vophucthinh2006/VEDC2026-Edge-AI-Autonomous-Rescue-Buoy-System/STM32F4/README.md

# RedgeSCUE — Firmware STM32F407

STM32 là lớp điều khiển thời gian thực của phao cứu hộ. Firmware nhận mục tiêu `NAV`
từ Raspberry Pi, đọc BNO055 / GPS / RC receiver, áp dụng watchdog an toàn, và chỉ sau
đó mới phát PWM tới ESC và servo.

- **MCU:** STM32F407VGTx, LQFP100 — board STM32F407G-Discovery
- **Toolchain:** CMake + Ninja + arm-none-eabi-gcc
- **Cấu hình:** STM32CubeMX 6.16.1, STM32Cube FW_F4 V1.28.3

---

## 1. Cấu trúc thư mục

```
STM32F4/
├── STM32F4.ioc            cấu hình CubeMX — NGUỒN SỰ THẬT cho pinout và clock
├── STM32F4.pdf            báo cáo cấu hình do CubeMX sinh (sơ đồ + clock tree)
├── STM32F4.txt            bảng chân dạng văn bản, cùng báo cáo
├── Core/                  code CubeMX sinh ra (main.c, gpio.c, i2c.c, spi.c, tim.c, usart.c, dma.c)
├── Drivers/               CMSIS + STM32F4xx HAL
├── Modules/               mỗi thư mục con là MỘT ngoại vi / thiết bị
│   ├── Actuators/         ESC (PWM trên TIM2) + servo bánh lái, ramp và đảo chiều
│   ├── BNO055/            driver IMU (I2C) + calibration profile
│   ├── GPS/               bộ phân tích NMEA
│   ├── INA226/            cảm biến áp / dòng pin (I2C, chung bus với BNO055)
│   ├── LoRa/              SX1278 (RA-02) qua SPI2
│   ├── Buzzer/            còi PWM
│   └── PiLink/            mã hoá / giải mã khung với Raspberry Pi
├── App/                   tầng ứng dụng
│   ├── control.c/.h       vòng điều khiển + watchdog an toàn, arm khi an toàn, chỉ có AUTO
│   ├── hw_test.c/.h       test bàn servo / ESC / còi qua debugger
│   ├── camera_pan.c/.h    servo camera trượt mượt tới góc CAM (bộ P giới hạn tốc độ, như khớp Gazebo)
│   ├── confirm_button.c/.h đếm số lần nhấn nút xác nhận PE4 (chống dội) để báo lên Pi
│   ├── imu.c/.h           lớp đệm trên driver BNO055
│   ├── lora_beacon.c/.h   beacon, khung sự kiện, cửa sổ nhận sau mỗi khung (mục 14)
│   ├── route_link.c/.h    ráp lộ trình từ dashboard, chuyển cho Pi (`$RTE`)
│   ├── shore_link.c/.h    ACK của trạm: còn liên lạc không, điểm về, lệnh đèn, người tàu khác đã nhận ($SKP, C thuần)
│   ├── event_queue.c/.h   sự kiện người / lật / nút xác nhận, gửi lại tới khi có ACK (C thuần)
│   ├── battery.c/.h       % pin từ INA226
│   ├── lights.c/.h        hai đèn trên relay PC3 / PC2, chỉ theo lệnh dashboard
│   └── app_config.h       ngưỡng, timeout, hằng số PWM
├── Tools/                 dump calibration, dashboard STM32CubeMonitor
├── docs/                  ảnh pinout trích từ STM32F4.pdf
├── build.bat              cmake + ninja → build/Debug/STM32F4.elf
└── flash.bat              nạp qua ST-LINK
```

### Quy tắc phân tầng

```
main.c  →  App/  →  Modules/  →  HAL
```

- `main.c` **chỉ** gọi API của `App/`, không gọi thẳng vào `Modules/`.
- `App/` chứa logic và chính sách: khi nào arm, khi nào dừng, ngưỡng lật, điều khiển heading.
- `Modules/` chứa code nói chuyện với phần cứng. **Một module không được biết gì về tầng
  ứng dụng** — bê sang dự án khác phải chạy được ngay.

> **Ngoại lệ đang tồn tại:** `Modules/Actuators` và `Modules/PiLink` đang include
> `App/app_config.h` để lấy `ESC_*`, `SERVO_*`, `RUDDER_*`, `NAV_TIMEOUT_MS`. Đây là một mũi tên
> ngược chiều, chấp nhận được ở quy mô hiện tại. Muốn dọn sạch thì đưa hằng số phần cứng
> của từng module về chính thư mục module đó, chỉ giữ ngưỡng điều khiển ở `App/`.

`App/imu.c` là lớp đệm giữa driver BNO055 và vòng điều khiển: giữ struct `bno055_euler_t`
phẳng mà `control.c` mong đợi, và map `yaw` của cảm biến thành `heading_deg` của bộ điều
khiển. Hướng dùng trong điều khiển là
`wrap(yaw_bno + IMU_MOUNTING_OFFSET_DEG + MAGNETIC_DECLINATION_DEG)`; góc và offset
dương theo chiều kim đồng hồ. Nhờ vậy `Modules/BNO055/` vẫn là driver thuần.

---

## 2. Pinout

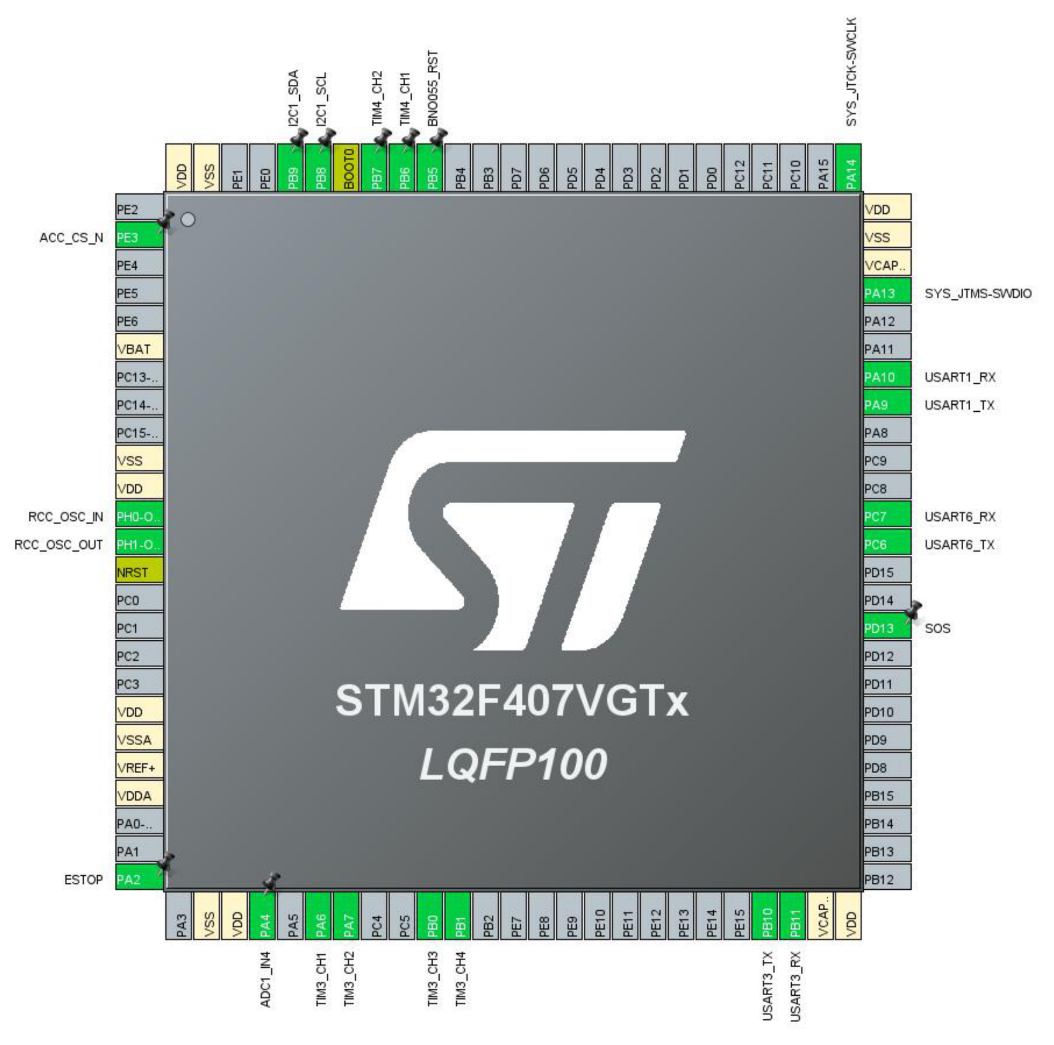
[picture p1: STM32F4/docs/pinout.png]
Pinout STM32F407VGTx


Ảnh trích từ báo cáo CubeMX nên chữ sắc nét. Nguồn sự thật vẫn là `STM32F4.ioc`;
`STM32F4.txt` là bảng chân dạng văn bản do CubeMX sinh, tiện để đối chiếu nhanh.

### Xuất lại ảnh khi đổi pinout

CubeMX **không có lệnh xuất sơ đồ chip ra file ảnh**. Menu `Pinout → Export pinout with /
without Alt. Functions` (`Ctrl+U`) chỉ ra CSV danh sách chân, không phải ảnh.

Đường đi cho ảnh nét là qua báo cáo PDF, vì sơ đồ trong đó là vector:

1. Trong CubeMX: **Project → Generate Reports** → ghi đè `STM32F4.pdf` và `STM32F4.txt`
2. Sơ đồ nằm ở **trang 3** của PDF. Trích ra PNG 300 DPI:

```
pdftoppm -png -r 300 -f 3 -l 3 STM32F4.pdf docs/raw
```

3. Cắt bỏ tiêu đề trang và lề trắng, rồi lưu thành `docs/pinout.png`
4. Xoá file `docs/raw-03.png`
5. Cập nhật bảng dưới đây cho khớp

Chụp màn hình cũng ra ảnh nhưng chữ sẽ mờ tới mức đọc nhầm `TIM4_CH1` thành `TIM1_CH1` —
mà PB6 không hề có TIM1. Đừng dùng cách đó cho tài liệu.

`STM32F4.pdf` và `STM32F4.txt` được commit cùng repo để người chưa cài CubeMX vẫn tra được
cấu hình đầy đủ: pinout, clock tree, tham số từng ngoại vi, và bảng tiêu thụ điện.

| Chức năng | Peripheral | Chân | Tham số | Nối tới |
|---|---|---|---|---|
| UART Raspberry Pi | UART4 | PC10 TX, PC11 RX | 115200 8N1, RX interrupt | Pi GPIO15/RXD0 ← PC10; Pi GPIO14/TXD0 → PC11 |
| GPS Holybro M10 V2 | USART3 | PB10 TX, PB11 RX | 9600 8N1, RX interrupt | GPS TX → PB11; GPS RX ← PB10 |
| (không dùng) USART2 | USART2 | PA2 (single-wire half-duplex) | 115200 8N1 | từng là iBUS của receiver FS-iA6B; đã bỏ tay cầm, firmware không đọc nữa (CubeMX vẫn khởi tạo) |
| IMU BNO055 | I2C3 | PA8 SCL, PC9 SDA | Fast Mode 400 kHz | địa chỉ 0x28 (ADD = GND) |
| Pin INA226 | I2C1 | PB8 SCL, PB9 SDA | 0x40 (A0 = A1 = GND) | IN+ / IN− nối tiếp đường pin; đo shunt của module rồi đặt `INA226_SHUNT_OHM` |
| Reset BNO055 | GPIO_Output | PB5 | mức cao khi chạy | chân nRESET của module |
| ESC sau trái | TIM2_CH1 | PA5 | PWM 50 Hz, một chiều, **dừng và kích hoạt = 1500 µs**, **ga 1550–2000 µs** | chỉ dây signal + GND |
| ESC sau phải | TIM2_CH4 | PA3 | PWM 50 Hz, một chiều, **dừng và kích hoạt = 1500 µs**, **ga 1550–2000 µs** | chỉ dây signal + GND |
| ESC trước | TIM2_CH2 | PA1 | PWM 50 Hz, **hai chiều**, dừng = 1500 µs, **tiến < 1500 µs** (`ESC_FRONT_DIR -1`), kích hoạt chậm hơn hai ESC sau 2–3 s | chỉ dây signal + GND |

**Ngưỡng ESC đã chốt trên giá (2026-10-20), không đổi khi chưa thử lại trên giá:**
- ESC sau: dừng và kích hoạt **1500 µs** (`ESC_REAR_STOP_US`), ga **1550–2000 µs** (`ESC_REAR_START_US`,
  `ESC_REAR_MAX_US`). **Không bao giờ kích hoạt ESC sau bằng 1000 µs**: kích hoạt từ 1000 µs thì ESC sau
  phải không nhận lệnh, nên chỉ motor sau trái quay.
- `ESC_REAR_STOP_US` chỉ là mức dừng của ESC sau. Giới hạn dưới chung của cả ba ESC là `ESC_MIN_US` (1000 µs),
  vì ESC trước đẩy tới bằng xung dưới 1500 µs: đừng dùng mức dừng của ESC sau để kẹp xung ESC trước.
- ESC trước (ZTW Shark) cần đứng ở trung tính lâu hơn mới kích hoạt: tới 2–3 s sau hai ESC sau. Sau khi bật nguồn
  hay nạp lại F407, đợi khoảng 6 s rồi mới cho chạy (`test_motor.bat` tự đợi).
| Servo camera | TIM3_CH1 | PA6 | PWM 50 Hz, 1500 µs ± 11 µs/độ, 600–2400 µs (±80°) | cấp nguồn servo độc lập |
| Bánh lái trước | TIM3_CH2 | PA7 | PWM 50 Hz, tâm `SERVO_CENTER_FRONT_US` | cấp nguồn servo độc lập |
| Bánh lái trái | TIM3_CH3 | PB0 | PWM 50 Hz, tâm `SERVO_CENTER_LEFT_US` | cấp nguồn servo độc lập |
| Bánh lái phải | TIM3_CH4 | PB1 | PWM 50 Hz, tâm `SERVO_CENTER_RIGHT_US` | cấp nguồn servo độc lập |
| Còi | TIM8_CH3 | PC8 | PWM 4 kHz | qua transistor |
| Nút xác nhận "đã lấy đồ" | GPIO_EXTI (nhãn CubeMX `ESTOP`) | PE4 | **pull-up**, nhấn = mức thấp | nút thường mở → GND |
| Đèn 1 (RELAY1) | GPIO_Output | PC3 | khởi tạo mức thấp | module relay; **chỉ bật theo lệnh admin trên dashboard** (mục 14) |
| Đèn 2 (RELAY2) | GPIO_Output | PC2 | khởi tạo mức thấp | như trên; relay đóng ở mức thấp thì đặt `RELAY_ON_LEVEL 0` |
| Chip select accelerometer | GPIO_Output | PE3 | **giữ mức cao** | không nối gì — xem mục 3 |
| Battery sense | ADC1_IN4 | PA4 | rank 1, 3 cycles — **chưa dùng trong code** | qua cầu chia áp |
| LoRa RA-02 (SX1278) | SPI2 | PB13 SCK, PB14 MISO, PB15 MOSI | mode 0, ~2.6 Mbit/s | NSS → PB12, RST → PC4, DIO0/1/2 → PE11/PE12/PE13 (DIO chưa dùng), 3.3 V, GND, **anten 433 MHz** |
| Debug | SWD | PA13 SWDIO, PA14 SWCLK | — | ST-LINK trên board (CN1) |
| Thạch anh | RCC | PH0, PH1 | khai báo sẵn, **chưa dùng** | xem mục 5 |

### Vì sao TIM2/TIM3 dùng prescaler 83 và period 19999

APB1 chạy 42 MHz, hệ số chia khác 1 nên **timer clock của APB1 là 84 MHz**:

```
84 MHz / (83 + 1)  = 1 MHz   →  1 tick = 1 µs
(19999 + 1) tick   = 20 ms   →  50 Hz
```

Giá trị compare vì vậy viết thẳng bằng micro-giây:
`__HAL_TIM_SET_COMPARE(&htim3, TIM_CHANNEL_1, 1500)` cho ra xung 1500 µs. Các hằng số
`ESC_REAR_STOP_US`, `SERVO_CENTER_US` trong `App/app_config.h` dùng trực tiếp, không phải quy đổi.

---

## 3. Ba ràng buộc của board Discovery

Board Discovery có sẵn cảm biến, codec âm thanh và cổng USB nối cứng vào một số chân.
Ba điều dưới đây là bắt buộc, không phải khuyến nghị.

**PE3 phải luôn ở mức cao.** Cảm biến gia tốc LIS3DSH trên board dùng chung SPI1 với
PA6/PA7, mà **PA6 là MISO — chân xuất của cảm biến**. Nếu PE3 (chip select) không được giữ
cao, cảm biến được chọn và sẽ đẩy tín hiệu chống lại PWM của TIM3_CH1, làm xung ESC trái
méo hoặc mất hẳn. `MX_GPIO_Init()` đặt PE3 lên cao trước khi timer chạy.
**Không bật SPI1 trong CubeMX.**

**Không cắm gì vào cổng USB OTG (CN5).** PA9/PA10 là VBUS và ID của cổng đó. Cắm thiết bị
vào là 5 V trên VBUS chống lại chân USART1_TX. Chỉ dùng CN1 (ST-LINK) để nạp và cấp nguồn.

**BNO055 dùng I2C3: PA8 là SCL, PC9 là SDA.** Hai chân này thay thế hoàn toàn PB8/PB9
cho IMU. Đường I2C phải có pull-up lên 3.3 V (nhiều GY-BNO055 đã có sẵn); nếu `BNO055_Init()`
trả `ERR_I2C`, kiểm tra dây, nguồn 3.3 V/GND và pull-up 4.7 kΩ. PB8/PB9 vẫn là I2C1 riêng
cho INA226. **Không bật I2S2/I2S3** vì PC7 và PB10 dính vào codec và micro MEMS.

---

## 4. PE4: nút xác nhận, không phải E-stop

PE4 (nhãn CubeMX vẫn là `ESTOP`) là nút người được cứu nhấn khi **đã lấy đồ tiếp tế**. Pull-up
nội, nút thường mở nối xuống GND: nhấn là mức thấp. `App/confirm_button.c` chống dội
(`CONFIRM_DEBOUNCE_MS`) và đếm số lần nhấn; số đếm đi lên Pi ở trường thứ 8 của `$SYS`, Pi
phát loa "Đã xác nhận lấy đồ" mỗi khi số đếm tăng. Nút **không dừng gì cả**.

Mỗi lần nhấn, F407 còn gửi sự kiện `C` qua LoRa (mục 14): dashboard báo "đã lấy đồ" kèm vị trí phao.

Xuồng không có đầu vào E-stop riêng và không còn tay cầm. Motor dừng khi: admin gửi **lộ trình rỗng** từ
dashboard (tới phao sau khoảng 5–10 s qua LoRa), thuyền đi hết lộ trình, Pi im hoặc gửi STOP, xuồng lật,
IMU lỗi, hoặc tắt nguồn (mục 13).

---

## 5. Clock

Hiện chạy **HSI 16 MHz** → PLL (M=8, N=168, P=2) → **168 MHz**. APB1 42 MHz, APB2 84 MHz.

HSI được trim ±1% ở 25 °C và trôi thêm theo nhiệt độ. UART bất đồng bộ có tổng ngân sách
sai lệch khoảng 3% chia cho cả hai đầu, nên ở 115200 (với Pi) biên
còn lại khá mỏng — mà phao phơi nắng rồi xuống nước là môi trường trôi nhiệt độ mạnh.

**Việc cần làm trước khi thử ngoài nước:** chuyển sang HSE 8 MHz trong CubeMX
(PLLM=8, PLLN=336, PLLP=2, PLLQ=7). Nếu nạp xong thấy treo trong `SystemClock_Config()`
thì HSE không phải thạch anh mà lấy từ MCO của ST-LINK — đổi RCC sang
`BYPASS Clock Source`, vẫn 8 MHz.

PH0/PH1 đã khai báo sẵn là HSE oscillator, để dành cho lần chuyển đó.

---

## 6. Quy trình làm việc

### Nguyên tắc vàng

> **`STM32F4.ioc` là nguồn sự thật cho pinout, clock và cấu hình ngoại vi.
> Không bao giờ sửa tay file trong `Core/`.**

CubeMX ghi đè `Core/` mỗi lần Generate. Code viết tay đặt sai chỗ sẽ biến mất không báo
trước. Chỉ có hai nơi an toàn: thư mục `Modules/` và `App/`, hoặc bên trong các block
`/* USER CODE BEGIN x */ ... /* USER CODE END x */` của file CubeMX sinh ra.

### A. Khi cần thêm hoặc đổi một ngoại vi

Đổi chân, đổi baud, thêm UART, thêm timer, đổi clock, bật interrupt, bật DMA — tất cả đều
làm trong CubeMX, **không sửa tay**.

1. Mở `STM32F4.ioc` bằng STM32CubeMX
2. Sửa trong tab **Pinout & Configuration** hoặc **Clock Configuration**
3. Nếu chân đang bị ngoại vi khác chiếm: click vào chân đó chọn `Reset_State` để giải
   phóng trước, nếu không CubeMX báo conflict
4. Bật interrupt ở tab **NVIC Settings** của chính ngoại vi đó nếu cần
5. Kiểm tra tab **Project Manager**: Toolchain/IDE phải là **CMake**, và
   **Keep User Code when re-generating** phải được tick
6. **GENERATE CODE** (`Alt + K`)
7. Xuất lại ảnh pinout vào `docs/pinout.png` và cập nhật bảng ở mục 2
8. Build lại

Sau khi Generate, `Core/Src/main.c` sẽ có thêm lời gọi `MX_<PERIPH>_Init()` và một file
`Core/Src/<periph>.c` mới. Đừng hoảng khi thấy `main.c` thay đổi — phần code trong các
block `USER CODE` được giữ nguyên.

### B. Khi viết code ứng dụng

Câu hỏi đầu tiên: **code này nói chuyện với phần cứng, hay quyết định chính sách?**

| Loại code | Đặt ở | Ví dụ |
|---|---|---|
| Driver một thiết bị, giải mã một giao thức | `Modules/<Tên>/` | đọc cảm biến mới, parse khung LoRa |
| Logic điều khiển, ngưỡng, chính sách an toàn | `App/` | thêm chế độ chạy, đổi luật arm |
| Hằng số chỉnh định | `App/app_config.h` | ngưỡng lật, timeout |
| Khởi tạo lúc boot, vòng lặp chính | block `USER CODE` trong `Core/Src/main.c` | gọi `Xxx_Init()` |

**Thêm một module mới — checklist:**

1. Tạo `Modules/<Tên>/<ten>.c` và `<ten>.h`
2. Thêm vào `CMakeLists.txt` ở **hai** chỗ:
   - `target_sources(...)` → `Modules/<Tên>/<ten>.c`
   - `target_include_directories(...)` → `Modules/<Tên>`
3. Gọi `<Ten>_Init()` trong block `USER CODE BEGIN 2` của `main.c`
4. Nếu module cần chạy định kỳ, gọi trong block `USER CODE BEGIN 3` theo nhịp
   `CONTROL_PERIOD_MS`
5. Nếu module nhận dữ liệu qua UART interrupt, thêm nhánh vào `HAL_UART_RxCpltCallback()`
   trong block `USER CODE BEGIN 4`

**Các block USER CODE trong `main.c` và vai trò:**

| Block | Dùng cho |
|---|---|
| `Includes` | `#include` của `Modules/` và `App/` |
| `PV` | biến toàn cục của ứng dụng |
| `0` | hàm static dùng nội bộ trong `main.c` |
| `2` | khởi tạo, chạy sau khi các `MX_*_Init()` đã xong |
| `3` | thân vòng lặp chính — **dấu `}` đóng `while(1)` nằm bên trong block này** |
| `4` | callback của HAL, ví dụ `HAL_UART_RxCpltCallback` |

Cái bẫy ở block `3` đáng nhớ: CubeMX đặt dấu ngoặc đóng của `while(1)` *bên trong* vùng
USER CODE. Thay toàn bộ nội dung block mà quên chép lại dấu `}` sẽ ra lỗi
`expected declaration or statement at end of input` ở tận cuối file.

### C. Build

```
build.bat            # Debug, mặc định
build.bat Release
```

Kết quả: `build/Debug/STM32F4.elf`. Script tự chạy `cmake` rồi `ninja`.

Build phải sạch, không có warning.

### D. Nạp

```
flash.bat
```

Cần ST-LINK cắm vào CN1. **Đóng STM32CubeMonitor trước khi nạp** — nó giữ probe.

---

## 7. STM32CubeMonitor

`Tools/CubeMonitor/BNO055_Flow.json` vẽ trực tiếp các biến toàn cục của firmware qua SWD,
không cần dừng chương trình.

1. Mở STM32CubeMonitor → menu ☰ → **Import** → chọn `Tools/CubeMonitor/BNO055_Flow.json`
2. Double-click node **myProbe_Out**, bấm refresh ở ô Probe, chọn ST-LINK đang cắm.
   Làm y hệt với **myProbe_In** — hai node phải cùng một probe
3. Bấm **Deploy**
4. Mở Dashboard (biểu tượng ở panel phải, hoặc `http://localhost:1880/ui`)
5. Bấm **START Acquisition**

### ⚠ Địa chỉ sẽ lệch sau khi sửa firmware

CubeMonitor đọc biến bằng **địa chỉ RAM thô**, không phải bằng tên symbol. Bất kỳ thay đổi
nào thêm hoặc bớt biến toàn cục đều làm layout RAM dịch, và flow sẽ lặng lẽ vẽ nội dung
nằm ở địa chỉ cũ — dashboard trông vẫn chạy nhưng số liệu sai. Kiểu hỏng này khó phát hiện
hơn lỗi báo thẳng.

Đọc lại địa chỉ sau khi sửa:

```
arm-none-eabi-gdb --batch -ex "print/x (int)&bno055_euler.roll" build/Debug/STM32F4.elf
```

Hoặc trỏ node `variables` vào file ELF và bấm Import để CubeMonitor tự phân giải tên.

### Các biến được xuất có chủ đích

`App/imu.c` cố ý để những biến sau là **toàn cục, không `static`**, đúng tên:

| Biến | Dùng bởi |
|---|---|
| `hbno055` | dashboard — `ext_crystal_active`, `sys_err` |
| `bno055_euler` | dashboard — Roll / Pitch / Yaw |
| `bno055_calib` | dashboard — trạng thái hiệu chuẩn |
| `bno055_init_status`, `bno055_read_status` | dashboard |
| `bno055_calib_captured`, `bno055_calib_captured_valid` | `Tools/bno055_dump_calib.ps1` đọc từ ELF |

**Đừng gói chúng vào struct hay thêm `static`** — sẽ làm hỏng cả dashboard lẫn script dump
calibration mà không có lỗi biên dịch nào cảnh báo.

---

## 8. Hiệu chuẩn BNO055

Calibration profile được chia sẻ qua git ở `Modules/BNO055/bno055_calib_profile.h`, nên mọi
bộ kit nạp cùng một profile và có heading dùng được ngay khi khởi động, không phải vẫy hình
số 8 trước mỗi lần chạy.

Profile thuộc về **module BNO055 và cách gá lắp của nó**, không thuộc về board STM32. Sinh
lại khi đổi module hoặc đổi vị trí gá:

1. Nạp firmware, để chạy
2. Hiệu chuẩn tới khi `bno055_calib` báo `3/3/3/3` (xem trên dashboard)
3. Đóng CubeMonitor
4. Chạy `Tools\bno055_dump_calib.bat` — target vẫn đang chạy, không cần dừng
5. Commit `Modules/BNO055/bno055_calib_profile.h` mới

---

## 9. Bảng tra lỗi

`bno055_init_status` là enum `BNO055_Status_t`:

| Giá trị | Tên | Nguyên nhân thực tế |
|---|---|---|
| 0 | `BNO055_OK` | chạy tốt |
| 1 | `ERR_PARAM` | lỗi code, không xảy ra khi dùng bình thường |
| 2 | `ERR_I2C` | NACK hoặc lỗi bus — sai dây SCL/SDA tại PA8/PC9, thiếu pull-up lên 3.3 V, hoặc còn cắm ở PB8/PB9 cũ |
| 3 | `ERR_TIMEOUT` | cảm biến không sẵn sàng kịp — nguồn yếu, hoặc chân reset kẹt mức thấp |
| 4 | `ERR_CHIP_ID` | bus thông nhưng CHIP_ID ≠ 0xA0 — nhiều khả năng sai địa chỉ, thử 0x28 |
| 5 | `ERR_MODE` | ghi OPR_MODE nhưng đọc lại không khớp |
| 6 | `ERR_SYS` | cảm biến báo lỗi hệ thống — đọc thêm `hbno055.sys_err` |
| 7 | `ERR_PROFILE` | calibration profile nằm ngoài dải hợp lệ của data sheet |

Triệu chứng khác:

| Hiện tượng | Nguyên nhân thường gặp |
|---|---|
| Xuồng không bao giờ arm được | BNO055 không đọc được (`heading_debug.arm_block` = 1, IMU stale) hoặc xuồng nghiêng quá `MAX_PITCH_DEG` / `MAX_ROLL_DEG` (= 2) — xem mục 8 và 13 |
| Đã arm mà motor không chạy | Pi không lái: chưa có lộ trình từ dashboard, Pi gửi STOP (`gps_stale_or_no_fix`, `no_goal`...) hoặc Pi im (`heading_debug.block` = 2) |
| GPS không có fix, `gps.fix` = 0 | baud USART3. Holybro M10 nhiều khả năng mặc định **38400** chứ không phải 9600 — xác minh bằng u-center |
| PWM ESC trái méo hoặc mất | PE3 không ở mức cao → LIS3DSH đang đẩy tín hiệu vào PA6 |
| `bno055_read_status` thỉnh thoảng nhảy 2 | nhiễu I2C — dây dài, thiếu pull-up tại PA8/PC9 |
| Dashboard vẽ số vô lý | địa chỉ trong flow đã lệch sau khi sửa firmware — xem mục 7 |
| Treo trong `SystemClock_Config()` | chỉ xảy ra sau khi chuyển sang HSE — đổi sang `BYPASS Clock Source` |

---

## 10. Nguồn và an toàn phần cứng

- GY-BNO055 nhận 3–5 V nhưng bus I2C của STM32 là 3.3 V: **cấp module ở 3.3 V**. Không để
  pull-up SDA/SCL lên 5 V.
- **Không cấp DS51150 12 V hoặc ESC từ chân của board Discovery.** UBEC hoặc power board
  phải cấp đúng áp và đủ dòng. Tất cả thiết bị tín hiệu cần chung GND.
- **Pixhawk 4 không được nối PWM điều khiển song song với STM32.** Firmware này giả định
  STM32 là **nguồn phát PWM duy nhất**. Giữ Pixhawk tách khỏi đường signal, hoặc chuyển
  toàn bộ quyền điều khiển sang Pixhawk. Không chạy hai autopilot song song.
- **`ACTUATORS_ENABLED` đang là 1** (đã thử chiều motor trên gá). Đặt về 0 thì ESC luôn nhận tín hiệu dừng,
  còn bánh lái vẫn chạy theo lệnh; giá trị ESC lẽ ra được phát nằm trong `actuator_debug`
  để kiểm tra bằng debugger. Chỉ đổi sang 1 sau khi đã xác nhận chiều quay motor và chiều servo
  trên giá đỡ, và **không tháo chân vịt khi kiểm thử bàn**.
- Khi test IMU hoặc UART, **đừng cắm ESC**. PWM vẫn phát thật trên
  PA1/PA3/PA5 (ESC) và PA6/PA7/PB0/PB1 (servo).

---

## 11. Giao thức với Raspberry Pi

Raspberry Pi → STM32:

```
$NAV,seq,AUTO|STOP|MANUAL|BACK,speed_mps,heading_deg,ttl_ms*CS\n
$HBT,seq,reason[,route_rev[,mission,wp/total[,fps_x10]]]*CS\n
$SOS,seq,0|1*CS\n
$TXD,seq,event,lat,lon,confidence[,risk]*CS\n
$CAM,seq,pan_deg*CS\n
```

`BACK`: lùi ra khỏi vật cản đang chắn mũi. Hai motor sau tắt (ESC một chiều), bánh lái về giữa, motor
trước quay ngược với ga bằng `speed_mps` (tối đa `FRONT_BACK_MAX` 0.40, `App/app_config.h`). Phải qua
cùng các điều kiện như `AUTO`: đã arm, IMU còn mới, NAV trong TTL, HBT còn mới, không bị DỪNG từ dashboard.
Pi chỉ gửi khi thuyền đứng yên, không còn hướng thoát phía trước và phía sau trống (`navigation.py`,
lý do `backing_off`), mỗi lần tối đa 3 s. F407 cũ không biết `BACK` thì coi là `STOP`.

STM32 → Raspberry Pi:

```
$IMU,seq,pitch,roll,yaw,imu_ok,overturned*CS\n
$GPS,seq,lat,lon,fix,hdop,speed,course*CS\n
$SYS,seq,battery_v,motor_fault,estop,link_ok,armed,auto,confirm_presses,battery_pct*CS\n
$LNK,seq,shore_ok,heard_ago_s,home_valid,home_lat,home_lon,hold,ret*CS\n     (mỗi giây)
$SKP,seq,lat,lon*CS\n                                                  (một lần mỗi khi ACK mang người cần bỏ qua)
$ACK,seq,TXD,ACCEPTED*CS\n
$RTE,seq,rev,first,total,loop,lat;lon,...*CS\n
```

`$RTE` là lộ trình admin gửi từ dashboard qua trạm bờ LoRa (`App/route_link.c`, đặc tả ở
[docs/lora-route-downlink.md](../docs/lora-route-downlink.md)): mỗi chu kỳ telemetry một dòng tối đa 7 điểm, gửi lại
tới khi `$HBT` của Pi mang `route_rev` bằng `rev`. Sau mỗi beacon LoRa phao nghe 1.5 s để nhận khung `RTE` của trạm;
đang nhận dở thì beacon 1.5 s một lần, và cuối beacon có `w=rev:have:pi`.

`armed` (xuồng an toàn để chạy: IMU mới, không lật) và `auto` (luôn 1, không còn công tắc SwB) để Pi biết lúc nào cho
camera quét tìm. `estop` luôn 0
(PE4 giờ là nút xác nhận); `confirm_presses` là số lần nhấn nút đó từ lúc khởi động. Mỗi gói
`TXD` có sự kiện `VICTIM_FOUND` làm tăng số người đã báo, số này đi theo khung LoRa (mục LoRa, trường `v`).

`CAM` là góc quay camera, dương sang phải, giới hạn `CAM_PAN_LIMIT_DEG`. `App/camera_pan.c` cho servo
trượt tới góc đó (`CAM_PAN_SMOOTH_KP`, tối đa `CAM_PAN_MAX_RATE_DPS`); Pi gửi 20 lần/s khi quét hoặc bám người.

`$TXD,...,VICTIM_FOUND|VICTIM_UPDATE,lat,lon,confidence,risk`: vị trí người Pi ước tính (0, 0 = không có), `risk` 0
an toàn, 1 trung bình, 2 cao, 3 nguy kịch (Pi cũ không gửi: coi là 2). `VICTIM_FOUND` là người mới (tăng số người
`v`), `VICTIM_UPDATE` là mức rủi ro hoặc vị trí mới của người đang bám (không đếm lại). Cả hai thành sự kiện `V` qua
LoRa (mục 14).

`$SYS`: `battery_v` là điện áp INA226 (0 khi chưa đọc được), `battery_pct` 0..100 (−1 chưa biết).
`$LNK`: `shore_ok` = 0 khi trạm bờ đã từng nghe mà im quá 60 s (`SHORE_LINK_TIMEOUT_MS`); Pi đưa thuyền về
`home` = điểm đỗ của phao hoặc vị trí GPS của trạm (lấy từ ACK). `heard_ago_s` −1 khi chưa từng nghe; lat/lon trống
khi chưa có điểm về. `ret` = 1 khi admin gọi phao về bờ (bit 3 của lệnh, [docs/fleet-control.md](../docs/fleet-control.md)):
Pi đưa thuyền về điểm đỗ và giữ ở đó tới khi admin cho chạy tiếp.

Checksum là XOR của các ký tự ASCII giữa `$` và `*`, giống `Rasp_Pi/utils/nmea_packet.py`.

`NAV` và `HBT` phải mới hơn 300 ms. Nếu sai checksum, BNO055 lỗi, nghiêng
quá `MAX_PITCH_DEG` / `MAX_ROLL_DEG`, hoặc Pi im — output ESC lập tức về stop.

Giữ hướng dùng PID trong `App/heading_controller.c`: `u = Kp·e + Ki·∫e − Kd·yaw_rate`,
`u ∈ [-1, 1]`, dương là quay mũi sang phải. Khâu D lấy từ **gyro Z** của BNO055 (qua lọc thông
thấp 5 Hz), nên đổi đích không gây giật. Trong deadband 2° khâu P nghỉ, tích phân được giữ.
`Heading_Mix` đưa `u` ra cả **bánh lái** (`u·HEADING_RUDDER_GAIN`) và **chênh ga** hai motor
sau (`u·HEADING_DIFF_GAIN`, chia quanh ga chung, không motor nào dưới 0). Pi gửi tốc độ 0 thì
motor dừng, không xoay tại chỗ. Tham số trong `App/app_config.h`.

Hướng đích là gói `NAV` của Pi (AUTO, chế độ duy nhất).

Theo dõi trực tiếp: `python Tools/heading_monitor.py` (thêm `--csv run.csv` để ghi log).
AUTO yêu cầu IMU mới không quá 100 ms cùng NAV/HBT còn hạn. Pi gửi STOP, disarm hoặc mất
bất kỳ nguồn dữ liệu nào sẽ dừng motor và xóa tích phân. Các hằng số nằm trong
`App/app_config.h`; chỉ tuning trên nước sau khi đã thử khô với chân vịt tháo rời.

---

## 12. Quy ước đóng góp

Theo các skill của Claude trong `.claude/skills/` (`stm32-cubemx-first`, `git-commit-pr`):

1. **Cấu hình CubeMX trước, code sau.** Việc gì làm được trong `.ioc` thì làm ở đó, đừng
   sửa tay `Core/`.
2. **Chia thay đổi thành nhiều commit theo từng phần logic**, không gộp thành một commit
   khổng lồ. Commit đổi `.ioc` nên tách khỏi commit code CubeMX sinh ra, để người review
   đọc được quyết định pinout mà không bị chìm trong vài nghìn dòng HAL.
3. Mỗi PR có description ngắn gọn nêu rõ những gì thay đổi về phần cứng.

Trước khi mở PR, kiểm tra tối thiểu:

- `build.bat` chạy sạch, không có warning
- Nếu sửa `.ioc`: đã chạy **Project → Generate Reports**, commit `STM32F4.pdf` +
  `STM32F4.txt` mới, trích lại `docs/pinout.png`, và cập nhật bảng mục 2
- Nếu thêm hoặc bớt biến toàn cục: đã kiểm tra lại địa chỉ trong
  `Tools/CubeMonitor/BNO055_Flow.json`
- Nếu đổi chân: đã ghi rõ trong PR rằng **phần cứng phải đổi dây**

---

## 13. Không có tay cầm: arm và chạy

Thuyền **không còn tay cầm RC** (FS-i6 / FS-iA6B, chế độ MANUAL đã bỏ). `App/control.c`:

- **Arm** khi an toàn: IMU mới (hoặc `BENCH_IGNORE_IMU` trên gá) và không lật. Không cần công tắc;
  còi kêu 1 tiếng khi arm, 2 tiếng khi disarm. Lý do không arm: `heading_debug.arm_block`.
- **AUTO là chế độ duy nhất.** Motor chỉ chạy khi Pi đang lái: gói `NAV` AUTO còn hạn (TTL 300 ms) và
  `HBT` mới hơn `HBT_TIMEOUT_MS`. Lý do không chạy: `heading_debug.block`.
- **Pi chỉ lái theo lộ trình gửi từ dashboard** (`config/boat_stm32.yaml`: `mission.waypoints_from_file: false`,
  `follow.only_on_route: true`). Chưa có lộ trình, đã nhận lộ trình rỗng hoặc đã đi hết thì Pi gửi STOP và
  không bám người. Đang chạy lộ trình thì vẫn bám người thấy được.

| Muốn | Làm |
|---|---|
| Chạy | dashboard: vẽ lộ trình, **Gửi tới phao** (tới phao sau khoảng 5–40 s tùy số điểm) |
| Dừng tại chỗ, giữ lộ trình | dashboard: nút **DỪNG PHAO** (F407 khóa motor sau khoảng 5–10 s); **CHẠY TIẾP** để đi tiếp |
| Bỏ lộ trình | dashboard: xóa lộ trình rồi **Gửi tới phao** (lộ trình rỗng, tới phao sau khoảng 5–10 s) |
| Dừng ngay tại chỗ | tắt nguồn ESC / thuyền: **không còn công tắc ngắt cầm tay** |

Chi tiết đường đi của lộ trình và việc phao không tự chạy lại lộ trình cũ sau khi bật nguồn:
[docs/lora-route-downlink.md](../docs/lora-route-downlink.md).

Tăng ga bị giới hạn tốc độ (`ESC_RAMP_PER_S`), giảm ga có hiệu lực ngay. Chiều bánh lái `RUDDER_DIR_*` nằm trong
`App/app_config.h`.

**Motor trước** (hai chiều, `App/front_motor.c`):
- **Đẩy tới cùng hai motor sau:** ga trước = ga sau × `FRONT_THRUST_GAIN`.
- **Hãm** mỗi khi ga giảm ít nhất `FRONT_BRAKE_MIN_DROP`, gồm cả lúc Pi giảm tốc, gửi tốc độ 0 / STOP, Pi im, hay DỪNG từ
  dashboard. Motor trước đảo chiều ở `FRONT_BRAKE_LEVEL` trong `FRONT_BRAKE_MS_PER_THROTTLE` ms cho mỗi đơn vị ga giảm
  (0.3 → 600 ms), tối đa `FRONT_BRAKE_MAX_MS`, cộng thêm `ESC_FRONT_REVERSE_DELAY_MS` để ESC nghỉ ở neutral trước khi đảo.
- **Không hãm** khi lật, mất IMU hay disarm: mọi motor tắt ngay.
- Hai ESC sau chạy một chiều nên không tự phanh được. Muốn tắt motor trước như cũ: đặt `GAIN` và `LEVEL` bằng 0.
- Chỉnh trên nước: phao phải dừng trong khoảng một thân mà không lùi lại.

**Trước khi bật `ACTUATORS_ENABLED`**, thử từng motor và bánh lái trên gá bằng `..\scripts\stm32\test_motor.bat`
(preset `HwTest`, `App/hw_test.c`): đúng chiều quay, đúng chân PA1 / PA3 / PA5. Sau đó với Pi chạy
`config/bench_demo.yaml`, đứng lệch sang phải camera thì bánh lái phải kéo mũi sang phải (sai thì đổi dấu
`RUDDER_DIR_FRONT` / `RUDDER_DIR_REAR`).

---

## 14. LoRa: phát vị trí và tư thế về trạm bờ

`App/lora_beacon.c` + `Modules/LoRa/sx127x.c` phát vị trí GPS về trạm bờ (ESP32-S3) mỗi
`LORA_BEACON_PERIOD_MS` (5 giây). Không chặn: mỗi vòng lặp chỉ làm vài lệnh SPI ngắn, gói ~0.4 giây
trên không được theo dõi bằng máy trạng thái nên `Control_Tick` (10 ms) không bị trễ.

Tham số radio (`App/app_config.h`) **phải khớp trạm** (`esp32-lora-station/main/main.c`):
433 MHz, SF9, BW 125 kHz, CR 4/5, sync word `0xF3`, PA_BOOST 17 dBm, CRC payload bật.

Khung gửi, một dòng text tối đa 120 ký tự:

```
id=PHAO-01,10.762622,106.660172,r=2.1,p=-1.4,y=278.5,t=280.0,m=A,i=1,c=3,q=12,v=0,w=7:12:1,L=1,b=87,g=276.0,s=0.25
id=PHAO-01,NO_FIX,r=2.1,p=-1.4,y=278.5,t=-1.0,m=S,i=0,c=0,q=13,v=1,L=0,b=87
```

Sau `v` là các trường tùy chọn, mỗi trường chỉ thêm khi còn chỗ, theo thứ tự ưu tiên: `w` tiến độ lộ trình,
`H` đang bị dừng từ dashboard (1/0), `L` đèn đang bật (bit 0 PC3, bit 1 PC2), `b` % pin, `g` hướng đi thật theo GPS (course over ground), `s` tốc độ m/s.
`m=R`: đang tự chạy về trạm vì mất liên lạc.

**Sự kiện** đi trong khung riêng, phát ngay và phát lại mỗi 1.5 s tới khi trạm ACK (tối đa 10 lần,
`App/event_queue.c`):

```
ev=PHAO-01,<eseq>,V,<lat>,<lon>,<risk>,<conf>,<n>     người (vị trí Pi ước tính, mức rủi ro, độ tin cậy)
ev=PHAO-01,<eseq>,T,<lat>,<lon>,<roll>,<pitch>         lật / nghiêng quá 35°, GPS của phao; lặp lại sau 30 s nếu vẫn lật
ev=PHAO-01,<eseq>,C,<lat>,<lon>,<presses>              nút PE4: người đã lấy đồ tiếp tế
```

**Trạm trả lời mọi khung** trong cửa sổ 1.5 s: khung `RTE` khi phao còn thiếu lộ trình, ngược lại
`ACK,<id>,<eseq>,<lệnh>,<lat>,<lon>[,<dẫn đầu>,<phải m>,<sau m>]*CS` (`App/shore_link.c`). `<lệnh>` 0..15: bit 0–1 hai
đèn, bit 3 VỀ BỜ, ba trường cuối chỉ khi phao đi đội hình ([docs/fleet-control.md](../docs/fleet-control.md)); **bit 2 DỪNG**
(nút "DỪNG PHAO" trên dashboard: F407 khóa motor, `heading_debug.block` = 4, tới khi admin bấm "Chạy tiếp"; lộ trình
giữ nguyên). Beacon báo lại `H=1` khi đang dừng. Phao bật relay đúng theo lệnh, lấy vị trí trạm làm điểm về, và coi mọi
khung của trạm là còn liên lạc. Im quá 60 s: `$LNK` báo mất, Pi đưa thuyền về. Đèn giữ
nguyên trạng thái lúc mất liên lạc; F407 khởi động lại thì đèn tắt tới ACK kế tiếp.

`v` là số người Pi đã báo phát hiện từ lúc khởi động (dừng ở 255). Khung nào cũng mang số này
nên mất một gói không mất cảnh báo; khi số tăng, khung mới được phát ngay, không chờ đủ chu kỳ.

`r/p/y` là Roll/Pitch/Yaw thật, `t` là hướng đích (`-1.0` khi không có; `y` và `t` được
làm tròn 0.1° rồi mới quấn nên không bao giờ in ra `360.0`), `m` là
`A`/`M`/`S`, `i` báo IMU hợp lệ, `c` là calibration hệ thống 0..3 và `q` là sequence.
Hai số thập phân không có dấu `=` vẫn là lat/lon để tương thích parser cũ; khi mất GPS,
`NO_FIX` vẫn đi cùng dữ liệu IMU. `LORA_BUOY_ID` là tên hiển thị trên dashboard.

**Gắn anten 433 MHz vào RA-02 trước khi cấp nguồn/nạp firmware**: phát không anten có thể làm hỏng tầng công suất.

### Kiểm tra trên thuyền

Không có UART log ra máy tính, nên đọc RAM qua ST-LINK (firmware vẫn chạy, không halt):

```
python Tools/lora_monitor.py --once
```

Kết quả mong đợi: `chip 0x12 OK`, `tx` tăng đều mỗi 5 giây, `fail 0`; có trạm thì `station OK`, `ACK` tăng theo
beacon, `home` là GPS của trạm. Pin: `python Tools/battery_monitor.py`. Thứ tự thử từng chức năng trên phần cứng:
[docs/stm32-system.md](../docs/stm32-system.md) (`scripts\stm32\test_*.bat`). Nếu `chip 0x00`/`0xFF` là sai dây SPI/NSS,
thiếu nguồn 3.3 V hoặc chưa cắm module. Nếu `GPS ... last sentence never` là USART3 không nhận được câu GGA,
thường do sai baud (xem bảng lỗi ở mục 9).
