vophucthinh2006/VEDC2026-Edge-AI-Autonomous-Rescue-Buoy-System/sim/README.md

# Giả lập 3D phao cứu hộ — ArduPilot + Gazebo + Mission Planner

Phao chạy trong **Gazebo Harmonic** (mặt nước có sóng, lực nổi, chân vịt), được điều khiển bởi
**ArduPilot Rover 4.7.1** chạy giả lập (SITL), và **Mission Planner** trên Windows nối vào qua MAVLink —
giống hệt khi nối với phao thật.

```
Windows                         WSL Ubuntu 24.04
┌────────────────┐  UDP 14550   ┌──────────┐  TCP 5760  ┌────────────┐  UDP 9002   ┌──────────────────┐
│ Mission Planner│◄────────────►│ MAVProxy │◄──────────►│ ardurover  │◄───────────►│ Gazebo           │
└────────────────┘  (MAVLink)   └──────────┘            │ (SITL)     │ (lock-step) │ sóng + vedc_buoy │
                                                        └────────────┘             │ camera + LiDAR   │
                                                                                   └──────────────────┘
```

Mã nguồn bên thứ ba nằm ở `~/vedc_sim` trong WSL (không đưa vào repo): `ardupilot`, `ardupilot_gazebo`,
`SITL_Models` (mô hình BlueBoat), `asv_wave_sim` (sóng và thủy động lực học).

## Cài đặt (một lần)

```bash
wsl -d Ubuntu-24.04 -- bash /mnt/d/EMBEDDED/Competition/TKDT_2026/VEDC_2026/sim/install_deps.sh
wsl -d Ubuntu-24.04 -- bash /mnt/d/EMBEDDED/Competition/TKDT_2026/VEDC_2026/sim/build.sh
```

- `install_deps.sh` cần sudo: CGAL, FFTW, GStreamer, colcon và script cài đặt chính thức của ArduPilot
  (tạo `~/venv-ardupilot` có MAVProxy, pymavlink).
- `build.sh` không cần sudo, khoảng 10 phút: ArduPilot SITL, plugin Gazebo, plugin sóng.
  Build lại một phần: `build.sh ardupilot | gazebo | waves`.
- Gazebo Harmonic có sẵn từ ROS 2 Jazzy, không cài riêng.
- `.wslconfig` phải có `networkingMode=mirrored` để Windows thấy `127.0.0.1` của WSL.

## Chạy

```bash
wsl -d Ubuntu-24.04 -- bash /mnt/d/EMBEDDED/Competition/TKDT_2026/VEDC_2026/sim/run_boat.sh
```

Mở cửa sổ Gazebo 3D, một cửa sổ xterm của ArduPilot, và dấu nhắc `MAV>` của MAVProxy trong terminal.
`Ctrl+C` ở terminal để tắt tất cả.

| Tùy chọn | Tác dụng |
|---|---|
| `--headless` | Gazebo không mở cửa sổ (máy yếu, hoặc kiểm thử tự động) |
| `--wipe` | Xóa tham số đã lưu, nạp lại mặc định + `params/vedc_buoy.parm` |
| `HOME_LOCATION=lat,lon,alt,hướng` | Đổi điểm xuất phát. Mặc định giữa **Hồ đá 01, Làng Đại học ĐHQG-HCM** `10.883438,106.796019,10,90` (cách bờ 217 m, phía đông trống khoảng 265 m) |

**Mission Planner:** góc trên phải chọn **UDP** → **Connect** → cổng **14550**.

## Thử nhanh trong Mission Planner

1. Tab **DATA**, đợi HUD hết báo lỗi EKF (khoảng 20–30 giây sau khi khởi động)
2. **Actions** → **Arm/Disarm**
3. Chuột phải lên bản đồ → **Fly to Here** (chế độ GUIDED) — phao chạy tới đó, xem trong Gazebo
4. Tab **PLAN**: click để thêm waypoint → **Write WPs** → về DATA, đổi chế độ sang **Auto**
5. Đổi sang **RTL** — phao quay về điểm xuất phát
6. Thử failsafe mất liên lạc: khi phao đang chạy, ngắt Mission Planner (**Disconnect**) và gõ
   `set heartbeat 0` ở dấu nhắc `MAV>` (MAVProxy cũng phát heartbeat GCS). Sau 5 giây phao tự RTL.
   Gõ `set heartbeat 1` để bật lại.

## Kịch bản cứu hộ với code của Pi

```bash
wsl -d Ubuntu-24.04 -- bash /mnt/d/EMBEDDED/Competition/TKDT_2026/VEDC_2026/sim/run_boat.sh --pi
```

`--pi` chạy thêm `Rasp_Pi/rescue_main.py` (đúng code sẽ chạy trên Pi thật) và nạp `params/avoidance.parm`:

- ảnh camera Gazebo đi vào model edge của đội: YOLOv8n + MoveNet (`YOLO_Movenet/weights`, `Rasp_Pi/modules/edge_model.py`);
- Pi nối vào **TELEM2 giả lập** của ArduPilot (TCP 5763), như trên phao thật;
- LiDAR Gazebo đi vào Pi, Pi gửi cho ArduPilot (`OBSTACLE_DISTANCE`, 72 ô 5°); BendyRuler bẻ lộ trình
  vòng qua vật cản rồi quay lại tuyến;
- khi phao đang chạy **AUTO** và thấy người đủ 1 giây: Pi chuyển **GUIDED**, đưa phao tới cách người 2 m,
  chuyển **LOITER** giữ vị trí 20 giây, báo `VICTIM SEEN / REACHED` (hiện ở tab Messages của Mission Planner),
  rồi trả lại **AUTO**; người đã tiếp cận thành vùng cấm để lộ trình quét tiếp không chạy qua;
- gạt sang chế độ khác (MANUAL, HOLD, RTL...) lúc nào Pi cũng nhả quyền ngay.

Cách thử: vẽ lộ trình đi ngang gần nạn nhân (cách điểm xuất phát 32 m về đông, 8 m về bắc), Write WPs,
Arm, AUTO. Log của Pi: `~/vedc_sim/sitl_run/pi.log`. `--pi=simulated` dùng bộ phát hiện hình học thay model.

**Xem Pi đang thấy gì.** Với `--pi`, mở `http://127.0.0.1:8090/` trên trình duyệt:

- bên trái là ảnh camera, có khung quanh người mà model phát hiện, độ tin cậy, khoảng cách ước tính, và góc
  servo đang nhìn (đang quét, đang bám, hay nhìn thẳng);
- bên phải là LiDAR nhìn từ trên xuống, mũi phao hướng lên: chấm trắng là điểm LiDAR quét được, vạch đỏ là
  72 ô 5° đúng như Pi gửi cho bộ lái, vòng cam là vùng cấm quanh nạn nhân đã tiếp cận, hình quạt là góc nhìn
  60° của camera (vàng khi quét, xanh khi bám), dấu × là người đang được bám;
- phía dưới là **bản đồ quyết định**, Bắc ở trên, phao là mũi tên trắng: vệt phao đã đi, lộ trình và waypoint
  hiện tại (xanh dương), những gì LiDAR đã thấy được nhớ lại đúng chỗ (chấm trắng, cũ thì xám), các ô Pi đang
  báo là bị chắn (cung đỏ), và người trên bản đồ của Pi: xám là mới thấy, vàng là đã xác nhận đang chờ, xanh lá
  là người đang tới (kèm vòng khoảng cách dừng và điểm đang nhắm), xanh dương là đã xử lý (kèm vòng mà ai nằm
  trong đó sẽ không được tới lần nữa);
- trên bản đồ có hai mũi tên từ phao: **mũi tên xanh mảnh** là hướng thẳng tới waypoint, **mũi tên vàng đậm** là
  hướng bộ lái đang thật sự lái. Hai mũi tên lệch nhau nghĩa là bộ né vật cản đang bẻ đường đi; cột chữ bên
  phải nói ra điều đó bằng lời, ví dụ `autopilot steers 109 deg = 14 deg RIGHT of the waypoint (095), going
  round: 3.7 m on the way there`, cùng với việc Pi đang làm (SEARCH, APPROACH, HOLD…) và vì sao;
- dòng dưới cùng: chế độ bay, pha cứu hộ, waypoint hiện tại, vật cản gần nhất.

Trang xem trực tiếp với bản đồ quyết định

Bản đồ này cho thấy **kết quả** quyết định của bộ né vật cản (BendyRuler chạy bên trong ArduPilot), không phải
các phương án nó đã cân nhắc: Pi chỉ nhận được hướng đang lái, không nhận được lý do. Chữ trên trang là tiếng
Anh vì bộ vẽ chữ của OpenCV không có dấu tiếng Việt.

Trang này do chính `rescue_main.py --viewer [cổng]` phát ra (`Rasp_Pi/modules/viewer.py`), khoảng 5 hình/giây,
chỉ đọc dữ liệu chứ không tác động tới phao. Trên Pi thật dùng được y như vậy qua wifi:
`http://<địa chỉ Pi>:8090/`. Với `--pi=simulated` không có ảnh camera, chỉ có bản đồ LiDAR và hình quạt.

Không dùng `--pi` thì giả lập chạy như cũ với riêng Mission Planner. (Khi đã nạp `avoidance.parm` mà không
có Pi gửi dữ liệu vật cản, ArduPilot từ chối arm.)

Kiểm thử tự động, chạy song song được với phiên đang mở:

```bash
bash sim/tools/rescue_test.sh camera      # model thật trên camera Gazebo
bash sim/tools/rescue_test.sh simulated   # bộ phát hiện hình học
```

### Đi qua đúng đường phần cứng của phao (`--hw`)

Mặc định code Pi lấy LiDAR thẳng từ topic Gazebo và tự quay camera. Trên phao thật thì khác: LiDAR
LD14 vào Pi qua cổng nối tiếp, còn servo camera, relay báo động, nút dừng và LoRa nằm trên bo
STM32F103. `--hw` đặt hai thứ thế chỗ vào giữa, mỗi thứ sau một cổng nối tiếp ảo:

```bash
wsl -d Ubuntu-24.04 -- bash /mnt/d/EMBEDDED/Competition/TKDT_2026/VEDC_2026/sim/run_boat.sh --pi --hw
```

| Trên phao | Thế chỗ trong giả lập | Code Pi được chạy thật |
|---|---|---|
| LD14 | `tools/ld14_emulator.py`: LiDAR Gazebo → gói 47 byte (`0x54 0x2C`, 12 điểm), phát ngay không chờ lệnh | `SerialLidar` → `LD14Decoder` → `ray_obstacles` → `ObstacleFeed` |
| Bo STM32F103 | `tools/helper_board_sim.py` chạy `STM32F103/Tests/helper_sim.c`, tức **chính** `pi_link.c`, `helper_logic.c`, `lora_frame.c` của firmware biên dịch cho máy tính | `HelperBoard`: `$CAM`, `$HBT`, `$VIC`, `$POS`, đọc `$AUX` |

Bo ảo đưa xung servo vào khớp camera của Gazebo (camera chỉ quay nếu lệnh đi trọn qua bo), ghi mọi việc
nó làm vào `~/vedc_sim/sitl_run/helper_events.log`, và coi file `estop` trong thư mục đó là nút dừng đang
nhấn (`touch ~/vedc_sim/sitl_run/estop`). Đặt `VEDC_INGEST_TOKEN` thì dòng LoRa của nó được gửi lên Worker
như trạm bờ ESP32 gửi, hiện thành phao `PHAO-01` trên dashboard.

```bash
bash sim/tools/hw_path_test.sh                           # model thật, 6 điểm kiểm
VEDC_INGEST_TOKEN=... bash sim/tools/dashboard_test.sh   # cả hai đường lên dashboard, cần Worker đang chạy
```

`hw_path_test.sh` đạt khi: cứu hộ trọn vẹn qua LiDAR nối tiếp; khớp camera quét ±60°; bo bật relay và
phát beacon có `v=1` đúng vị trí phao; nhấn nút dừng thì autopilot vào HOLD; LiDAR im thì Pi ngừng cấp
dữ liệu và autopilot từ chối arm (`PRX1: No Data`); rút bo thì Pi chạy tiếp và báo `board off`.

Lần chạy đầu của bài test này đã bắt được một lỗi không thể thấy bằng đường Gazebo trực tiếp: trên mặt nước
trống LiDAR không trả điểm nào, Pi coi đó là LiDAR chết và autopilot không cho arm. Bộ giải mã giờ chuyển
cả những góc "không thấy gì" để một vòng quét rỗng vẫn là một vòng quét.

Trình thế chỗ LD14 phát đúng định dạng gói mà `Rasp_Pi/modules/lidar_ld14.py` giải mã (`encode_scan` của
chính module đó). Muốn chạy lại với LDS-008 cũ: `VEDC_LIDAR_MODEL=lds008`. Cảm biến iBus, INA226, SPI của LoRa không có trong giả lập.

### Thuyền STM32 (Pi + STM32F407) trong giả lập

Đường này không có ArduPilot: `Rasp_Pi/main.py` chạy như trên thuyền STM32, và bo F407 được thay bằng
`tools/f407_board_sim.py` sau một cổng nối tiếp ảo. Bo ảo nhận `$NAV $HBT $CAM $TXD`, trả `$IMU $GPS $SYS $ACK`
(lấy từ odometry của phao Gazebo), và tự đẩy thruster, xoay pod, xoay camera. Bộ PID giữ hướng, phần trộn
motor/bánh lái và chuyển động mượt của camera là **chính** `STM32F4/App/heading_controller.c` và
`camera_pan.c` biên dịch cho máy tính; nhánh AUTO của `control.c` và độ dốc ESC của `actuators.c` được chép
sang Python. Bộ điều khiển RC không giả lập: bo báo đã arm và đang ở AUTO.

```bash
bash sim/tools/stm32_central_test.sh                                   # cảnh miền Trung, khoảng 2.5 phút
MEDIA=$HOME/vedc_sim/stm32_media bash sim/tools/stm32_central_test.sh  # kèm 10 ảnh và video 30 s
```

Bài test dùng bản sao của `vedc_central.sdf` bỏ người đứng ở cửa nhà, thêm hai camera cố định để ghi hình,
và lộ trình `Rasp_Pi/config/mission_sim_central.yaml` chạy thẳng xuống kênh qua người dưới nước (x 14, y −1).
Cấu hình Pi là `sim.yaml` + `boat_stm32.yaml` + `sim_stm32.yaml`. Đạt khi Pi gửi `VICTIM_FOUND` và phao dừng
cách người 1.2–4 m. Lần đo đầu (2026-10-18): thấy người ở 11 s, dừng và giữ cách người 1.74 m.

Bo F407 ở AUTO không phanh được (hai ESC sau một chiều, motor trước không dùng), nên được lệnh dừng ở điểm
cách người 2 m thì phao còn trôi thêm khoảng 1 m: lần chạy như vậy dừng cách người 1.06 m. `sim_stm32.yaml`
vì thế đặt điểm dừng 3 m. Ghi hình: `tools/record_media.py` (`record` lưu khung hình các camera Gazebo và
viewer của Pi, `compose` chọn các mốc từ log của bo ảo rồi dựng ảnh có chú thích và video ghép đôi).

**Camera trong giả lập**: 640 × 480, 15 khung/giây, góc nhìn ngang 60° (dọc 46.8°), cao 0.295 m trên mặt
nước. Bộ phát hiện bị giữ ở 8 khung hình/giây (`camera.max_fps` trong `sim.yaml`), tốc độ đội báo cho Pi 4.
Các số đo trong tài liệu này được lấy khi còn giả định 5 khung hình/giây.

**Servo camera quét khi đang tìm** (`camera.scan` trong `settings.yaml`). Khi phao đã arm, đang ở AUTO và
chưa thấy ai, camera quay qua lại giữa −60° và +60°, phủ 180° phía trước. Thấy người là dừng quét, servo
chuyển sang bám; mất dấu 1.5 s thì quét tiếp từ đúng góc đang nhìn. Ở chế độ khác (lái tay, GUIDED, LOITER,
RTL) camera nhìn thẳng mũi. Có hai kiểu quét (`camera.scan.mode`):

- `sweep` (mặc định): quay mượt với tốc độ `sweep_rate_deg_s` (30°/giây). Lệnh servo gửi theo từng khung
  hình camera, mỗi bước khoảng 2°. Một người nằm trong khung hình 60 / tốc độ giây (2 giây ở 30°/giây); một
  vòng trái–phải–trái mất 240 / tốc độ giây (8 giây), trong lúc đó phao vẫn chạy. Quay chậm hơn thì nhìn
  mỗi hướng lâu hơn nhưng lâu hơn mới quay lại.
- `step`: dừng ở **0° → −60° → 0° → +60°**; ở mỗi hướng chờ 0.25 s cho servo đứng yên (bỏ khung hình chụp
  lúc đang xoay), xét 3 khung hình rồi sang hướng kế. Hướng mũi được nhìn gấp đôi.

Trong giả lập hai kiểu cho kết quả như nhau (bảng dưới). Camera của Gazebo không có nhòe chuyển động, nên
ảnh hưởng của việc quay lên chất lượng ảnh phải thử trên camera thật.

Pi không tự dừng phao để quét. Muốn nhìn kỹ một chỗ, đặt thời gian chờ ở waypoint đó (cột Delay trong
Mission Planner): phao đứng yên, vẫn ở AUTO, camera vẫn quét.

Xác nhận một người: thấy trong ít nhất 3 khung hình, trải trên 1 giây, không có khoảng trống nào dài quá
1 giây (`rescue.confirm_*`). Điểm của model sát ngưỡng nên hay rớt một hai khung hình; trước đây rớt một
khung là đếm lại từ đầu.

Dải tìm kiếm đo trong cảnh hồ, phao chạy 1 m/s trên lộ trình thẳng đi ngang cách nạn nhân một khoảng:

| Lộ trình cách nạn nhân | Camera cố định (`noscan`) | Dừng–nhảy (`scan`) | Quay mượt 30°/s (`sweep`) |
|---|---|---|---|
| 2 m | thấy | thấy | — |
| 3.5 m | thấy | thấy, 2 lần trên 2 | thấy |
| 5 m | thấy | thấy | thấy |
| 6.5 m | **không thấy** | thấy, 2 lần trên 2 | thấy, 2 lần trên 2 |
| 6.5 m, chờ 12 s ở waypoint ngang nạn nhân | **không thấy** | thấy | — |
| 8 m | — | **không thấy** | **không thấy** |

Quay mượt ở 20°/giây và 45°/giây cũng thấy người ở 6.5 m (mỗi tốc độ một lần chạy). Tọa độ báo về lệch
0.2–1.7 m. Mỗi ô là 1–2 lần chạy. Tức với camera cố định các tuyến quét nên cách nhau không quá khoảng
10 m, có quét thì khoảng 13 m. Đo lại:

```bash
bash sim/tools/scan_test.sh camera 6.5 sweep       # lệch 6.5 m, quay mượt
bash sim/tools/scan_test.sh camera 6.5 sweep=20    # quay mượt 20 độ/giây
bash sim/tools/scan_test.sh camera 6.5 scan        # dừng–nhảy
bash sim/tools/scan_test.sh camera 6.5 noscan      # camera cố định
bash sim/tools/scan_test.sh camera 6.5 sweep 12    # dừng 12 s ở waypoint ngang nạn nhân
```

**Quét hẹp lại, ±30° thay vì ±60°** (tổng vùng nhìn 120° thay vì 180°; `SCAN_LIMIT=30` trước lệnh test, hoặc
`rescue_main.py --scan-limit 30`, hoặc `camera.scan.sweep_limit_deg`). Model thật, mỗi ô một lần chạy:

| Hồ, lộ trình cách nạn nhân | ±60° | ±30° |
|---|---|---|
| 5 m | thấy, từ 6.9 m | thấy, từ 6.9 m |
| 5.5 m | — | thấy, từ 7.1 m |
| 6.5 m | thấy, từ 7.2 m | thấy, từ 6.7 m |

| Cảnh miền Trung | ±60° (ba lần chạy) | ±30° (hai lần chạy) |
|---|---|---|
| Người/nhóm được tới, trên 6 | 5, 4, 6 | 5, 4 |
| Người đứng ở cửa nhà (lệch 6.5 m sang bên) được tới | 2 trên 3 lần | 0 trên 2 lần |
| Số lần mất dấu giữa chừng | 0, 4, 0 | 4, 4 |
| Lần chạy không đạt | 1 (dừng chỗ không người) | 1 (dừng hai lần cho nhóm trên mái) |

Trên hồ không thấy khác biệt tới 6.5 m: cả hai kiểu đều bắt được người khi họ còn ở phía trước, cách khoảng
7 m. Ở cảnh miền Trung hai kiểu ngang nhau trong mức dao động giữa các lần chạy; dấu hiệu duy nhất nghiêng về
một phía là người đứng ở cửa nhà, bị sót cả hai lần với ±30°. Số lần chạy quá ít để kết luận, nhưng không có
số nào ủng hộ việc thu hẹp góc quét. Mặc định giữ ±60°.

Khi nạn nhân lệch hẳn sang bên, lúc phao quay mũi để tiến lại camera có khi mất dấu vài giây
(`VICTIM LOST`) rồi bắt lại; phao vẫn tới nơi nhưng chậm hơn.

**Quét trong cảnh có nhiều nhà thì rủi ro hơn.** Camera nhìn ngang vào nhà cửa nên model có nhiều thứ để
nhầm hơn. Trong cảnh lũ, một lần chạy có quét đã cho hai báo nhầm (model chấm 0.64 cho một góc mái nhà, ngang
điểm của người thật 0.61–0.77 nên nâng ngưỡng không lọc được), phao tự tiến tới đó và áp sát nhà. Sau hai
sửa đổi (khoảng cách tới người dưới nước chỉ lấy từ khung hình; dừng tiếp cận khi có vật cách LiDAR dưới
0.9 m), ba lần chạy tiếp theo không có báo nhầm nào, nhưng ba lần là quá ít để nói đã hết.
`flood_test.sh` đếm báo nhầm và coi đó là không đạt. Tắt quét: `rescue_main.py --no-scan`, hoặc
`camera.scan.enabled: false`; so sánh bằng `bash sim/tools/flood_test.sh camera noscan`.

**Tầm phát hiện đo được** (model SSD MobileNet v1, ngưỡng 0.60, người quay mặt về phao, camera đứng yên
trên nước lặng của cảnh lũ, 30 khung hình mỗi cự ly):

| Cự ly | Người ngập tới ngực | Người đứng trên mái |
|---|---|---|
| 2–3 m | 0.74 | — |
| 4 m | 0.62 | 0.62 |
| 5 m | 0.67 | 0.62 |
| 6 m | 0.72 | 0.61 (87 % khung hình đạt ngưỡng) |
| 7 m | 0.70 | — |
| 8 m | 0.66 | 0.64 |
| 10 m | 0.54, không đạt | 0.48, không đạt |
| 12–20 m | — | 0.40–0.52, không đạt |

Không có người trong khung hình: điểm cao nhất 0.17. Tức **tầm tin cậy là 8 m**, nhưng điểm chỉ cách
ngưỡng 0.01–0.14: đây là điều kiện đẹp nhất. Trên mặt hồ có sóng, phao đang chạy, phép đo trước đó chỉ chắc
tới 4 m, chập chờn ở 5–6 m, và phao tiêu màu cam từng bị chấm 0.33–0.56. Vì vậy tốc độ quét để 1.0 m/s và
các tuyến quét phải đủ sát nhau.

## Phao Pi + STM32F407 (`--stm32`)

Phao thứ hai không có Pixhawk: Pi chạy `Rasp_Pi/main.py` (`./run.sh stm32`), tự lập kế hoạch và gửi
`$NAV` / `$HBT` / `$CAM` cho STM32F407, F407 giữ hướng và lái motor. `--stm32` bỏ ArduPilot, đặt một
**F407 ảo** (`tools/stm32_board_sim.py`) sau cổng nối tiếp ảo và cho `main.py` chạy y như trên phao:

```bash
wsl -d Ubuntu-24.04 -- bash /mnt/d/EMBEDDED/Competition/TKDT_2026/VEDC_2026/sim/run_boat.sh --stm32 --start=26,4,90
```

`--start=đông,bắc,hướng` đặt phao cách gốc bao nhiêu mét, mũi quay về hướng nào (độ la bàn) trước khi
chạy. Ở cảnh hồ, `26,4,90` là cách người 7 m, người lệch 34° bên trái mũi. Không có lộ trình (file
`mission.file`, `--mission`, hoặc gửi từ dashboard, xem dưới) thì phao chỉ chạy khi camera thấy người; xuất phát
ở gốc (cách 33 m) thì phao đứng yên, camera quét.

| Trên phao | Thế chỗ trong giả lập |
|---|---|
| STM32F407 | `tools/stm32_board_sim.py`: giao thức `uart_protocol.c` (checksum, NAV TTL, HBT 500 ms, kiểm `seq`), PID `heading_controller.c` và `Heading_Mix` (bánh lái + chênh ga hai motor sau), ga = tốc độ / 1 m/s tối đa 0.5, ramp ESC 2/s, motor trước tắt ở AUTO. Gửi `$IMU`, `$GPS`, `$SYS` 10 Hz từ odometry Gazebo, `$ACK` cho mỗi `$TXD`, `$CAM` → khớp camera |
| BNO055, GPS | tư thế và vị trí phao trong Gazebo; GPS = `HOME_LOCATION` + độ dời |
| LiDAR LD14 | `tools/ld14_emulator.py`, như `--hw` (`VEDC_LIDAR_MODEL=lds008` để dùng LDS-008) |
| Nút xác nhận PE4 | file `confirm` trong `~/vedc_sim/sitl_run`: mỗi lần tạo là một lần nhấn, đếm trong `$SYS` |
| LoRa RA-02 + trạm bờ ESP32 | `tools/shore_station_sim.py` và `tools/lora_radio.py`: UDP thay sóng 433 MHz, có thời gian trên không và cửa sổ nghe 1.5 s; cả hai đầu chạy **chính** `route_link.c` (F407) và `route_downlink.c` (ESP32) qua ctypes |
| Tay khiển FS-i6 | đã bỏ khỏi thuyền: bo arm khi an toàn, AUTO là chế độ duy nhất, thuyền chạy lộ trình gửi từ dashboard |

Log trong `~/vedc_sim/sitl_run`: `pi.log` (main.py), `stm32_sim.log` (mỗi giây một dòng: chế độ, hướng
đích/hiện tại, `u`, ga hai motor, bánh lái, tốc độ, vị trí, góc camera), `stm32_events.log` (đổi chế độ,
`TXD`, gói NAV bị bỏ). `touch ~/vedc_sim/sitl_run/confirm` là nạn nhân nhấn nút xác nhận. Thêm tùy chọn cho `main.py` bằng
`STM32_PI_ARGS="--overlay ..."`, cho bo bằng `STM32_SIM_ARGS="..."` (`--gps-fix`, `--rear-thrust-n`).

Bo ảo theo **đúng** firmware, kể cả những chỗ có thể chưa đúng ý:
- `$SYS` trường `auto` luôn là 1 (không còn công tắc SwB), không phải "Pi đang gửi AUTO": phao đứng chờ thì camera vẫn quét.
- `boat_stm32.yaml` không lấy waypoint của file: phao đứng yên tới khi `shore_station_sim.py` chuyển xuống
  một lộ trình gửi từ dashboard, và đứng lại khi nhận lộ trình rỗng hoặc đi hết lộ trình.
- `$GPS` trường `fix` là chất lượng GGA chuyển nguyên: GPS thường là **1**. `safety.py` chặn lệnh
  `waypoint` khi `fix < 2`, nên trên phao thật đi waypoint sẽ bị dừng `gps_stale_or_no_fix`.
- `$NAV` có `seq` không mới hơn gói trước thì bị bỏ, nhưng chỉ khi luồng NAV còn sống (≤ 300 ms): `main.py`
  khởi động lại đếm từ 1 vẫn được nhận. Gói bị bỏ được ghi "dropped" vào `stm32_events.log`.

Lần chạy đầu (17/10/2026, model `yolov8n_320_int8.tflite` vì `yolov8n_320_drq.tflite` trong
`settings.yaml` chưa có trong repo): camera quét thấy người ở −39°, 5.7 m sau 2.5 s; phao quay mũi từ 94°
về 54° trong khoảng 6 s ở tốc độ bò rồi chạy tới. Nhưng Pi xin 0.10–0.20 m/s mà phao đi **0.6–0.75 m/s**:
ga 0.2 là 3 N mỗi motor sau (lực đẩy tối đa 15 N là số giả định của mô hình). Motor sau chỉ chạy tới, khi
Pi xin 0 thì phao trôi tiếp hơn 2 m và dừng cách tâm người 0.7 m, trong vùng giữ khoảng cách 2 m. Cần đo
tốc độ theo ga trên nước và sửa ánh xạ tốc độ → ga trong `control.c` (hoặc cho phao lùi bằng motor trước).

### Gửi lộ trình từ dashboard xuống phao

Đường thật: dashboard → Worker → trạm bờ ESP32 → LoRa → F407 → Pi ([docs/lora-route-downlink.md](../docs/lora-route-downlink.md)).
Trong giả lập, trạm bờ ảo đọc bản gửi từ Worker chạy cục bộ:

```powershell
cd esp32-lora-station\cloud
npm run dev:idp                    # IdP giả để đăng nhập admin (README của esp32-lora-station)
npx wrangler dev --port 8787       # .dev.vars có INGEST_TOKEN=dev-token
```

```bash
wsl -d Ubuntu-24.04 -- env VEDC_INGEST_TOKEN=dev-token STM32_SIM_ARGS="--gps-fix 2" \
    bash /mnt/d/EMBEDDED/Competition/TKDT_2026/VEDC_2026/sim/run_boat.sh --stm32
```

Mở http://localhost:8787, đăng nhập admin, tab **Lộ trình**: đặt điểm rồi bấm **Gửi tới phao**. Bảng dưới nút
hiện "đang chờ phao nhận" → "phao đang nhận k/n" → "Pi đã nhận lộ trình và đang chạy theo nó". Không cần
Worker thì cho trạm đọc file: `VEDC_ROUTE_FILE=route.yaml` (`waypoints: [[lat, lon], ...]`, `loop`, `id`); mỗi
lần sửa file là một bản gửi mới. `--gps-fix 2` vì `safety.py` chặn lệnh `waypoint` khi GPS báo fix 1 (xem trên).

Log thêm: `station_sim.log` (bản gửi trạm thấy, mỗi khung `RTE` đã phát), trong `stm32_events.log` các dòng
`LoRa RTE taken: rev r, k/n points` và `RTE rev r to the Pi`, trong `pi.log` dòng `route from the dashboard (rev r)`.

Đo ngày 18/10/2026 (main.py có `modules/waypoints.py` của phiên chính, cùng móc ở mục 4 của tài liệu giao thức):
23 điểm tới Pi sau 13 s; lộ trình 3 điểm tới Pi 5 s sau khi trạm thấy bản gửi, thay lộ trình file đang chạy,
và phao đi qua điểm 1 rồi điểm 2 của nó. Dashboard đổi trạng thái theo đúng từng bước.

## Cảnh lũ lụt

```bash
wsl -d Ubuntu-24.04 -- bash /mnt/d/EMBEDDED/Competition/TKDT_2026/VEDC_2026/sim/run_boat.sh --pi --world=flood
```

Một con phố ngập tới mái (`worlds/vedc_flood.sdf`). Phao xuất phát ở đầu phố, mũi hướng đông:

```
 bắc  [nhà]  [nhà tôn]  [nhà]  [nhà tôn]              mép mái cách tim đường 6.2 m
      P>    (cây)    (xe)    A    (cột)     R[nhà cuối phố]
 nam  [nhà tôn]  [nhà]  [nhà tôn]  [nhà]
      0      10      18     27    31      43.5   m về phía đông
```

| Vật | Vị trí (đông, bắc) | |
|---|---|---|
| ngọn cây | 10, -1.0 | chắn tim đường |
| ô tô ngập tới cửa kính | 18, 1.0 | |
| **A** người dưới nước | 27, -0.5 | |
| cột điện nghiêng | 31, 0.8 | |
| **R** người đứng ở mép mái nhà cuối phố | 43.5, 0.5 | |

Cách thử trong Mission Planner: vẽ **một waypoint ở cuối phố, cách điểm xuất phát khoảng 38 m về đông**
(đừng đặt sát nhà cuối phố hơn 4.5 m), thêm lệnh RTL, Write WPs, Arm, AUTO. Phao lượn qua cây, xe;
dừng cách người dưới nước 2 m, giữ 20 giây, đi tiếp; vòng qua cột điện; dừng trước người trên mái; rồi về,
lại vòng qua các vật cản và qua chỗ người dưới nước.

Người trên mái: phao tới sát nhất mà nhà cho phép. Trên những mét cuối, hễ LiDAR thấy vật ở phía trước gần
hơn 1.5 m (bức tường dưới chân người đó) thì phao dừng tại đó và báo `VICTIM REACHED`; điểm dừng 2 m tính
từ người, không tính từ tường, nên khi phao tiến vào theo góc chéo nó có thể nằm sát tường. Nếu trong 10 giây không lại gần thêm được
(`rescue.stall_s`), Pi báo `VICTIM UNREACHABLE <vĩ độ> <kinh độ>` thay cho `VICTIM REACHED`, vẫn giữ vị trí
rồi đi tiếp. Khoảng cách tới người lấy từ LiDAR khi có tia trúng đúng hướng đó (bức tường dưới chân người
trên mái, trong vòng ±3°), không thì từ chiều cao khung hình (`camera.distance_source: fused`). LiDAR chỉ
được dùng cho người đứng khỏi mặt nước: với người dưới nước, tia LiDAR đi qua đầu họ và trúng thứ đứng sau lưng. Khung hình có
đáy nằm trên đường chân trời là người đứng khỏi mặt nước: tính theo chiều cao đứng 1.7 m thay vì 0.7 m của
người ngập tới ngực, nếu không khoảng cách bị đọc ngắn đi 2.5 lần.

**Waypoint rơi trúng vật cản.** Người vẽ lộ trình không thấy cây, xe hay mái nhà trên bản đồ, nên một
waypoint có thể nằm ngay trên chúng. BendyRuler không cho phao vào đó, và phao sẽ loanh quanh mãi trước
vật cản. Pi xử lý bằng ba luật (`rescue.blocked_*` trong `Rasp_Pi/config/settings.yaml`), rồi cho mission
nhảy sang điểm kế và báo `WP n BLOCKED, SKIPPED` (tab Messages):

- LiDAR thấy vật trong vòng 1.5 m quanh chính waypoint, liên tục 3 giây: bỏ qua ngay, từ xa;
- hoặc phao đã ở trong 6 m quanh waypoint, 20 giây không lại gần thêm, và có vật cản trong 4 m;
- hoặc, dù waypoint xa bao nhiêu (giữa một tòa nhà lớn), 120 giây liền phao không lại gần hơn mức gần
  nhất đã đạt. (Từng đặt 45 giây: bộ lái có lúc chần chừ cả phút trước một vật cản rồi mới vòng qua, và luật
  này đã bỏ nhầm một waypoint không bị chắn.)

Phao đã vào trong 2.5 m quanh waypoint thì coi là đã tới (có thể đang chờ theo Delay), không tính là bị chắn.

Nếu điểm bị chắn là **điểm cuối cùng** của mission thì không còn điểm nào để nhảy tới: Pi chuyển phao sang
HOLD (`rescue.blocked_last_mode`) và báo `WP n BLOCKED, HOLD`, thay vì để phao lượn vòng mãi.

Đã thử với waypoint đặt giữa mái một căn nhà 7 × 5 m: phao lượn quanh nhà 55–106 giây rồi bỏ qua điểm đó;
khi đó là điểm cuối, phao dừng sau 75 giây.

Kiểm thử tự động (trên instance 1, chạy song song được với phiên đang mở):

```bash
bash sim/tools/flood_test.sh simulated
bash sim/tools/flood_test.sh camera
```

Đạt khi: không lúc nào tâm phao cách vật cản, nhà hay người dưới 0.8 m; có lượn khỏi tim đường để qua
cây; báo đủ hai người, tọa độ báo về lệch không quá 3 m; không bỏ qua waypoint nào; về tới điểm xuất phát.

Giới hạn đã biết của cảnh này:

- **Vật thấp hơn mặt quét LiDAR (0.37 m) thì phao không thấy**: khúc gỗ trôi, dây, vật chìm. Mọi vật cản
  trong cảnh đều nhô ít nhất 0.5 m.
- **Khe hẹp**: BendyRuler giữ lề 1 m (`OA_MARGIN_MAX`) cộng sai số ô 5°. Khe dưới khoảng 4 m phao không
  chui, nó tìm đường khác hoặc đứng lại.
- **Điểm đích sát vật cản**: BendyRuler dò thêm 2 m phía sau điểm đích; waypoint cách tường dưới ~3.5 m
  thì phao loanh quanh trước nó cho tới khi luật "waypoint bị chắn" ở trên bỏ qua điểm đó.
- **Quay tại chỗ**: `avoidance.parm` bật `WP_PIVOT_ANGLE 60`, cần hai ESC sau đảo chiều được. Trên phao
  thật nếu ESC sau chỉ quay một chiều thì phải thử lại.
- Nước vẫn màu xanh: lớp sóng của asv_wave_sim tự tô màu, chưa đổi được sang màu nước lũ.
- Mọi thứ trừ phao đều đứng yên (không có vật trôi).

## Cảnh miền Trung, tháng 11/2025 (`--world=central`)

```bash
wsl -d Ubuntu-24.04 -- bash /mnt/d/EMBEDDED/Competition/TKDT_2026/VEDC_2026/sim/run_boat.sh --pi --world=central
```

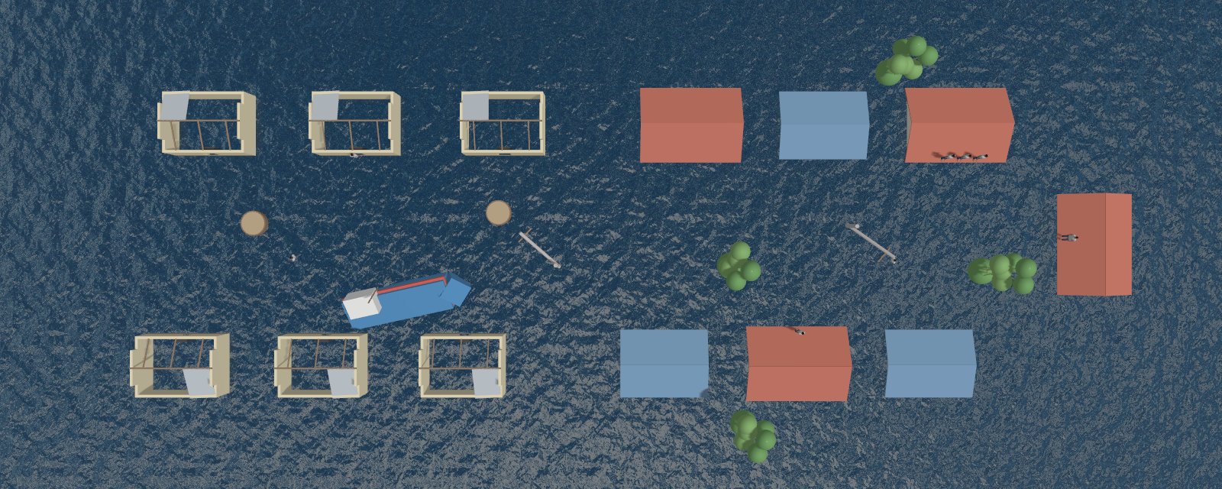
[picture p2: sim/docs/central_overview.jpg]
Cảnh nhìn từ trên xuống: tây bên trái, bắc phía trên


Một luồng nước dài 77 m, rộng 12 m, đi qua **hai cảnh có thật của cùng một vùng, cách nhau hai tuần**. Đây là
cảnh ghép: đợt lũ thứ hai là một đợt mưa khác, không phải do bão gây ra. Khi trình bày đừng gọi cả cảnh là
"sau bão Kalmaegi".

| | Phần một, x 0–36 m | Phần hai, x 40–77 m |
|---|---|---|
| Sự kiện | sau bão số 13 Kalmaegi, đổ bộ Đắk Lắk – Gia Lai tối 6/11/2025 | lũ ngày 19–20/11/2025 ở xã Hòa Thịnh, Đắk Lắk |
| Nơi báo chí mô tả | làng ven đầm ở Tuy Phước Đông, An Lương (Gia Lai) | thôn Phú Hữu |
| Nước | nước dâng ngập nhà hơn 1 m → dựng 1.2 m | nước tới mái nhà trong chưa đầy một giờ → dựng tới mép mái |
| Nhà | tốc mái hàng loạt → 6 nhà chỉ còn tường, đòn nóc, vài cây kèo, một tấm tôn | nhà cấp bốn ngập tới mái → 7 nhà ngói và tôn |
| Vật cản | tàu cá và thuyền thúng bị đắm, dạt bờ; cột điện đổ → 1 tàu cá nghiêng, 2 thuyền thúng, 1 cột điện gãy | thuyền cứu hộ phải lách qua bụi tre, gốc cây, cột điện gãy → 2 bụi tre, 1 cột điện gãy giữa luồng |
| Người | dân dùng thuyền thúng ra cứu hàng xóm; có gia đình ngồi trong nhà tốc mái chờ → 1 người đứng trong nước, 1 người đứng ở cửa nhà | cả làng dỡ ngói leo lên mái kêu cứu → 1 người trên mái, 3 người cùng một mái, 1 người trên mái nhà cuối luồng, 1 người dưới nước |

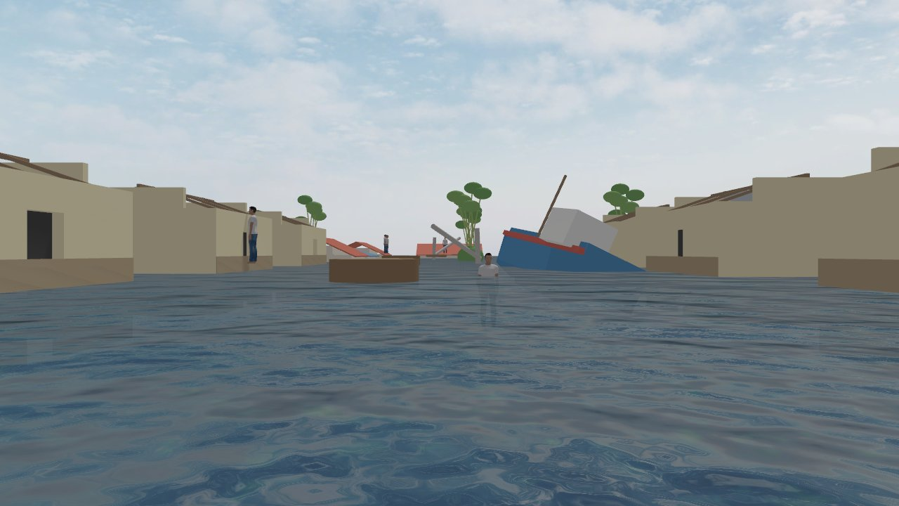
[picture p3: sim/docs/central_part_one.jpg]
Phần một, nhìn từ chỗ phao xuất phát

Phần hai

Tọa độ từng vật ghi ở đầu `worlds/vedc_central.sdf`. Mô hình mới: `storm_house`, `wrecked_boat`,
`basket_boat`, `bamboo_clump`, `broken_pole`.

Những chỗ **không** lấy từ thực tế:

- **Mặt bằng.** Dựng theo mô tả của báo chí, không theo bản đồ hay đo đạc: không con đường thật nào được tái hiện.
  Bề rộng luồng 12 m là số của cảnh phố lũ cũ, chọn vì phao đi được, không phải bề rộng ngõ thôn thật (báo viết
  ngõ ở Lệ Thủy hẹp tới mức chỉ thuyền nhôm nhỏ luồn được).
- **Ban ngày, trời u ám.** Ngoài đời người dân kêu cứu trong đêm; model nhận diện mới chỉ được đo ban ngày.
- **Nước đứng yên**, màu xanh (lớp sóng của asv_wave_sim tự tô màu), không có dòng chảy, không có vật trôi.
- **Vị trí GPS** vẫn là Hồ Đá (điểm xuất phát mặc định), không phải Gia Lai hay Đắk Lắk.
- Mọi vật cản nhô ít nhất 0.47 m khỏi mặt nước để LiDAR (0.37 m) thấy được; ngoài đời nhiều thứ nằm thấp hơn.

```bash
bash sim/tools/central_test.sh simulated      # hoặc camera: model thật
python3 sim/tools/world_snapshot.py /vedc_central/overview anh.png    # chụp lại ảnh nhìn từ trên xuống
```

Kết quả với motor sau đảo chiều (mặc định của giả lập), lộ trình một waypoint ở x 66.5 m rồi RTL, model thật,
hai lần chạy:

| | Lần 1 | Lần 2 |
|---|---|---|
| Người/nhóm được tới (trên 6) | 5 | 4 |
| Dừng lặp cho cùng người | không | không |
| Số lần mất dấu người giữa chừng | 0 | 4 |
| Về tới điểm xuất phát sau | 506 s | 484 s |
| Sát vật cản nhất | (cách đo lần này chưa đúng) | xác tàu 1.06 m |

Người hay bị sót là người đứng ở cửa nhà và người dưới nước của phần hai. Với ESC sau một chiều (`--oneway`) cảnh
này **chưa được chạy**; theo kết quả ở cảnh phố lũ thì nhiều khả năng phao sẽ va vật cản.

Nguồn: [Bão Kalmaegi giật sập nhiều nhà, nguy cơ ngập diện rộng (VnExpress)](https://vnexpress.net/bao-kalmaegi-do-bo-dak-lak-gia-lai-4960961-tong-thuat.html),
[Bão số 13 Kalmaegi gây thiệt hại nặng nề tại Đắk Lắk và Gia Lai, người dân cầu cứu (Soha)](https://soha.vn/bao-so-13-kalmaegi-quan-thao-dak-lak-gia-lai-nha-sap-ngap-khap-noi-nhieu-nguoi-cau-cuu-198251107064939468.htm),
[Bão Kalmaegi gây thiệt hại nặng nề tại nhiều nơi (Tuổi Trẻ)](https://tuoitre.vn/bao-kalmaegi-gay-thiet-hai-nang-ne-tai-nhieu-noi-20251106232940411.htm),
[36 giờ sinh tử ở rốn lũ Hòa Thịnh (Báo Xây Dựng)](https://baomoi.com/36-gio-sinh-tu-o-ron-lu-hoa-thinh-ca-lang-leo-mai-nha-keu-cuu-trong-dem-c53829410.epi),
[Tang thương ở rốn lũ Hòa Thịnh (Tiền Phong)](https://tienphong.vn/tang-thuong-o-ron-lu-hoa-thinh-canh-bao-xa-lu-co-kip-thoi-post1799204.tpo),
[Lao vào biển nước cứu người ở tâm lũ Đắk Lắk (Eva/Dân Việt)](https://eva.vn/tin-tuc/vuot-nuoc-xoay-cuu-nguoi-giua-tam-lu-dak-lak-c73a654527.html).

## Nhiều người trong khung hình

Camera giữ lại **mọi** người model phát hiện trong một khung hình, và Pi ghi từng người lên bản đồ
(`Rasp_Pi/modules/rescue.py`):

- một phát hiện là người đã biết khi nó nằm đúng hướng của họ (lệch ngang không quá 1 m, hoặc 6°) và ở
  khoảng cách xấp xỉ (trong 3 m: khoảng cách đọc từ chiều cao khung kém chắc hơn hướng nhiều); không thì là
  người mới. `rescue.revisit_radius_m`, `rescue.same_person_range_m`;
- mỗi người được xác nhận riêng (3 khung hình, 1 giây) và có trạng thái riêng;
- phao tới người chưa xử lý gần nhất, xong thì tới người kế, không cần thấy lại từ đầu;
- trong lúc tiếp cận, chỉ phát hiện rơi đúng vào người đang nhắm mới làm vị trí của họ thay đổi, và camera
  bám người đó (kể cả quay về phía họ khi họ chưa ở trong khung hình);
- người đã xử lý, người chưa tới lượt và người vừa bị mất dấu đều là vùng cấm với bộ né vật cản;
- khi có từ hai người, Pi báo `PEOPLE 2 FOUND 1 ATTENDED`.

```bash
bash sim/tools/two_person_test.sh side      # hai người đứng ngang nhau, cách nhau 3 m
bash sim/tools/two_person_test.sh behind    # một người gần, một người xa hơn 4.5 m và lệch 1.5 m
```

Đạt khi cả hai người được xử lý, mọi tọa độ báo về lệch dưới 3 m, và phao không tới gần ai dưới 0.8 m.

| | Trước (chỉ giữ một người mỗi khung hình, bán kính "người cũ" 8 m) | Sau |
|---|---|---|
| Xử lý đủ 2 người | 0 trên 6 lần chạy | 4 trên 4 |
| Tọa độ báo về lệch | 0.3–0.6 m | 0.1–0.7 m |

Còn vụng ở cảnh `side`: cả hai lần phao mất dấu người thứ hai hai lần rồi mới tới nơi (5 lần chuyển quyền lái
thay vì 2), và có lần báo cùng một người hai lần. Người thứ hai đứng cách người vừa xử lý 3 m, mà người vừa
xử lý lại là vùng cấm. Chưa thử: ba người trở lên, hai người sát nhau dưới 1 m, một người dưới nước cạnh một
người trên mái.

### Không dừng hai lần cho cùng một người, một nhóm là một lần dừng

Trước đây phao hay quay lại người vừa xử lý. Hai nguyên nhân, đều ở `rescue.py`: vị trí của người đã xử lý
bị ghi đè bởi mỗi lần thấy lại từ xa (khoảng cách đọc từ chiều cao khung lệch vài mét), và mỗi người
trong một nhóm là một lần tiếp cận riêng. Giờ:

- vị trí người đã xử lý được chốt lúc phao đứng cạnh họ và không dời nữa;
- một phát hiện mà tia nhìn đi qua trong `rescue.group_radius_m` (2.5 m) của người đã xử lý, khoảng cách
  đọc được lệch không quá `group_radius_m + range_sigma × khoảng cách`, là người đó (hoặc nhóm của họ);
- tới một người thì mọi người trên bản đồ trong 2.5 m quanh họ được tính là đã xử lý; người mà lại gần
  mới lộ ra là đứng cạnh người đã xử lý thì phao bỏ lần tiếp cận, báo `SAME GROUP, RESUMING AUTO`.

Cảnh làng (`--world=village`: 8 người trong 4 cụm), model thật, lộ trình dọc phố rồi về, mỗi dòng **một**
lần chạy:

| | Lấy quyền lái | Lần dừng | Dừng lặp cho cùng cụm | Pi đếm được | Về sau |
|---|---|---|---|---|---|
| Trước | 18 | 11 | 3 cụm | 13 "người" | 564 s |
| Sau | 2 | 2 | không | 5 | 233 s |
| Sau, `group_radius_m: 2.0` | 7 | 4 | 1 cụm (hai điểm dừng cách 2.3 m) | 8 | 280 s |

```bash
bash sim/tools/village_test.sh camera     # đạt khi không cụm nào bị dừng hai lần
bash sim/tools/revisit_test.sh camera     # hồ: đi ngang người rồi quay lại đi ngang lần nữa, chỉ được 1 lần dừng
```

Đánh đổi, cần biết khi đọc số liệu:

- **Đếm thiếu.** Người chỉ lộ ra sau khi cụm của họ đã xử lý thì được coi là người cũ, không đếm thêm:
  cảnh làng có 8 người, Pi đếm 5. Trước đây thì đếm thừa (13).
- **Hai người cách nhau 3 m có thể thành một lần dừng.** Vị trí đọc từ xa lệch cỡ nửa mét, nên 3 m dễ ra
  dưới 2.5 m. `two_person_test.sh side` chấp nhận cả hai kết quả, miễn Pi tính đủ hai người đã xử lý. Đặt
  `group_radius_m: 2.0` thì họ lại là hai lần dừng, nhưng cụm ba người dưới nước của cảnh làng (cách nhau
  tới 2.4 m) bị tách làm hai.
- **Người mới đứng đúng sau lưng người cũ** trên cùng tia nhìn bị bỏ qua cho tới khi được nhìn từ góc khác.
- Mỗi lượt cảnh làng model chỉ bắt được 2–3 trong 4 cụm (người bơi đơn lẻ ở tim đường hay bị sót): đó là
  tầm của model, không liên quan thay đổi này.

### Mũi phao và người: đã thử hai cách, cả hai đang tắt

Mong muốn: camera thấy người ở 50° thì thân phao quay theo cho mũi hướng vào người, servo về 0°. Số đo là
góc giữa mũi phao và hướng tới người **trong lúc giữ vị trí** (`rescue_test.sh` và `village_test.sh` in ra
dòng `bow off the person while holding`), model thật, mỗi dòng một lần chạy:

| Cảnh | Cách | Mũi lệch người, trung bình | Kết quả |
|---|---|---|---|
| Hồ | mặc định: tới thẳng điểm cách người 2 m, autopilot giữ (LOITER) | 12° và 31° (hai lần chạy) | đạt |
| Hồ | quay mũi trước rồi mới tiến (`rescue.turn_first`) | 32° | đạt |
| Hồ | Pi tự giữ và lái mũi về người (`rescue.hold_mode: FACE`) | 51° | đạt |
| Hồ, ESC sau một chiều | `hold_mode: FACE` | 67° | **không đạt**: trôi xa người 5.5 m |
| Làng | LOITER | 55° | đạt |
| Làng | `hold_mode: FACE` | 69° | đạt, một lần mất dấu người |

Mặc định tự nó đã dao động từ 12° tới 31° giữa hai lần chạy, nên bảng này không phân biệt được "quay mũi
trước" với mặc định; nó chỉ cho thấy không cách nào **hơn** mặc định, và `FACE` với ESC một chiều thì hỏng hẳn.
Vì vậy cả hai để tắt (`turn_first: false`, `hold_mode: LOITER`); code và test của chúng vẫn còn để thử lại. Lý do là vật lý chứ không phải tham số: phao chỉ quay mũi được khi đang tiến, mà
đứng cạnh người thì không còn chỗ để tiến. Khoảng giữa "đã tới" (2.5 m) và "không được gần hơn" (2 m) là nửa
mét, phao dùng hết trước khi quay xong rồi phải đứng yên với mũi còn lệch.

Trên mặt nước trống, mặc định cho mũi lệch người 12–31°. Chỗ lệch nhiều là cảnh có vật cản (55°): phao
phải đi vòng nên tới nơi theo hướng xiên. Muốn sửa tận gốc thì cần phao **xoay tại chỗ** được, tức hai ESC
sau đảo chiều; khi đó giữ vị trí bằng lệnh hướng với tốc độ 0 mới có nghĩa. Chưa làm.

Bản STM32 (`main.py`) thì khác: firmware lái theo hướng Pi gửi, nên ở đó Pi đã được đổi để quay mũi về
người trước và giữ mũi ở khoảng cách dừng (`vehicle.face_*`); phần này mới có unit test, chưa chạy trên bo.

**Cắt ảnh theo dải chân trời** (đưa vào model hai ô cắt quanh đường chân trời thay cho cả khung hình, để mỗi
người chiếm nhiều điểm ảnh hơn) đã được đo và **không được đưa vào code**. Điểm tin cậy của model, camera đứng
yên, ngưỡng 0.60:

| Cự ly | Người bơi: cả khung / hai ô | Người trên mái: cả khung / hai ô |
|---|---|---|
| 6 m | 0.72 / 0.71 | 0.61 / 0.43 |
| 8 m | 0.66 / 0.48 | 0.64 / 0.51 |
| 10 m | 0.54 / 0.62 | 0.48 / 0.64 |
| 12 m | 0.59 / 0.57 | 0.52 / 0.54 |
| 14–16 m | 0.51–0.55 / 0.48–0.56 | 0.40–0.45 / 0.63 |

Hai ô giúp ở 10 m và với người trên mái ở 14–16 m, nhưng làm hỏng ở 8 m và với người trên mái ở gần (dải cắt
mất một phần người). Điểm của model không tăng đều theo kích thước người trong ảnh mà dao động quanh ngưỡng,
nên phóng to ảnh không phải lối ra; muốn nhìn xa hơn một cách chắc chắn thì phải huấn luyện lại model trên ảnh
thật.

## So sánh thuật toán né vật cản

Bài báo trong `papers/` (Jo, Kim, Kim, Park, *J. Mar. Sci. Eng.* 2022, 10, 2036) so sánh hai cách tránh va
chạm cho tàu mặt nước: trường thế thiên lệch (B-APF) và chướng ngại vận tốc (VO), cùng cổng rủi ro
TCPA/DCPA. Bài báo xét các tàu trong một đội hình, biết chính xác vị trí và vận tốc của nhau, và chỉ mô
phỏng. Ở đây hai cách đó được thử cho việc khác: một phao né vật cản đứng yên mà LiDAR thấy.

`Rasp_Pi/pi_steer.py` là chương trình thí nghiệm: bộ lái ở GUIDED, Pi tính hướng và tốc độ 5 lần mỗi giây
(`Rasp_Pi/modules/navigation.py`) rồi ra lệnh. Không có phát hiện người. Phao bình thường **không** chạy
kiểu này; nó dùng BendyRuler của bộ lái.

```bash
bash sim/tools/avoid_compare.sh bendyruler street   # cách hiện tại
bash sim/tools/avoid_compare.sh paper street        # B-APF của bài báo
bash sim/tools/avoid_compare.sh vo gap              # VO của bài báo, lộ trình khe hẹp
bash sim/tools/avoid_compare.sh bapf street         # trường thế của nhánh STM32 (main.py)
```

Hai lộ trình trong cảnh lũ: **dọc phố** (tới 38.5 m rồi quay về, qua cây, xe, cột điện, khoảng 75 m) và
**khe hẹp** (ba waypoint buộc phao đi giữa chiếc xe và dãy nhà bắc, khe rộng 4.3 m). Ba lần chạy mỗi ô, ghi
khoảng nhỏ nhất – lớn nhất. "Dưới 1 L" là tổng thời gian tâm phao cách vật cản dưới một chiều dài phao
(1.1 m), thước đo an toàn của bài báo.

| Lộ trình | Cách | Xong | Thời gian | Gần vật cản nhất | Dưới 1 L | Tổng góc quay mũi |
|---|---|---|---|---|---|---|
| Dọc phố | BendyRuler | 3/3 | 115–133 s | 0.63–1.09 m | 0.5–8.1 s | 1128–1532° |
| Dọc phố | B-APF bài báo | 3/3 | 144–176 s | 0.08–0.40 m | 34–56 s | 5092–6825° |
| Dọc phố | VO bài báo | 2/3 | 97–127 s | 0.48–0.95 m | 0.5–17 s | 1595–3543° |
| Dọc phố | Trường thế STM32 | 0/1 | kẹt sau 8 m | | | |
| Khe hẹp | BendyRuler | 3/3, nhưng bỏ 2 trong 3 waypoint | 56–83 s | 0.40–0.70 m | 2.3–3.3 s | 689–1503° |
| Khe hẹp | B-APF bài báo | 3/3 | 37–39 s | 1.15–1.22 m | 0 s | 608–694° |
| Khe hẹp | VO bài báo | 1/3 | 71 s | 1.24 m | 0 s | 2193° |
| Khe hẹp | Trường thế STM32 | 0/1 | kẹt | | | |

Với VO, các số là của những lần chạy xong; ba lần không xong (hết 240 s) đều lượn vòng, tổng góc quay
16 500–18 200°, và có lúc "cách vật cản" 0.02–0.08 m. Vùng tính khoảng cách tới hai dãy nhà gồm cả các hẻm
giữa nhà, nên số sát 0 có thể là phao chui vào hẻm chứ chưa chắc chạm tường; bài test không phân biệt được.

Đọc bảng này thế nào:

- **Không cách nào hơn hẳn.** BendyRuler là cách duy nhất đi hết lộ trình dọc phố cả ba lần mà không lần nào
  sát vật cản dưới 0.6 m. B-APF đi khe hẹp gọn và đều nhất, nhưng trên phố nó ở sát vật cản gần một phút và
  lắc gấp bốn. VO có lần chạy nhanh nhất trên phố, nhưng ba trong sáu lần không tới đích.
- **Giữ BendyRuler làm mặc định.** Điểm yếu của nó lộ ra ở khe hẹp: nó bỏ waypoint đặt gần vật cản thay vì
  luồn tới.
- **Trường thế của nhánh STM32 (`BapfNavigator`) kẹt vĩnh viễn** ở cả hai lộ trình: quy tắc "vật cản gần
  hơn `stop_distance_m` thì dừng" không có lối ra, đã dừng thì không rời được vật cản.
  Sau lượt đo này quy tắc đó đã được sửa: chỉ dừng khi hướng đi được lệnh dẫn vào vật cản, còn lại thì bò ra.
  Phao hết đứng im (đi 78–104 m trong 240 s) nhưng vẫn lượn vòng không tới đích, 4 trên 4 lần chạy.
- So sánh không hoàn toàn công bằng: BendyRuler chạy trong bộ lái, ba cách kia chạy trên Pi ở 5 Hz qua
  MAVLink. Hệ số của bài báo (cho tàu 4.88 m, ô 25 m) phải thu nhỏ cho phao 1.1 m trong phố rộng 12 m, qua
  hai vòng chỉnh; hệ số và lý do từng lần đổi ghi ở đầu `pi_steer.py`. VO với vật cản đứng yên cũng mất lợi
  thế chính của nó là dùng vận tốc của vật cản.
- Ba lần chạy mỗi ô là ít, và kết quả dao động mạnh giữa các lần (VO trên phố: 97 s lần này, không tới đích
  lần sau).

## ESC sau một chiều

Hai ESC sau của phao thật chỉ quay một chiều; giả lập mặc định cho chúng đảo chiều.
`params/oneway_esc.parm` chặn chiều lùi của hai motor sau (motor trước vẫn hai chiều):

```bash
bash sim/run_boat.sh --pi --oneway                                         # phiên tương tác
EXTRA_PARM=$PWD/sim/params/oneway_esc.parm bash sim/tools/flood_test.sh    # bài test nào cũng nhận EXTRA_PARM
```

Mỗi dòng là **một** lần chạy với bộ phát hiện hình học (`simulated`). "Sát nhất" là khoảng cách nhỏ nhất
từ tâm phao tới vật cản; bài test đòi 0.8 m (thân phao vươn 0.55 m từ tâm).

| Cảnh | Motor sau | Tham số thêm | Kết quả | Sát nhất |
|---|---|---|---|---|
| Phố lũ | đảo chiều | — (mặc định) | **đạt**, về sau 190 s | 1.33 m |
| Phố lũ | một chiều | — | không đạt | xe 0.37 m, nhà cuối phố 0.03 m; lượt về lệch tim đường 25 m, bỏ 1 waypoint |
| Phố lũ | một chiều | `WP_PIVOT_ANGLE 0` | không đạt | chạm dãy nhà nam, xe 0.11 m, người dưới nước 0.62 m |
| Phố lũ | một chiều | `WP_SPEED 0.6` | không đạt | xe 0.29 m, cột điện 0.54 m |
| Phố lũ | một chiều | `WP_SPEED 0.6`, `OA_MARGIN_MAX 1.5`, `OA_BR_LOOKAHEAD 7` | không đạt | nhà cuối phố 0.05 m, người trên mái 0.38 m |
| Hồ trống | một chiều | — | **đạt** | giữ cách người 1.64–2.57 m |
| Hồ trống | một chiều | `WP_SPEED 0.6` | **đạt** | giữ cách người 1.95–2.49 m |

Đọc bảng này thế nào:

- **Trên mặt nước trống, ESC một chiều không cản trở kịch bản cứu hộ.** Tìm, tiếp cận, giữ vị trí, trả
  lại lộ trình đều như bản đảo chiều.
- **Trong phố hẹp có vật cản thì không an toàn.** Không lùi được, phao không dừng kịp và không lách ra
  khỏi vật cản đã áp sát: lần nào cũng có một chỗ nó vào trong 0.5 m, tức thân phao chạm hoặc gần chạm.
  Giảm tốc xuống 0.6 m/s đỡ hơn (không còn bỏ waypoint, không đi lạc) nhưng chưa đủ; nới lề né vật cản
  đổi chỗ va chứ không hết va.
- Mỗi cấu hình chỉ một lần chạy và kết quả giữa các lần dao động mạnh: bảng đủ để nói "không đạt", không
  đủ để xếp hạng các biến thể một chiều với nhau.
- Chưa thử: cho motor trước (hai chiều) phanh chủ động khi tới gần vật cản; lộ trình chỉ rẽ một phía.

Hệ quả cho phao thật (`pixhawk/params/boat.parm`): chạy 0.6 m/s, chỉ ở vùng nước trống, cho tới khi hai
ESC sau lùi được. ESC BLHeli_S thường đặt được chế độ hai chiều bằng phần mềm cấu hình của nó; nếu làm
được trên ESC của đội thì dùng nguyên `params/avoidance.parm`, bản đã đạt cảnh phố lũ.

## Xem trên dashboard web

`run_boat.sh` cho MAVProxy phát thêm ra cổng **14551**. Cầu nối
`esp32-lora-station/tools/mavlink_bridge.py` đọc cổng đó và đẩy lên Worker như một phao `SIM-01`, có HUD
kiểu Mission Planner. Chạy Worker cục bộ (`npx wrangler dev` trong `esp32-lora-station/cloud`), rồi trong WSL:

```bash
export VEDC_INGEST_TOKEN=...   # INGEST_TOKEN trong esp32-lora-station/cloud/.dev.vars
python3 /mnt/d/EMBEDDED/Competition/TKDT_2026/VEDC_2026/esp32-lora-station/tools/mavlink_bridge.py --url http://127.0.0.1:8787/api/ingest
```

Mở `http://127.0.0.1:8787`, vào bằng chế độ khách, chọn `SIM-01`. Xem `esp32-lora-station/README.md`.

Kiểm thử tự động (không cần Mission Planner): chạy `--headless`, rồi trong WSL
`python3 sim/tools/smoke_test.py` — arm, GUIDED 20 m về phía đông, báo PASS/FAIL.

## Thư mục

| File | Nội dung |
|---|---|
| `env.sh` | Biến môi trường: ROS/Gazebo, GPU qua d3d12, đường dẫn mô hình và plugin |
| `models/vedc_buoy/` | Catamaran 1.10 × 0.60 m, hình dáng lấy từ file CAD của đội (`meshes/*.stl`): 2 motor sau trên pod lái, 1 motor trước ở giữa đảo chiều được, pod trước quay ngược pod sau. Camera 60° trên hộp mũi (`/vedc_buoy/camera`), LiDAR 360° trên cột ngắn trên nóc (`/vedc_buoy/lidar`) |
| `Thuyen.ETL.STL` | file CAD gốc của đội (mm) |
| `tools/cad_to_mesh.py` | đổi file CAD sang các mesh của mô hình (thân, 3 pod, camera): mét, x hướng mũi, y sang trái, z lên |
| `worlds/vedc_lake.sdf` | Mặt nước sóng FFT, ba phao tiêu làm vật cản, một nạn nhân cách điểm xuất phát 33 m về phía đông bắc, bước vật lý 2 ms |
| `models/victim/` | Người nổi mặc áo phao cam, một tay giơ lên; tĩnh, gốc tọa độ ở mặt nước. LiDAR của phao (mặt quét cao khoảng 0.37 m) chỉ bắt được cánh tay, nên khoảng cách tới người phải lấy từ camera |
| `models/vedc_waves/` | Sóng của asv_wave_sim trên lưới 128 ô (gốc 256) để chạy kịp thời gian thực; texture lấy từ `model://waves` |
| `params/vedc_buoy.parm` | `FRAME_CLASS 2` (tàu), gán kênh motor/pod, tốc độ, bộ lái đã chỉnh, pin, giữ vị trí, failsafe mất GCS → RTL |
| `params/avoidance.parm` | né vật cản BendyRuler bằng dữ liệu từ Pi, quay tại chỗ; chỉ nạp với `--pi` |
| `worlds/vedc_flood.sdf` | cảnh lũ: phố ngập, hai dãy nhà, cây, xe, cột điện, một người dưới nước, một người trên mái |
| `models/flooded_house/`, `flooded_house_tin/` | nhà ngập tới mái (ngói đỏ 7 × 5 m, tôn xanh 6 × 4.5 m), ghép từ khối hộp, tĩnh |
| `models/victim_standing/` | người đứng (cùng mesh Fuel), gốc tọa độ ở bàn chân, để đặt lên mái |
| `models/vedc_flood_waves/` | mặt nước của cảnh lũ: gió 1.5 m/s (sóng lăn tăn) |
| `tools/flood_test.sh` | kiểm thử trọn cảnh lũ với code Pi, trên instance 1 |
| `tools/scan_test.sh` | đo dải tìm kiếm của camera: lộ trình đi lệch bên cạnh nạn nhân, có quét hoặc camera cố định |
| `tools/two_person_test.sh` | hai người trong cùng khung hình: phải xử lý đủ cả hai |
| `tools/avoid_compare.sh` | so sánh BendyRuler với các thuật toán né vật cản chạy trên Pi (thí nghiệm) |
| `models/victim_person/` | người giống thật (mesh "Standing person" của Gazebo Fuel, CC0, tự tải lần đầu), ngập nước tới ngực |
| `tools/rescue_test.sh` | kiểm thử trọn kịch bản cứu hộ với code Pi, trên instance 1 |
| `tools/stm32_board_sim.py` | STM32F407 ảo cho `main.py` (`--stm32`): giao thức, PID giữ hướng, trộn bánh lái và motor của firmware F4, beacon LoRa |
| `tools/shore_station_sim.py` | trạm bờ ESP32 ảo: nghe beacon, đẩy lên Worker, trả lời bằng khung lộ trình `RTE` |
| `tools/lora_radio.py`, `tools/route_radio_shim.c` | đường LoRa ảo (UDP, thời gian trên không) và lớp ctypes để hai trạm ảo chạy `route_link.c` / `route_downlink.c` của firmware |
| `tools/smoke_test.py` | Kiểm thử nhanh qua pymavlink: arm, GUIDED 20 m |
| `tools/integration_test.sh` | Kiểm thử đầy đủ trên instance 1 (cổng 9012/5770/14561), chạy song song được với phiên đang mở: tham số, nhiễu IMU, arm, GUIDED, chiều kênh khi rẽ |

### Ánh xạ kênh ArduPilot → phao

| SERVO | Chức năng | Trên phao | Firmware STM32 tương ứng |
|---|---|---|---|
| 1 | ThrottleLeft (73) | motor sau trái | `ESC_LEFT`, DShot PA5 |
| 2 | GroundSteering (26) | hai pod sau | `SERVO_LEFT` / `SERVO_RIGHT` |
| 3 | ThrottleRight (74) | motor sau phải | `ESC_RIGHT`, DShot PA3 |
| 4 | Throttle (70) | motor trước, 1500 µs = dừng | `ESC_FRONT`, PWM PA1 |
| 5 | GroundSteering, đảo chiều | pod trước | `SERVO_FRONT`, `RUDDER_DIR_FRONT = -1` |

Rẽ phải: motor trái mạnh hơn phải, pod sau > 1500 µs, pod trước < 1500 µs.

### Mô hình CAD của phao

Hình dáng phao trong Gazebo là file CAD của đội. Khi có bản CAD mới, xuất lại STL rồi chạy:

```bash
python3 sim/tools/cad_to_mesh.py sim/Thuyen.ETL.STL sim/models/vedc_buoy/meshes
```

File CAD để nguyên như phần mềm xuất ra: đơn vị mm, chiều dài theo trục Z (mũi ở Z nhỏ), bề ngang theo X,
chiều cao theo Y. Script xoay về hệ trục Gazebo, đổi sang mét, đặt đáy hai thân thấp hơn gốc tọa độ 5 cm,
rồi cắt khối CAD liền thành các phần chuyển động được:

| Mesh | Gắn vào | |
|---|---|---|
| `hull.stl` | thân | màu cam |
| `pod_rear_left.stl`, `pod_rear_right.stl` | hai pod sau | xoay theo servo lái |
| `pod_front.stl` | pod trước | xoay ngược pod sau |
| `camera.stl` | camera | xoay theo servo camera |

Những chỗ giả lập **khác file CAD**:

- **Motor trước hạ thấp 9 cm.** Trong CAD, tâm chân vịt trước (rộng 12 cm) chỉ thấp hơn mặt nước khoảng
  2 cm ở tải 15 kg, nửa trên nằm trên mặt nước. Giả lập đặt tâm thấp hơn gốc tọa độ 11 cm, ngang hai
  chân vịt sau, và vẽ thêm một thanh nối lên trần hầm giữa hai thân.
- **Thêm LiDAR.** CAD chưa có. Giả lập đặt nó trên cột ngắn trên nóc, phía mũi, mặt quét cao 0.37 m: vừa
  đủ vượt camera (0.305 m) và đầu anten (0.355 m). Thấp hơn thì nó quét trúng hai thứ này và coi là vật cản
  dính sát phao.

Các mesh chỉ quyết định **hình dáng nhìn thấy**. Còn lại vẫn khai trong `model.sdf`:

- **lực nổi và lực cản**: hai khối hộp 1.10 × 0.14 × 0.20 m đặt đúng chỗ hai thân. Lực nổi tính trên
  từng tam giác mỗi bước 2 ms, nên mesh hơn 9 000 tam giác của thân sẽ làm giả lập chậm hẳn;
- **khối lượng 15 kg** và quán tính;
- **vị trí motor và camera**, đo trên CAD: chân vịt sau ở (-0.40, ±0.234, -0.115) m, chân vịt trước ở
  (0.19, 0, -0.11) m sau khi hạ, camera ở (0.41, 0, 0.295) m. Vị trí các link trong `model.sdf` phải khớp
  với các hằng số ở đầu `cad_to_mesh.py`.

Chân vịt không quay trên hình (lực đẩy vẫn đúng). STL không mang màu: màu đặt trong `model.sdf`.

### Thông số module trong giả lập

| Module thật | Trong giả lập | Nguồn |
|---|---|---|
| Thân 110 × 60 cm, **15 kg** | khối lượng và quán tính của `base_link` | đội cung cấp |
| Pin 12 V, 5600 mAh | `BATT_CAPACITY`, `SIM_BATT_*`, failsafe pin yếu → RTL (giả định pin lithium 3S, đầy 12.6 V) | đội cung cấp |
| Servo pod **DS51150-12V** | tốc độ khớp pod 5 rad/s (0.21 s/60° ở 12 V) | thông số nhà sản xuất |
| Servo camera **SG90** | khớp `camera_pan_joint`, ±90°, 10 rad/s; lệnh góc (rad, dương là quay phải) trên `/model/vedc_buoy/joint/camera_pan_joint/cmd_pos` | thông số phổ biến của SG90 |
| Camera **OV9726**, ống kính **60°** | 640 × 480, góc nhìn ngang 60° (dọc 46.8° ở tỉ lệ 4:3); `settings.yaml` của Pi cũng đặt 60°. Phát 15 khung/giây: số tự chọn cho giả lập, chưa đối chiếu với camera thật | mã camera và góc: đội cung cấp |
| LiDAR **LDROBOT LD14** | 384 điểm/vòng (2300 mẫu/giây ở 6 vòng/giây), tầm 0.15–8 m, UART 115200 | [bảng thông số Waveshare](https://waveshare.com/wiki/Triangulation_LiDAR_LD14) |
| GPS Holybro M10 | GPS mặc định của ArduPilot SITL | — |

### Những số còn giả định

- **LiDAR LD14**: độ cao gắn và nhiễu trong mô hình là tự chọn. Bản LD14P khác: 4000 mẫu/giây và
  230400 baud. Khả năng làm việc ngoài nắng chưa thử.
- **DS51150** có bản 180° và 270°; mô hình đang để pod ±45° trên 1000–2000 µs.
- Thân 0.14 × 0.20 m; lực đẩy ±15 N mỗi motor sau và ±10 N motor trước (motor, chân vịt chưa có thông số).
- Tốc độ chạy model trên Pi 4 (giả lập chưa giới hạn theo tốc độ Pi).

Hai chỗ khác phao thật: motor sau thật (BLHeli_S DShot) chỉ quay một chiều, ở đây đảo chiều được;
quán tính chân vịt để 0.1 kg·m² (lớn hơn thật nhiều) như mô hình BlueBoat, vì link quay nhẹ làm
bộ giải vật lý rung tới ±50 g và ArduPilot từ chối arm ("Accels inconsistent").

## Lưu ý

- **Tốc độ giả lập:** góc dưới phải cửa sổ Gazebo là real-time factor (RTF). ArduPilot chạy khóa nhịp
  với Gazebo nên RTF thấp thì phao phản ứng chậm theo. Đo trên laptop dev (headless): 0.45 với bước
  1 ms + lưới sóng 256 + barrage; khoảng 1.0 với cấu hình hiện tại. Chi phí chính là lực nổi tính trên
  từng tam giác thân tàu mỗi bước — mỗi vật nổi thêm vào thế giới đều làm chậm. Camera/LiDAR gần như
  không ảnh hưởng.
- **GPU:** WSLg mặc định render bằng CPU (llvmpipe), sóng sẽ rất giật. `env.sh` đặt
  `GALLIUM_DRIVER=d3d12` để dùng card NVIDIA. Kiểm tra: `glxinfo -B` phải ra `D3D12 (NVIDIA ...)`.
- **Sóng:** gió 2.5 m/s (sóng khoảng 0.13 m), hợp với hồ kín như Hồ Đá. Gió 5 m/s của bản gốc là sóng
  biển khoảng 0.5 m, quá lớn cho phao 1.1 m.
- **Test song song:** đừng chạy thêm một Gazebo có `ArduPilotPlugin` cổng 9002 khi `run_boat.sh` đang
  mở — ArduPilot sẽ nói chuyện nhầm sang đó. Dùng `tools/integration_test.sh` (instance 1, cổng riêng).
- Khi tắt Gazebo có thể thấy `OGRE EXCEPTION ... mHlmsGlobalIndex` — lỗi lúc hủy cảnh của Gazebo,
  vô hại.
