vophucthinh2006/VEDC2026-Edge-AI-Autonomous-Rescue-Buoy-System/STM32F4/STM32F4.pdf

18/09/2026

STM32F4 Project
Configuration Report

## 1. Description

### 1.1. Project

Project Name | STM32F4
Board Name | custom
Generated with: | STM32CubeMX 6.16.1
Date | 09/18/2026

### 1.2. MCU

MCU Series | STM32F4
MCU Line | STM32F407/417
MCU name | STM32F407VGTx
MCU Package | LQFP100
MCU Pin number | 100

### 1.3. Core(s) information

Core(s) | Arm Cortex-M4

## 2. Pinout Configuration

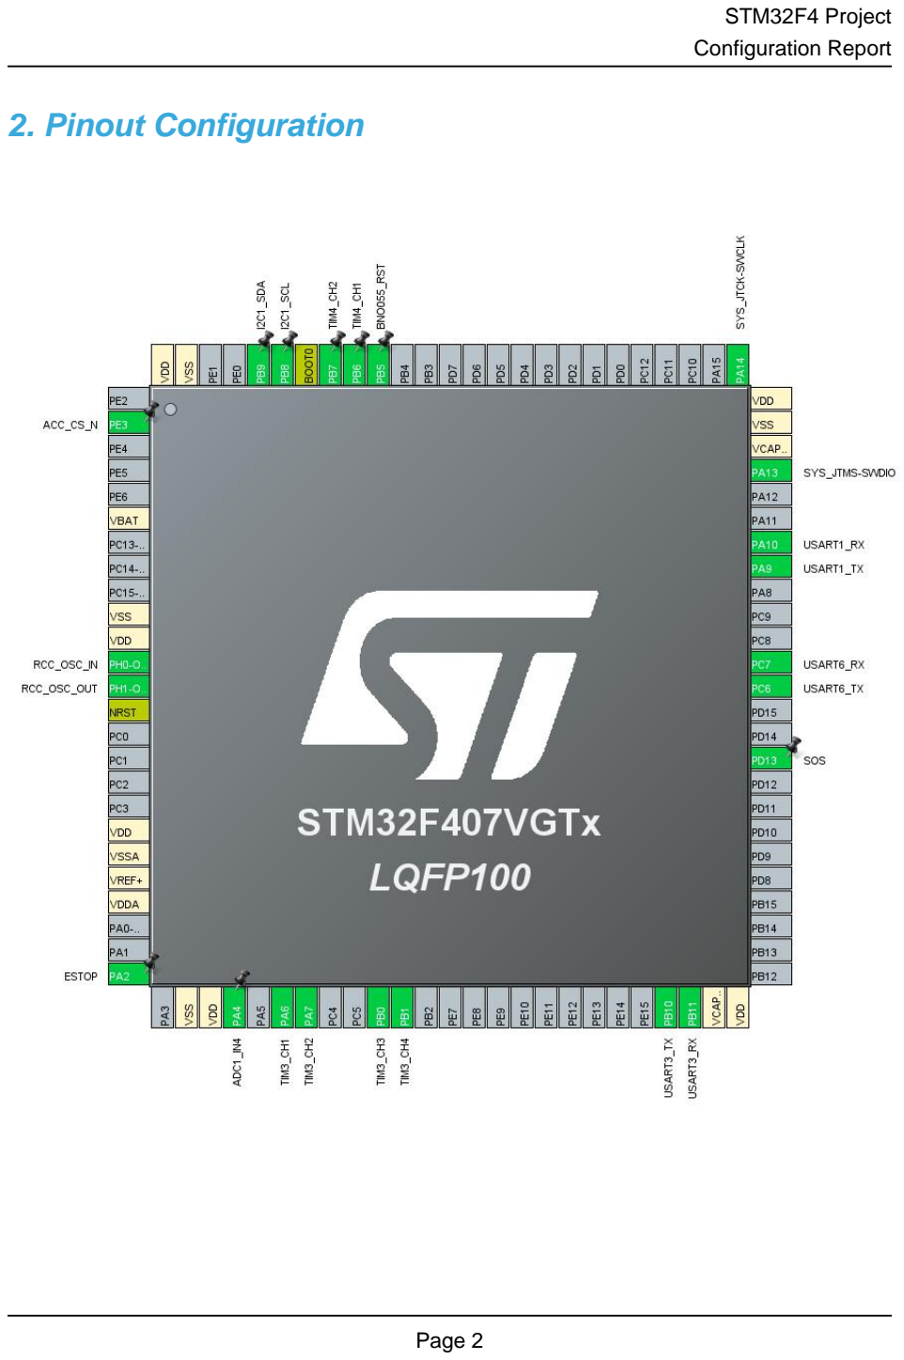
[picture p5: page 3]

## 3. Pins Configuration

Pin Number LQFP100 | Pin Name (function after reset) | Pin Type | Alternate Function(s) | Label
2 | PE3 * | I/O | GPIO_Output | ACC_CS_N
6 | VBAT | Power
10 | VSS | Power
11 | VDD | Power
12 | PH0-OSC_IN | I/O | RCC_OSC_IN
13 | PH1-OSC_OUT | I/O | RCC_OSC_OUT
14 | NRST | Reset
19 | VDD | Power
20 | VSSA | Power
21 | VREF+ | Power
22 | VDDA | Power
25 | PA2 * | I/O | GPIO_Input | ESTOP
27 | VSS | Power
28 | VDD | Power
29 | PA4 | I/O | ADC1_IN4
31 | PA6 | I/O | TIM3_CH1
32 | PA7 | I/O | TIM3_CH2
35 | PB0 | I/O | TIM3_CH3
36 | PB1 | I/O | TIM3_CH4
47 | PB10 | I/O | USART3_TX
48 | PB11 | I/O | USART3_RX
49 | VCAP_1 | Power
50 | VDD | Power
60 | PD13 * | I/O | GPIO_Output | SOS
63 | PC6 | I/O | USART6_TX
64 | PC7 | I/O | USART6_RX
68 | PA9 | I/O | USART1_TX
69 | PA10 | I/O | USART1_RX
72 | PA13 | I/O | SYS_JTMS-SWDIO
73 | VCAP_2 | Power
74 | VSS | Power
75 | VDD | Power
76 | PA14 | I/O | SYS_JTCK-SWCLK
91 | PB5 * | I/O | GPIO_Output | BNO055_RST
92 | PB6 | I/O | TIM4_CH1
93 | PB7 | I/O | TIM4_CH2

Pin Number LQFP100 | Pin Name (function after reset) | Pin Type | Alternate Function(s) | Label
94 | BOOT0 | Boot
95 | PB8 | I/O | I2C1_SCL
96 | PB9 | I/O | I2C1_SDA
99 | VSS | Power
100 | VDD | Power

* The pin is affected with an I/O function

## 4. Clock Tree Configuration

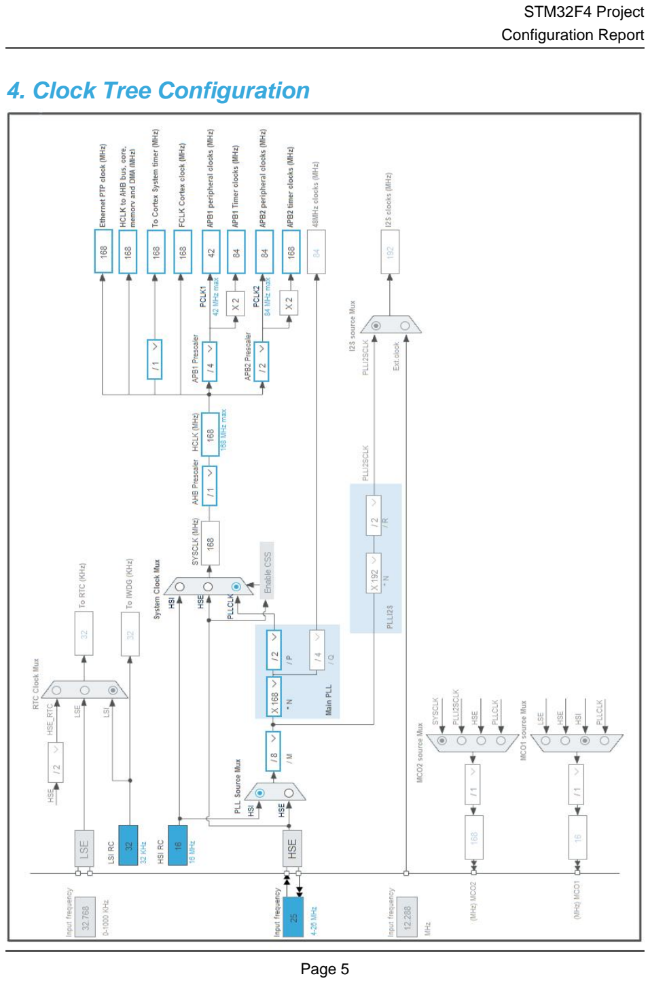
[picture p6: page 6]

## 1. Power Consumption Calculator report

### 1.1. Microcontroller Selection

Series | STM32F4
Line | STM32F407/417
MCU | STM32F407VGTx
Datasheet | DS8626_Rev8

### 1.2. Parameter Selection

Temperature | 25
Vdd | 3.3

### 1.3. Battery Selection

Battery | Li-SOCL2(A3400)
Capacity | 3400.0 mAh
Self Discharge | 0.08 %/month
Nominal Voltage | 3.6 V
Max Cont Current | 100.0 mA
Max Pulse Current | 200.0 mA
Cells in series | 1
Cells in parallel | 1

### 1.4. Sequence

Step | Step1 | Step2
Mode | RUN | STOP
Vdd | 3.3 | 3.3
Voltage Source | Battery | Battery
Range | Scale1-High | No Scale
Fetch Type | FLASH | n/a
CPU Frequency | 168 MHz | 0 Hz
Clock Configuration | HSE PLL | Regulator_LP Flash-PwrDwn
Clock Source Frequency | 4 MHz | 0 Hz
Peripherals
Additional Cons. | 0 mA | 0 mA
Average Current | 46 mA | 280 µA
Duration | 0.1 ms | 0.9 ms
DMIPS | 210.0 | 0.0
Ta Max | 98.47 | 104.96
Category | In DS Table | In DS Table

### 1.5. Results

Sequence Time | 1 ms | Average Current | 4.85 mA
Battery Life | 29 days, 4 hours | Average DMIPS | 210.0 DMIPS

### 1.6. Chart


## 2. Software Project

### 2.1. Project Settings

Name | Value
Project Name | STM32F4
Project Folder | D:\EMBEDDED\Competition\TKDT_2026\VEDC_2026\STM32F4
Toolchain / IDE | CMake
Firmware Package Name and Version | STM32Cube FW_F4 V1.28.3
Application Structure | Advanced
Generate Under Root | No
Do not generate the main() | No
Minimum Heap Size | 0x200
Minimum Stack Size | 0x400

### 2.2. Code Generation Settings

Name | Value
STM32Cube MCU packages and embedded software | Copy only the necessary library files
Generate peripheral initialization as a pair of '.c/.h' files | Yes
Backup previously generated files when re-generating | No
Keep User Code when re-generating | Yes
Delete previously generated files when not re-generated | Yes
Set all free pins as analog (to optimize the power consumption) | No
Enable Full Assert | No

### 2.3. Advanced Settings - Generated Function Calls

Rank | Function Name | Peripheral Instance Name
1 | SystemClock_Config | RCC
2 | MX_GPIO_Init | GPIO
3 | MX_I2C1_Init | I2C1
4 | MX_ADC1_Init | ADC1
5 | MX_TIM3_Init | TIM3
6 | MX_TIM4_Init | TIM4
7 | MX_USART1_UART_Init | USART1
8 | MX_USART3_UART_Init | USART3
9 | MX_USART6_UART_Init | USART6

## 3. Peripherals and Middlewares Configuration

### 3.1. ADC1

mode: IN4
3.1.1. Parameter Settings:

ADCs_Common_Settings:

Mode | Independent mode
ADC_Settings:
Clock Prescaler | PCLK2 divided by 4
Resolution | 12 bits (15 ADC Clock cycles)
Data Alignment | Right alignment
Scan Conversion Mode | Disabled
Continuous Conversion Mode | Disabled
Discontinuous Conversion Mode | Disabled
DMA Continuous Requests | Disabled
End Of Conversion Selection | EOC flag at the end of single channel conversion
ADC_Regular_ConversionMode:
Number Of Conversion | 1
External Trigger Conversion Source | Regular Conversion launched by software
External Trigger Conversion Edge | None
Rank | 1
Channel | Channel 4
Sampling Time | 3 Cycles
ADC_Injected_ConversionMode:
Number Of Conversions | 0
WatchDog:
Enable Analog WatchDog Mode | false

### 3.2. I2C1

I2C: I2C
3.2.1. Parameter Settings:

Master Features:

I2C Speed Mode | Fast Mode *
I2C Clock Speed (Hz) | 400000
Fast Mode Duty Cycle | Duty cycle Tlow/Thigh = 2
Slave Features:
Clock No Stretch Mode | Disabled

Primary Address Length selection | 7-bit
Dual Address Acknowledged | Disabled
Primary slave address | 0
General Call address detection | Disabled

### 3.3. RCC

High Speed Clock (HSE): Crystal/Ceramic Resonator
3.3.1. Parameter Settings:

System Parameters:

VDD voltage (V) | 3.3
Instruction Cache | Enabled
Prefetch Buffer | Enabled
Data Cache | Enabled
Flash Latency(WS) | 5 WS (6 CPU cycle)
RCC Parameters:
HSI Calibration Value | 16
HSE Startup Timout Value (ms) | 100
LSE Startup Timout Value (ms) | 5000
Power Parameters:
Power Regulator Voltage Scale | Power Regulator Voltage Scale 1

### 3.4. SYS

Debug: Serial Wire
Timebase Source: SysTick

### 3.5. TIM3

Clock Source : Internal Clock Channel1: PWM Generation CH1 Channel2: PWM Generation CH2 Channel3: PWM Generation CH3 Channel4: PWM Generation CH4
3.5.1. Parameter Settings:

Counter Settings:

Prescaler (PSC - 16 bits value) | 83 *

Counter Mode | Up
Counter Period (AutoReload Register - 16 bits value ) | 19999 *
Internal Clock Division (CKD) | No Division
auto-reload preload | Enable *
Trigger Output (TRGO) Parameters:
Master/Slave Mode (MSM bit) | Disable (Trigger input effect not delayed)
Trigger Event Selection | Reset (UG bit from TIMx_EGR)
PWM Generation Channel 1:
Mode | PWM mode 1
Pulse (16 bits value) | 1000 *
Output compare preload | Enable
Fast Mode | Disable
CH Polarity | High
PWM Generation Channel 2:
Mode | PWM mode 1
Pulse (16 bits value) | 1000 *
Output compare preload | Enable
Fast Mode | Disable
CH Polarity | High
PWM Generation Channel 3:
Mode | PWM mode 1
Pulse (16 bits value) | 1000 *
Output compare preload | Enable
Fast Mode | Disable
CH Polarity | High
PWM Generation Channel 4:
Mode | PWM mode 1
Pulse (16 bits value) | 1500 *
Output compare preload | Enable
Fast Mode | Disable
CH Polarity | High

### 3.6. TIM4

Clock Source : Internal Clock Channel1: PWM Generation CH1 Channel2: PWM Generation CH2
3.6.1. Parameter Settings:

Counter Settings:

Prescaler (PSC - 16 bits value) | 83 *
Counter Mode | Up
Counter Period (AutoReload Register - 16 bits value ) | 19999 *
Internal Clock Division (CKD) | No Division
auto-reload preload | Enable *
Trigger Output (TRGO) Parameters:
Master/Slave Mode (MSM bit) | Disable (Trigger input effect not delayed)
Trigger Event Selection | Reset (UG bit from TIMx_EGR)
PWM Generation Channel 1:
Mode | PWM mode 1
Pulse (16 bits value) | 1500 *
Output compare preload | Enable
Fast Mode | Disable
CH Polarity | High
PWM Generation Channel 2:
Mode | PWM mode 1
Pulse (16 bits value) | 1500 *
Output compare preload | Enable
Fast Mode | Disable
CH Polarity | High

### 3.7. USART1

Mode: Asynchronous
3.7.1. Parameter Settings:

Basic Parameters:

Baud Rate | 115200
Word Length | 8 Bits (including Parity)
Parity | None
Stop Bits | 1
Advanced Parameters:
Data Direction | Receive and Transmit
Over Sampling | 16 Samples

### 3.8. USART3

Mode: Asynchronous
3.8.1. Parameter Settings:

Basic Parameters:

Baud Rate | 9600 *
Word Length | 8 Bits (including Parity)
Parity | None
Stop Bits | 1
Advanced Parameters:
Data Direction | Receive and Transmit
Over Sampling | 16 Samples

### 3.9. USART6

Mode: Asynchronous
3.9.1. Parameter Settings:

Basic Parameters:

Baud Rate | 115200
Word Length | 8 Bits (including Parity)
Parity | None
Stop Bits | 1
Advanced Parameters:
Data Direction | Receive and Transmit
Over Sampling | 16 Samples

* User modified value

## 4. System Configuration

### 4.1. GPIO configuration

IP | Pin | Signal | GPIO mode | GPIO pull/up pull down | Max Speed | User Label
ADC1 | PA4 | ADC1_IN4 | Analog mode | No pull-up and no pull-down | n/a
I2C1 | PB8 | I2C1_SCL | Alternate Function Open Drain | No pull-up and no pull-down | Very High *
| PB9 | I2C1_SDA | Alternate Function Open Drain | No pull-up and no pull-down | Very High *
RCC | PH0-OSC_IN | RCC_OSC_IN | n/a | n/a | n/a
| PH1-OSC_OUT | RCC_OSC_OUT | n/a | n/a | n/a
SYS | PA13 | SYS_JTMS-SWDIO | n/a | n/a | n/a
| PA14 | SYS_JTCK-SWCLK | n/a | n/a | n/a
TIM3 | PA6 | TIM3_CH1 | Alternate Function Push Pull | No pull-up and no pull-down | Low
| PA7 | TIM3_CH2 | Alternate Function Push Pull | No pull-up and no pull-down | Low
| PB0 | TIM3_CH3 | Alternate Function Push Pull | No pull-up and no pull-down | Low
| PB1 | TIM3_CH4 | Alternate Function Push Pull | No pull-up and no pull-down | Low
TIM4 | PB6 | TIM4_CH1 | Alternate Function Push Pull | No pull-up and no pull-down | Low
| PB7 | TIM4_CH2 | Alternate Function Push Pull | No pull-up and no pull-down | Low
USART1 | PA9 | USART1_TX | Alternate Function Push Pull | No pull-up and no pull-down | Very High *
| PA10 | USART1_RX | Alternate Function Push Pull | No pull-up and no pull-down | Very High *
USART3 | PB10 | USART3_TX | Alternate Function Push Pull | No pull-up and no pull-down | Very High *
| PB11 | USART3_RX | Alternate Function Push Pull | No pull-up and no pull-down | Very High *
USART6 | PC6 | USART6_TX | Alternate Function Push Pull | No pull-up and no pull-down | Very High *
| PC7 | USART6_RX | Alternate Function Push Pull | No pull-up and no pull-down | Very High *
GPIO | PE3 | GPIO_Output | Output Push Pull | No pull-up and no pull-down | Low | ACC_CS_N
| PA2 | GPIO_Input | Input mode | Pull-up * | n/a | ESTOP
| PD13 | GPIO_Output | Output Push Pull | No pull-up and no pull-down | Low | SOS
| PB5 | GPIO_Output | Output Push Pull | No pull-up and no pull-down | Low | BNO055_RST

### 4.2. DMA configuration

nothing configured in DMA service

### 4.3. NVIC configuration

4.3.1. NVIC
Interrupt Table | Enable | Preenmption Priority | SubPriority
Non maskable interrupt | true | 0 | 0
Hard fault interrupt | true | 0 | 0
Memory management fault | true | 0 | 0
Pre-fetch fault, memory access fault | true | 0 | 0
Undefined instruction or illegal state | true | 0 | 0
System service call via SWI instruction | true | 0 | 0
Debug monitor | true | 0 | 0
Pendable request for system service | true | 0 | 0
System tick timer | true | 15 | 0
USART1 global interrupt | true | 0 | 0
USART3 global interrupt | true | 0 | 0
USART6 global interrupt | true | 0 | 0
PVD interrupt through EXTI line 16 | unused
Flash global interrupt | unused
RCC global interrupt | unused
ADC1, ADC2 and ADC3 global interrupts | unused
TIM3 global interrupt | unused
TIM4 global interrupt | unused
I2C1 event interrupt | unused
I2C1 error interrupt | unused
FPU global interrupt | unused
4.3.2. NVIC Code generation
Enabled interrupt Table | Select for init sequence ordering | Generate IRQ handler | Call HAL handler
Non maskable interrupt | false | true | false
Hard fault interrupt | false | true | false
Memory management fault | false | true | false
Pre-fetch fault, memory access fault | false | true | false
Undefined instruction or illegal state | false | true | false
System service call via SWI instruction | false | true | false
Debug monitor | false | true | false
Pendable request for system service | false | true | false
System tick timer | false | true | true
USART1 global interrupt | false | true | true
USART3 global interrupt | false | true | true
USART6 global interrupt | false | true | true

* User modified value

## 5. System Views

5.1. Category view
5.1.1. Current

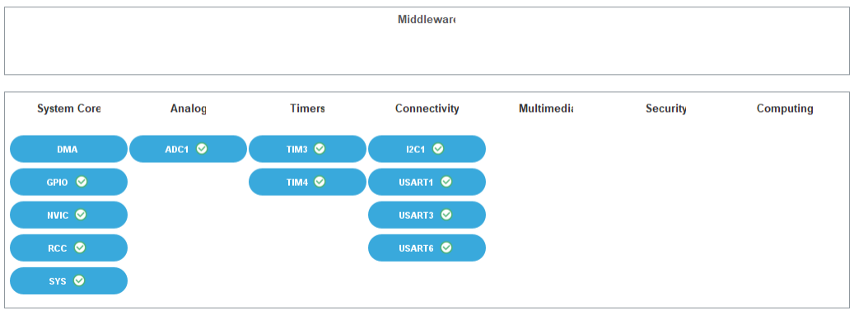
[picture p8: figure]

## 6. Docs & Resources

Type | Link
BSDL files | https://www.st.com/resource/en/bsdl_model/stm32f405-415_407-417_bsdl.zip
IBIS models | https://www.st.com/resource/en/ibis_model/stm32f405-415_407-417_ibis.zip
System View Description | https://www.st.com/resource/en/svd/stm32f4-svd.zip
Presentations | https://www.st.com/resource/en/product_presentation/stm32-stm8_embedded_software_solutions.pdf
Presentations | https://www.st.com/resource/en/product_presentation/stm32_eval-tools_portfolio.pdf
Presentations | https://www.st.com/resource/en/product_presentation/stm32_stm8_functi onal-safety-packages.pdf
Presentations | https://www.st.com/resource/en/product_presentation/stm32-stm8_software_development_tools.pdf
Presentations | https://www.st.com/resource/en/product_presentation/microcontrollers-stm32-family-overview.pdf
Flyers | https://www.st.com/resource/en/flyer/flstm32nucleo.pdf
Flyers | https://www.st.com/resource/en/flyer/flstm32trust.pdf
Product Certifications | https://www.st.com/resource/en/certification_document/stm32_authentication_can.pdf
Security Bulletin | https://www.st.com/resource/en/technical_note/tn1489-security-bulletin-tn1489stpsirt-physical-attacks-on-stm32-and-stm32cube-firmware-stmicroelectronics.pdf
Application Notes | https://www.st.com/resource/en/application_note/an1709-emc-design-guide-for-stm8-stm32-and-legacy-mcus-stmicroelectronics.pdf
Application Notes | https://www.st.com/resource/en/application_note/an2945-stm8s-and-stm32-mcus-a-consistent-832bit-product-line-for-painless-migration-stmicroelectronics.pdf
Application Notes | https://www.st.com/resource/en/application_note/an3070-managing-the-

| driver-enable-signal-for-rs485-and-iolink-communications-with-the-stm32s-usart-stmicroelectronics.pdf
Application Notes | https://www.st.com/resource/en/application_note/an3364-migration-and-compatibility-guidelines-for-stm32-microcontroller-applications-stmicroelectronics.pdf
Application Notes | https://www.st.com/resource/en/application_note/an3371-using-the-hardware-realtime-clock-rtc-in-stm32-f0-f2-f3-f4-and-l1-series-of-mcus-stmicroelectronics.pdf
Application Notes | https://www.st.com/resource/en/application_note/an3997-audio-playback-and-recording-using-the-stm32f4discovery-stmicroelectronics.pdf
Application Notes | https://www.st.com/resource/en/application_note/an3998-pdm-audio-software-decoding-on-stm32-microcontrollers-stmicroelectronics.pdf
Application Notes | https://www.st.com/resource/en/application_note/an4031-using-the-stm32f2-stm32f4-and-stm32f7-series-dma-controller-stmicroelectronics.pdf
Application Notes | https://www.st.com/resource/en/application_note/an4073-how-to-improve-adc-accuracy-when-using-stm32f2xx-and-stm32f4xx-microcontrollers-stmicroelectronics.pdf
Application Notes | https://www.st.com/resource/en/application_note/an4076-two-or-three-shunt-resistor-based-current-sensing-circuit-design-in-3phase-inverters-stmicroelectronics.pdf
Application Notes | https://www.st.com/resource/en/application_note/an4221-i2c-protocol-used-in-the-stm32-bootloader-stmicroelectronics.pdf
Application Notes | https://www.st.com/resource/en/application_note/an4488-getting-started-with-stm32f4xxxx-mcu-hardware-development-stmicroelectronics.pdf
Application Notes | https://www.st.com/resource/en/application_note/an4547-migrating-from-stm32f407xx417xx-to-stm32f427xx429xx437xx439xx-stmicroelectronics.pdf
Application Notes | https://www.st.com/resource/en/application_note/an4640-peripherals-interconnections-on-stm32f4057xx-stm32f4157xx-stm32f42xxx-stm32f43xxx-stm32f446xx-and-stm32f469479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
Application Notes | https://www.st.com/resource/en/application_note/an4655-virtually-increasing-the-number-of-serial-communication-peripherals-in-stm32-applications-stmicroelectronics.p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

Application Notes | https://www.st.com/resource/en/application_note/an4739-stm32cube-firmware-examples-for-stm32f4-series-stmicroelectronics.pdf
Application Notes | https://www.st.com/resource/en/application_note/an4750-handling-of-soft-errors-in-stm32-applications-stmicroelectronics.pdf
Application Notes | https://www.st.com/resource/en/application_note/an4803-highspeed-si-simulations-using-ibis-and-boardlevel-simulations-using-hyperlynx-si-on-stm32-mcus-and-mpus-stmic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
Application Notes | https://www.st.com/resource/en/application_note/an4821-migrating-from-stm32f405415-line-and-stm32f407417-line-to-stm32l4-series-and-stm32l4-series-microcontrollers-s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
Application Notes | https://www.st.com/resource/en/application_note/an4850-stm32-mcus-spreadspectrum-clock-generation-principles-properties-and-implementation-stmicroelectronics.pdf
Application Notes | https://www.st.com/resource/en/application_note/an4995-using-an-electromyogram-technique-to-detect-muscle-activity-stmicroelectronics.pdf
Application Notes | https://www.st.com/resource/en/application_note/an5027-interfacing-pdm-digital-microphones-using-stm32-mcus-and-mpus-stmicroelectronics.pdf
Application Notes | https://www.st.com/resource/en/application_note/an5073-receiving-spdif-audio-stream-with-the-stm32f4f7h7-series-stmicroelectronics.pdf
Application Notes | https://www.st.com/resource/en/application_note/an4899-stm32-microcontroller-gpio-hardware-settings-and-lowpower-consumption-stmicroelectronics.pdf
Application Notes | https://www.st.com/resource/en/application_note/an5612-esd-protection-of-stm32-mcus-and-mpus-stmicroelectronics.pdf
Application Notes | https://www.st.com/resource/en/application_note/an4838-introduction-to-memory-protection-unit-management-on-stm32-mcus-stmicroelectronics.pdf
Application Notes | https://www.st.com/resource/en/application_note/an4879-introduction-to-usb-hardware-and-pcb-guidelines-using-stm32-mcus-stmicroelectronics.pdf
Application Notes | https://www.st.com/resource/en/application_note/an5225-introduction-to-usb-typec-power-delivery-for-stm32-mcus-and-mpus-stmicroelectronics.pdf

Application Notes | https://www.st.com/resource/en/application_note/an5537-how-to-use-adc-oversampling-techniques-to-improve-signaltonoise-ratio-on-stm32-mcus-stmicroelectronics.pdf
Application Notes | https://www.st.com/resource/en/application_note/an4230-introduction-to-random-number-generation-validation-using-the-nist-statistical-test-suite-for-stm32-mcus-and-m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
Application Notes | https://www.st.com/resource/en/application_note/an2867-guidelines-for-oscillator-design-on-stm8afals-and-stm32-mcusmpus-stmicroelectronics.pdf
Application Notes | https://www.st.com/resource/en/application_note/an4013-introduction-to-timers-for-stm32-mcus-stmicroelectronics.pdf
Application Notes | https://www.st.com/resource/en/application_note/an4277-how-to-use-pwm-shutdown-for-motor-control-and-digital-power-conversion-on-stm32-mcus-stmicroelectronics.pdf
Application Notes | https://www.st.com/resource/en/application_note/an4908-getting-started-with-usart-automatic-baud-rater-detection-for-stm32-mcus-stmicroelectronics.pdf
Application Notes | https://www.st.com/resource/en/application_note/an5156-introduction-to-security-for-stm32-mcus-stmicroelectronics.pdf
Application Notes | https://www.st.com/resource/en/application_note/an5543-guidelines-for-enhanced-spi-communication-on-stm32-mcus-and-mpus-stmicroelectronics.pdf
Application Notes | https://www.st.com/resource/en/application_note/cd00211314-how-to-optimize-the-adc-accuracy-in-the-stm32-mcus-stmicroelectronics.pdf
Application Notes | https://www.st.com/resource/en/application_note/an2639-soldering-recommendations-and-package-information-for-leadfree-ecopack2-mcus-and-mpus-stmicroelectronics.pdf
Application Notes | https://www.st.com/resource/en/application_note/an5020-introduction-to-digital-camera-interface-dcmi-for-stm32-mcus-stmicroelectronics.pdf
Application Notes | https://www.st.com/resource/en/application_note/an3154-how-to-use-can-protocol-in-bootloader-on-stm32-mcus-stmicroelectronics.pdf
Application Notes | https://www.st.com/resource/en/application_note/an4566-how-to-extend-the-dac-performance-on-stm32-mcus-stmicroelectronics.pdf

Application Notes | https://www.st.com/resource/en/application_note/an5647-the-goertzel-algorithm-to-compute-individual-terms-of-the-discrete-fourier-transform-dft-in-stm32-products-stm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
Application Notes | https://www.st.com/resource/en/application_note/an2606-introduction-to-system-memory-boot-mode-on-stm32-mcus-stmicroelectronics.pdf
Application Notes | https://www.st.com/resource/en/application_note/an5036-guidelines-for-thermal-management-on-stm32-mcus-and-mpus-stmicroelectronics.pdf
Application Notes | https://www.st.com/resource/en/application_note/an3126-how-to-use-dac-for-audio-and-waveform-generation-on-stm32-mcus-and-mpus-stmicroelectronics.pdf
Application Notes | https://www.st.com/resource/en/application_note/an3155-how-to-use-usart-protocol-in-bootloader-on-stm32-mcus-stmicroelectronics.pdf
Application Notes | https://www.st.com/resource/en/application_note/an3156-how-to-use-usb-dfu-protocol-in-bootloader-on-stm32-mcus-stmicroelectronics.pdf
Application Notes | https://www.st.com/resource/en/application_note/an4286-how-to-use-spi-protocol-in-bootloader-on-stm32-mcus-stmicroelectronics.pdf
Application Notes | https://www.st.com/resource/en/application_note/an4759-introduction-to-using-the-hardware-realtime-clock-rtc-and-the-tamper-management-unit-tamp-for-stm32-mcus-stmic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
Application Notes | https://www.st.com/resource/en/application_note/an4776-how-to-use-generalpurpose-timer-peripheral-on-stm32-mcus-stmicroelectronics.pdf
Application Notes | https://www.st.com/resource/en/application_note/an4989-introduction-to-debug-toolbox-for-stm32-mcus-stmicroelectronics.pdf
Errata Sheets | https://www.st.com/resource/en/errata_sheet/es0182-stm32f405407xx-and-stm32f415417xx-device-errata-stmicroelectronics.pdf
Datasheet | https://www.st.com/resource/en/datasheet/dm00037051.pdf
Programming Manuals | https://www.st.com/resource/en/programming_manual/pm0214-stm32-cortexm4-mcus-and-mpus-programming-manual-stmicroelectronics.pdf
Reference Manuals | https://www.st.com/resource/en/reference_manual/rm0090-stm32f405415-stm32f407417-stm32f427437-and-stm32f429439-advanced-armbased-32bit-mcus-stmicroelectronics.pdf

Technical Notes
& Articles

https://www.st.com/resource/en/technical_note/tn0516-overview-of-thestm32f0xf100xxf103xx-and-stm32f2xxf30xf4xx-mcus-pmsm-singledual-

| foc-sdk-v40-stmicroelectronics.pdf
Technical Notes & Articles | https://www.st.com/resource/en/technical_note/tn1163-description-of-wlcsp-for-microcontrollers-and-recommendations-for-its-use-stmicroelectronics.pdf
Technical Notes & Articles | https://www.st.com/resource/en/technical_note/tn1205-tape-and-reel-shipping-media-for-stm8-and-stm32-microcontrollers-in-fpn-packages-stmicroelectronics.pdf
Technical Notes & Articles | https://www.st.com/resource/en/technical_note/tn1206-tape-and-reel-shipping-media-for-stm8-and-stm32-microcontrollers-in-qfp-packages-stmicroelectronics.pdf
Technical Notes & Articles | https://www.st.com/resource/en/technical_note/tn1207-tape-and-reel-shipping-media-for-stm8-and-stm32-microcontrollers-in-so-packages-stmicroelectronics.pdf
Technical Notes & Articles | https://www.st.com/resource/en/technical_note/tn1208-tape-and-reel-shipping-media-for-stm8-and-stm32-microcontrollers-in-tssop-and-ssop-packages-stmicroelectronics.p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
Technical Notes & Articles | https://www.st.com/resource/en/technical_note/tn1433-reference-device-marking-schematics-for-stm32-microcontrollers-and-microprocessors-stmicroelectronics.pdf
Technical Notes & Articles | https://www.st.com/resource/en/technical_note/tn1204-tape-and-reel-shipping-media-for-stm32-devices-in-bga-packages-stmicroelectronics.pdf
User Manuals | https://www.st.com/resource/en/user_manual/um3461-stm32f4-series-ulcsaiec-607301603351-selftest-library-user-guide-stmicroelectronics.pdf
