vophucthinh2006/VEDC2026-Edge-AI-Autonomous-Rescue-Buoy-System/media/simulation/img/01_toan_canh_tu_tren.jpg

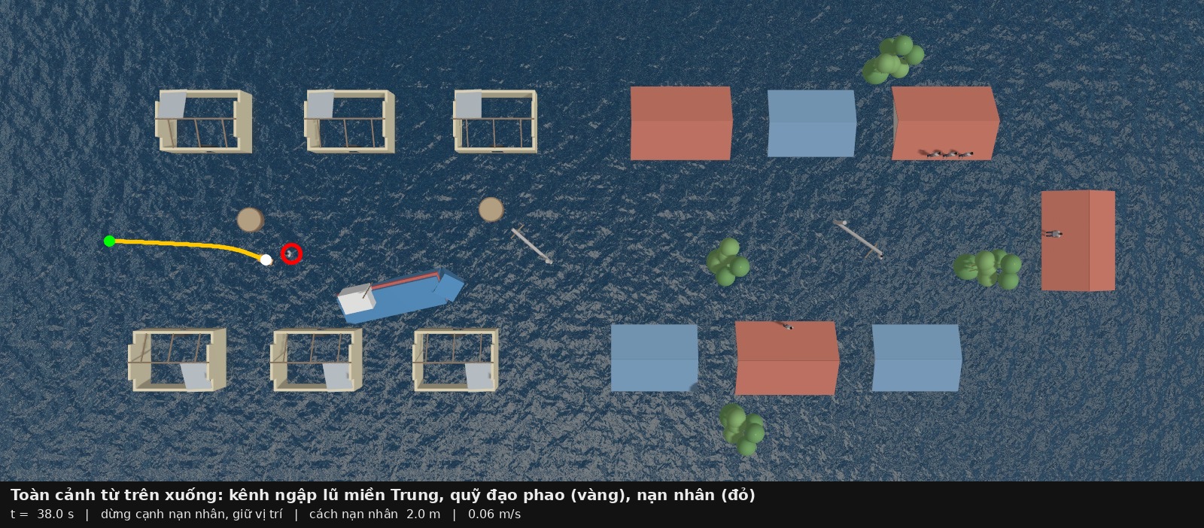
media/simulation/img/01_toan_canh_tu_tren.jpg
