vophucthinh2006/VEDC2026-Edge-AI-Autonomous-Rescue-Buoy-System/media/simulation/img/04_camera_phao.jpg

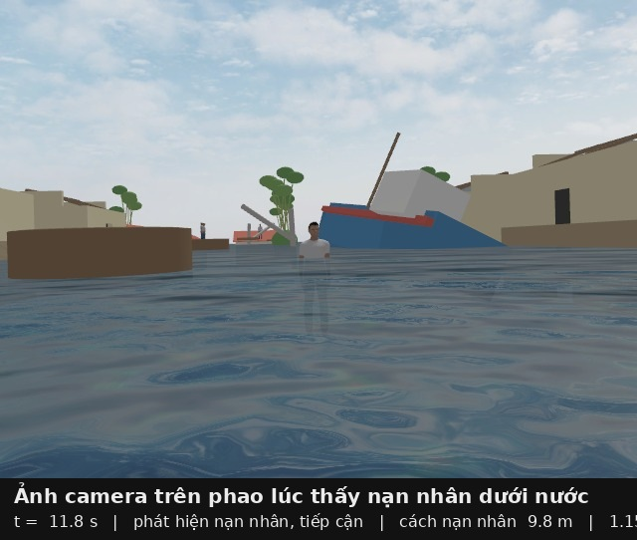
media/simulation/img/04_camera_phao.jpg
