vophucthinh2006/VEDC2026-Edge-AI-Autonomous-Rescue-Buoy-System/media/simulation/img/05_pi_phat_hien.jpg

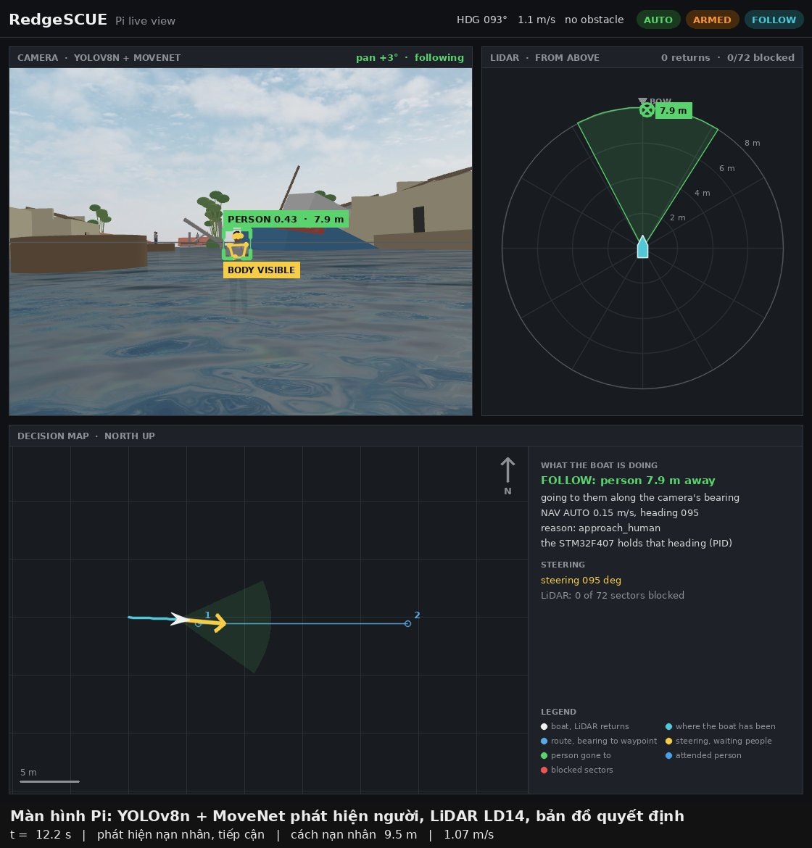
media/simulation/img/05_pi_phat_hien.jpg
