vophucthinh2006/VEDC2026-Edge-AI-Autonomous-Rescue-Buoy-System/media/simulation/img/09_pi_giu_vi_tri.jpg

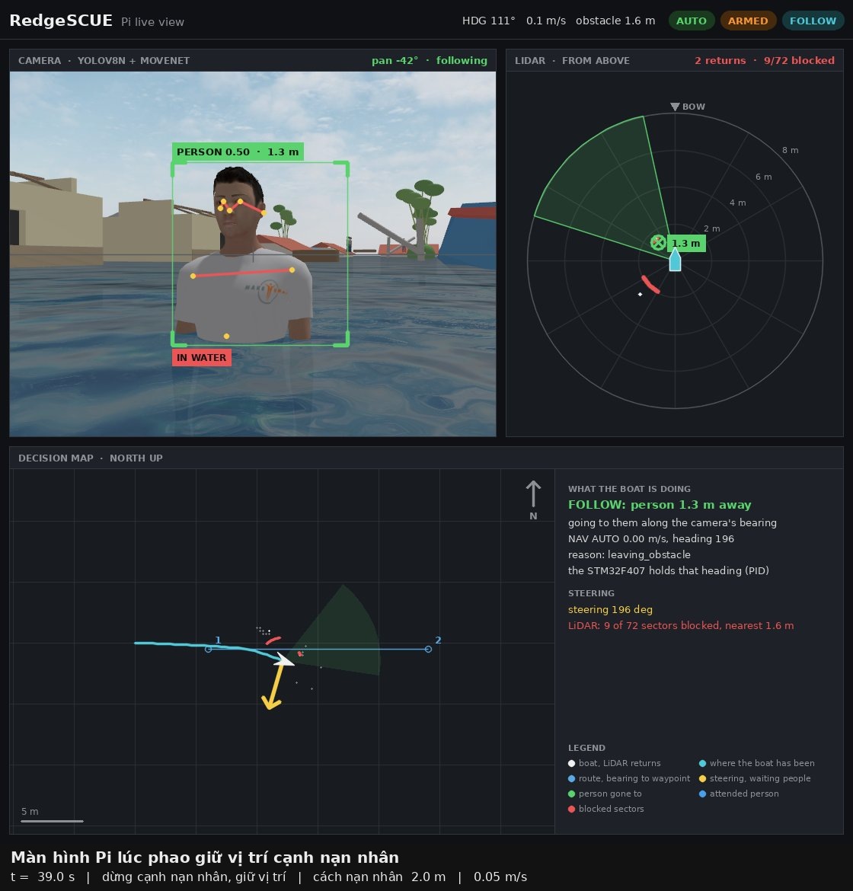
media/simulation/img/09_pi_giu_vi_tri.jpg
