vophucthinh2006/VEDC2026-Edge-AI-Autonomous-Rescue-Buoy-System/media/simulation/img/10_ket_thuc.jpg

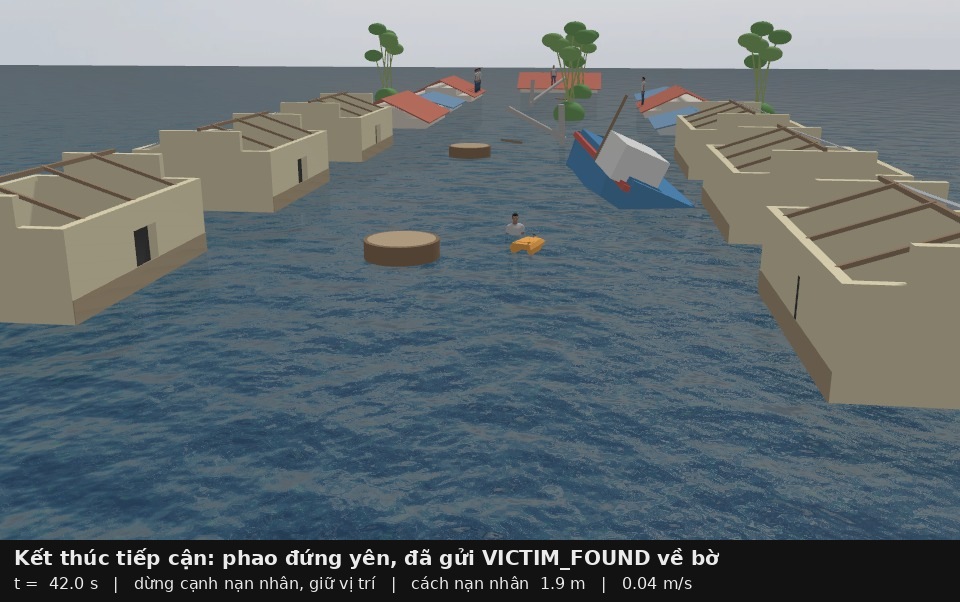
media/simulation/img/10_ket_thuc.jpg
