vophucthinh2006/VEDC2026-Edge-AI-Autonomous-Rescue-Buoy-System/sim/models/vedc_buoy/meshes/pod_rear_right.stl

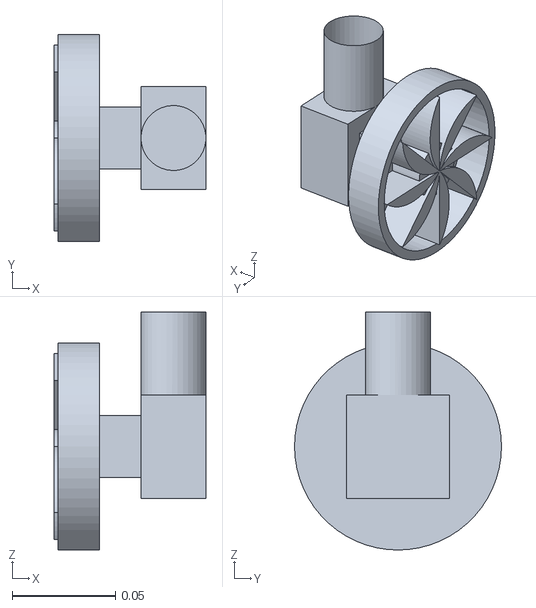
[picture p14: CAD file, 2026-10-04]
sim/models/vedc_buoy/meshes/pod_rear_right.stl
0.0734 x 0.1 x 0.115
