vophucthinh2006/VEDC2026-Edge-AI-Autonomous-Rescue-Buoy-System/sim/Thuyen.ETL.STL

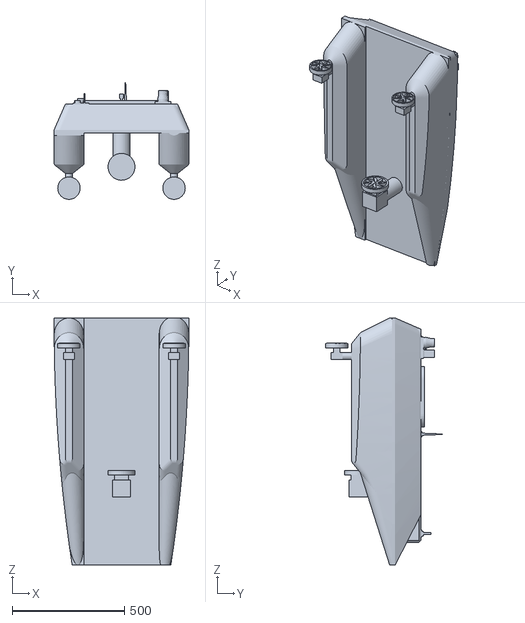
[picture p15: CAD file, 2026-10-04]
sim/Thuyen.ETL.STL
600.2 x 520.0 x 1100.0
