vophucthinh2006/VEDC2026-Edge-AI-Autonomous-Rescue-Buoy-System/sim/models/vedc_buoy/meshes/camera.stl

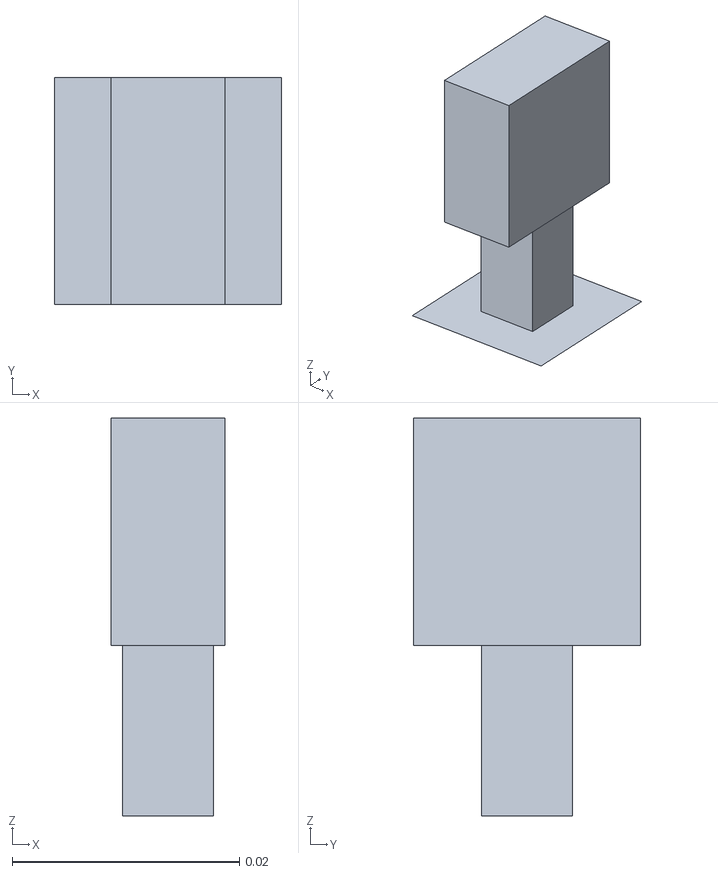
[picture p16: CAD file, 2026-10-04]
sim/models/vedc_buoy/meshes/camera.stl
0.02 x 0.02 x 0.035
