vophucthinh2006/VEDC2026-Edge-AI-Autonomous-Rescue-Buoy-System/sim/models/vedc_buoy/meshes/pod_front.stl

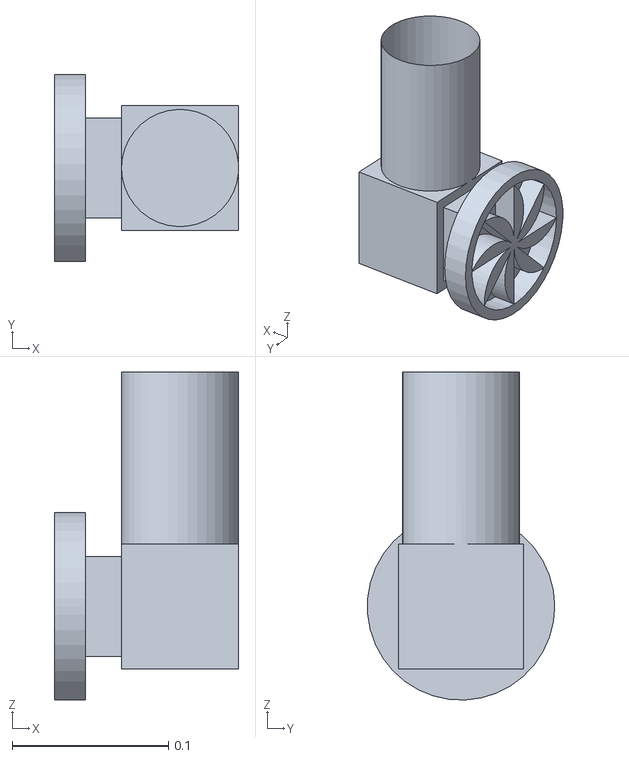
[picture p17: CAD file, 2026-10-04]
sim/models/vedc_buoy/meshes/pod_front.stl
0.118 x 0.12 x 0.21
