vophucthinh2006/VEDC2026-Edge-AI-Autonomous-Rescue-Buoy-System/sim/models/vedc_buoy/meshes/hull.stl

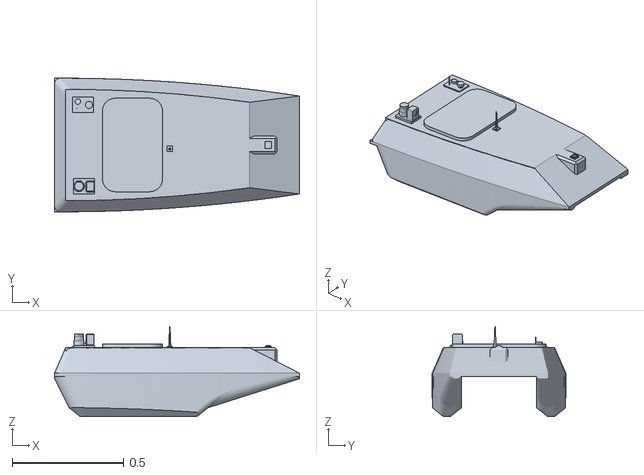
[picture p18: CAD file, 2026-10-04]
sim/models/vedc_buoy/meshes/hull.stl
1.10 x 0.6 x 0.405
