vophucthinh2006/VEDC2026-Edge-AI-Autonomous-Rescue-Buoy-System/(list of files, cad)

Other CAD files:
sim/models/vedc_buoy/meshes/pod_rear_left.stl
