vophucthinh2006/VEDC2026-Edge-AI-Autonomous-Rescue-Buoy-System/Rasp_Pi5/runtime/modules/state_store.py

"""Thread-safe latest-value state. Never retain mutable scan arrays without copying."""
from __future__ import annotations

from dataclasses import dataclass, field, replace
from threading import Lock
from time import monotonic

# Risk level of a person (modules/edge_model.py risk_level): on a boat, body seen, in the water, drowning.
SAFE, MEDIUM, HIGH, CRITICAL = 0, 1, 2, 3
RISK_NAMES = ("SAFE", "MEDIUM", "HIGH", "CRITICAL")


@dataclass(frozen=True)
class ImuState:
    pitch_deg: float = 0.0
    roll_deg: float = 0.0
    yaw_deg: float = 0.0
    imu_ok: bool = False
    overturned: bool = False
    timestamp: float = 0.0


@dataclass(frozen=True)
class GpsState:
    lat_deg: float = 0.0
    lon_deg: float = 0.0
    fix: int = 0
    hdop: float = 99.0
    speed_mps: float = 0.0
    course_deg: float = 0.0
    timestamp: float = 0.0


@dataclass(frozen=True)
class SysState:
    battery_v: float = 0.0
    motor_fault: bool = False
    estop: bool = False
    link_ok: bool = False
    timestamp: float = 0.0
    confirm_presses: int = -1   # STM32F407: presses of the victim's confirm button (PE4) since its boot; -1: not reported
    battery_pct: int = -1       # STM32F407 $SYS 9th field: charge 0..100; -1 unknown (battery_v is then still volts)


MAX_SKIPS = 16   # $SKP places kept (docs/victim-claim.md)


@dataclass(frozen=True)
class LinkState:
    """STM32F407 $LNK, once a second: whether the shore station has been heard lately (the F407
    calls it lost after 60 s), how long ago it was last heard (-1: never) and the station's GPS
    position, the boat's home. Firmware without $LNK leaves the default: link up, no home."""
    shore_ok: bool = True
    heard_ago_s: float = -1.0
    home: tuple[float, float] | None = None
    timestamp: float = 0.0
    hold: bool = False        # STOP from the dashboard: the F407 keeps the motors off until released
    ret: bool = False         # RETURN from the dashboard: go to home (this boat's own parking spot) and stay
    # $FOL: (leader, right_m, back_m) while the boat sails in formation behind leader, None otherwise
    follow: tuple[str, float, float] | None = None


@dataclass(frozen=True)
class LeaderState:
    """$LDR: the last beacon of the formation's leader the F407 heard on the LoRa channel."""
    buoy: str
    lat: float
    lon: float
    heading_deg: float          # its GPS course while it moves, else its compass; -1 unknown
    speed_mps: float
    timestamp: float


@dataclass(frozen=True)
class VehicleState:
    """STM32 status: run mode, armed flag, current route item, and waypoint geometry."""
    mode: str = ""
    armed: bool = False
    mission_seq: int = 0
    timestamp: float = 0.0
    mission_total: int = 0
    wp_dist_m: float = -1.0
    wp_bearing_deg: float = 0.0


@dataclass(frozen=True)
class NavState:
    """The Pi's commanded and target headings plus route points for the live-view map."""
    steer_bearing_deg: float | None = None
    target_bearing_deg: float | None = None
    route: tuple[tuple[int, float, float], ...] = ()
    timestamp: float = 0.0


@dataclass(frozen=True)
class HumanTarget:
    bearing_body_deg: float
    distance_m: float
    confidence: float
    timestamp: float
    risk: int = MEDIUM   # SAFE (on a boat), MEDIUM, HIGH (in the water), CRITICAL (drowning)


@dataclass(frozen=True)
class Snapshot:
    imu: ImuState
    gps: GpsState
    system: SysState
    obstacles: tuple[object, ...]
    scan_timestamp: float
    waypoint: tuple[float, float] | None
    human_target: HumanTarget | None          # the person the camera follows
    vehicle: VehicleState = VehicleState()
    human_targets: tuple[HumanTarget, ...] = ()  # everybody in the last frame, the followed one included
    focus: tuple[float, float] | None = None     # lat, lon of the person the rescue logic wants watched
    nav: NavState = NavState()
    link: LinkState = LinkState()
    leader: LeaderState | None = None            # the formation's leader, when one is heard
    goal_speed: float | None = None              # set by the mission in formation: the speed to go to waypoint at
    # $SKP: people another boat looks after or already rescued (docs/victim-claim.md), (lat, lon, when heard)
    skips: tuple[tuple[float, float, float], ...] = ()


class StateStore:
    def __init__(self) -> None:
        self._lock = Lock()
        self._imu = ImuState()
        self._gps = GpsState()
        self._system = SysState()
        self._obstacles: tuple[object, ...] = ()
        self._scan_timestamp = 0.0
        self._waypoint: tuple[float, float] | None = None
        self._human_target: HumanTarget | None = None
        self._human_targets: tuple[HumanTarget, ...] = ()
        self._focus: tuple[float, float] | None = None
        self._vehicle = VehicleState()
        self._nav = NavState()
        self._link = LinkState()
        self._leader: LeaderState | None = None
        self._skips: tuple[tuple[float, float, float], ...] = ()

    def update_link(self, shore_ok: bool, heard_ago_s: float, home: tuple[float, float] | None, hold: bool = False,
                    ret: bool = False) -> None:
        with self._lock:
            self._link = LinkState(shore_ok, heard_ago_s, home, monotonic(), hold, ret, self._link.follow)

    def update_follow(self, follow: tuple[str, float, float] | None) -> None:
        """$FOL: the boat's place in a formation, None when it sails in none."""
        with self._lock:
            self._link = replace(self._link, follow=follow)
            if follow is None or (self._leader is not None and self._leader.buoy != follow[0]):
                self._leader = None

    def update_leader(self, leader: LeaderState) -> None:
        with self._lock:
            self._leader = leader

    def update_skip(self, lat: float, lon: float) -> None:
        """$SKP: a person the shore station says to leave alone. The same place heard again is only
        made newer; the last MAX_SKIPS places are kept."""
        with self._lock:
            kept = tuple(s for s in self._skips if abs(s[0] - lat) > 1e-5 or abs(s[1] - lon) > 1e-5)
            self._skips = (kept + ((lat, lon, monotonic()),))[-MAX_SKIPS:]

    def update_vehicle(self, mode: str, armed: bool, mission_seq: int, mission_total: int = 0, wp_dist_m: float = -1.0,
                       wp_bearing_deg: float = 0.0) -> None:
        with self._lock:
            self._vehicle = VehicleState(mode, armed, mission_seq, monotonic(), mission_total, wp_dist_m, wp_bearing_deg)

    def update_steering(self, steer_bearing_deg: float, target_bearing_deg: float) -> None:
        with self._lock:
            self._nav = NavState(steer_bearing_deg % 360.0, target_bearing_deg % 360.0, self._nav.route, monotonic())

    def update_route(self, route: tuple[tuple[int, float, float], ...]) -> None:
        with self._lock:
            self._nav = NavState(self._nav.steer_bearing_deg, self._nav.target_bearing_deg, route, self._nav.timestamp)

    def update_imu(self, pitch: float, roll: float, yaw: float, imu_ok: bool, overturned: bool) -> None:
        with self._lock:
            self._imu = ImuState(pitch, roll, yaw % 360.0, imu_ok, overturned, monotonic())

    def update_gps(self, lat: float, lon: float, fix: int, hdop: float, speed: float, course: float) -> None:
        with self._lock:
            self._gps = GpsState(lat, lon, fix, hdop, speed, course % 360.0, monotonic())

    def update_system(self, battery: float, motor_fault: bool, estop: bool, link_ok: bool, confirm_presses: int = -1,
                      battery_pct: int = -1) -> None:
        with self._lock:
            self._system = SysState(battery, motor_fault, estop, link_ok, monotonic(), confirm_presses, battery_pct)

    def update_obstacles(self, obstacles: tuple[object, ...], scan_timestamp: float | None = None) -> None:
        with self._lock:
            self._obstacles = obstacles
            self._scan_timestamp = scan_timestamp if scan_timestamp is not None else monotonic()

    def set_waypoint(self, lat: float, lon: float) -> None:
        with self._lock:
            self._waypoint = (lat, lon)

    def update_human_target(self, target: HumanTarget | None) -> None:
        with self._lock:
            self._human_target = target
            self._human_targets = (target,) if target is not None else ()

    def update_human_targets(self, targets: tuple[HumanTarget, ...], followed: HumanTarget | None) -> None:
        """Everybody the detector found in one frame, and which of them the camera follows."""
        with self._lock:
            self._human_targets, self._human_target = targets, followed

    def set_focus(self, position: tuple[float, float] | None) -> None:
        """The person (lat, lon) the detector should keep the camera on, or None for its own choice."""
        with self._lock:
            self._focus = position

    def snapshot(self) -> Snapshot:
        with self._lock:
            return Snapshot(self._imu, self._gps, self._system, self._obstacles, self._scan_timestamp, self._waypoint, self._human_target, self._vehicle,
                            self._human_targets, self._focus, self._nav, self._link, self._leader, skips=self._skips)
