vophucthinh2006/VEDC2026-Edge-AI-Autonomous-Rescue-Buoy-System/Rasp_Pi5/runtime/modules/lidar_serial.py

"""The LiDAR on one of the Pi's UARTs (LDS-008 or LD14), for both runtimes.

Every revolution is turned to the boat's frame (bearing from the bow, clockwise) and handed to
to_obstacles, which decides what an obstacle is: clusters for the Pi's own potential field
(main.py), one per ray for the autopilot's avoidance (rescue_main.py). A revolution with nothing
in range still refreshes the state store, so "no obstacle" and "no LiDAR" stay apart: the decoders
pass a reading that saw nothing on as distance 0, intensity 0, which to_obstacles leaves out.
"""
from __future__ import annotations

import logging
import threading
from typing import Callable

import serial

from modules.lidar_ld14 import LD14Decoder, LidarPoint, ScanAssembler
from modules.lidar_lds008 import LDS008Decoder, START_COMMAND
from modules.state_store import StateStore

MODELS = ("ld14", "lds008")
REOPEN_S = 3.0


def in_sector(angle_deg: float, from_deg: float, to_deg: float) -> bool:
    """From from_deg clockwise to to_deg, both included; a sector may run across 0 (350 to 10)."""
    angle, start, end = angle_deg % 360.0, from_deg % 360.0, to_deg % 360.0
    return start <= angle <= end if start <= end else (angle >= start or angle <= end)


def drop_self_returns(scan: tuple[LidarPoint, ...], min_range_m: float, mask: list) -> tuple[LidarPoint, ...]:
    """The boat's own mast, cables and fittings, in the sensor's own angles (so a later yaw
    calibration does not move them): any return nearer than min_range_m, and in each mask sector
    [from_deg, to_deg, max_m] any return no further than max_m. A dropped return becomes "nothing
    seen" (distance 0, intensity 0), like the decoders report one, so the scan keeps its rays."""
    def own(point: LidarPoint) -> bool:
        if point.distance_m <= 0.0:
            return False
        if point.distance_m < min_range_m:
            return True
        return any(in_sector(point.angle_deg, float(a), float(b)) and point.distance_m <= float(m) for a, b, m in mask)
    return tuple(LidarPoint(p.angle_deg, 0.0, 0) if own(p) else p for p in scan)


def to_boat_frame(scan: tuple[LidarPoint, ...], yaw_offset_deg: float, anticlockwise: bool) -> tuple[LidarPoint, ...]:
    """The sensor's own angle may run anticlockwise seen from above, and its zero need not point
    at the bow; the boat's bearings run clockwise from the bow."""
    sign = -1.0 if anticlockwise else 1.0
    return tuple(LidarPoint((sign * point.angle_deg + yaw_offset_deg) % 360.0, point.distance_m, point.intensity) for point in scan)


class SerialLidar(threading.Thread):
    def __init__(self, model: str, port: str, baud: int, vehicle: dict, state: StateStore, stop_event: threading.Event,
                 to_obstacles: Callable[[tuple[LidarPoint, ...]], tuple[object, ...]], required: bool) -> None:
        super().__init__(name="lidar", daemon=True)
        self.model, self.port, self.baud, self.vehicle, self.state, self.stop = model, port, baud, vehicle, state, stop_event
        self.to_obstacles, self.required = to_obstacles, required
        self.log = logging.getLogger(__name__)

    def run(self) -> None:
        decoder, assembler = (LDS008Decoder() if self.model == "lds008" else LD14Decoder()), ScanAssembler()
        offset = float(self.vehicle["lidar_yaw_offset_deg"])
        anticlockwise = bool(self.vehicle.get("lidar_anticlockwise", False))
        min_range_m, mask = float(self.vehicle.get("lidar_min_range_m", 0.0)), list(self.vehicle.get("lidar_mask") or [])
        told = False
        while not self.stop.is_set():
            try:
                with serial.Serial(self.port, self.baud, timeout=0.1) as ser:
                    self.log.info("%s UART open: %s @ %d", self.model.upper(), self.port, self.baud)
                    told = False
                    if self.model == "lds008":
                        ser.write(START_COMMAND)   # the motor only spins once told to
                    while not self.stop.is_set():
                        scan = assembler.add(decoder.feed(ser.read(256)))
                        if scan is not None:
                            scan = drop_self_returns(scan, min_range_m, mask)
                            self.state.update_obstacles(self.to_obstacles(to_boat_frame(scan, offset, anticlockwise)))
            except (serial.SerialException, OSError) as exc:
                # required: the program cannot go on without it. Otherwise the scans simply stop,
                # whoever reads them sees them go stale, and the port is tried again (a USB adapter
                # that came loose and was pushed back in).
                if self.required:
                    self.log.error("%s UART unavailable: %s", self.model.upper(), exc)
                    self.stop.set()
                    return
                if not told:
                    told = True
                    self.log.warning("%s UART unavailable, no LiDAR data: %s", self.model.upper(), exc)
                self.stop.wait(REOPEN_S)
