vophucthinh2006/VEDC2026-Edge-AI-Autonomous-Rescue-Buoy-System/(commit log)

2026-09-14 stm32f4: add STM32CubeMX project for STM32F407VG
    CubeMX 6.16.1, FW_F4 V1.28.3, CMake + arm-none-eabi-gcc.
    I2C1 fast mode on PB6/PB7, PB5 as BNO055_RST output, SWD debug.
    AGENTS.md holds the working rules for this folder.
2026-09-14 stm32f4: add build and flash scripts
    build.bat builds with the CMake presets and exports .hex/.bin.
    flash.bat programs the ELF over ST-LINK with OpenOCD.
2026-09-14 stm32f4: add BNO055 driver with Roll/Pitch/Yaw output
    I2C driver following BST-BNO055-DS000-18: nRESET + POR wait, external
    32.768 kHz crystal, NDOF fusion, Euler angles in degrees, CALIB_STAT,
    calibration profile read/write with data sheet range checks.
    main.c reads the angles every 10 ms (100 Hz fusion output rate).
2026-09-14 stm32f4: load BNO055 calibration profile from source
    The profile (offsets + radius, data sheet 3.11.5) is kept in
    bno055_calib_profile.h so every F4 kit using the shared BNO055 module
    starts calibrated. Firmware captures the profile once CALIB_STAT is
    3/3/3/3; Tools/bno055_dump_calib.bat reads it over ST-LINK and
    regenerates the header.
2026-09-14 stm32f4: add STM32CubeMonitor dashboard for BNO055
    Roll/Pitch/Yaw chart and values, 8-point heading, init/read and
    calibration status. Variable addresses match build/Debug/STM32F4.elf.
2026-09-15 stm32f4: add BNO055 and STM32F407 datasheets
    bst-bno055-ds000.pdf: Bosch BNO055 data sheet rev 1.8 (BST-BNO055-DS000-18),
    referenced by section/table numbers in Modules/BNO055.
    dm00037051.pdf: ST STM32F405/407 datasheet.
2026-09-17 Fix submodule folders to normal directories
    [STM32F4.ioc, bno055.c, bno055.h, bno055_calib_profile.h, main.c, main.h]
2026-09-18 stm32f4: full pinout for rescue buoy peripherals
    Assign every peripheral the rescue buoy firmware needs, on top of the
    existing I2C1/BNO055 configuration:
    - USART1 PA9/PA10 115200 for the Raspberry Pi link
    - USART3 PB10/PB11 9600 for the Holybro M10 GPS
    - USART6 PC6/PC7 115200 for the FS-iA6B iBUS receiver
    - TIM3 CH1..CH4 (PA6/PA7/PB0/PB1) and TIM4 CH1/CH2 (PB6/PB7) as 50 Hz
    PWM, prescaler 83 and period 19999 so compare values are microseconds
    - ADC1_IN4 on PA4 reserved for battery sense
    - ESTOP on PA2, SOS on PD13, ACC_CS_N on PE3
    I2C1 moves from PB6/PB7 to PB8/PB9 because TIM4 CH1/CH2 needs PB6/PB7
    for the servos.
    ESTOP sits on PA2 rather than PA0: PA0 is the Discovery user button and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
2026-09-18 stm32f4: regenerate CubeMX code for new pinout
    Adds adc.c/tim.c/usart.c with MX_ADC1_Init, MX_TIM3_Init, MX_TIM4_Init
    and MX_USART1/3/6_UART_Init, the matching HAL ADC/TIM/UART drivers, and
    the USART1/3/6 interrupt handlers. Builds clean at 23008 B flash.
2026-09-18 stm32f4: import app logic from STM/ into Modules/App
    STM/ held the control logic but no CubeMX project, so it could not be
    built; STM32F4/ had the project but no control logic. Move the six app
    modules into the CubeMX project so one tree holds a buildable firmware.
    Files move unchanged. They are not compiled yet - CMakeLists.txt picks
    them up once main.c is wired in.
2026-09-18 stm32f4: back the app IMU API with the full-featured BNO055 driver
    STM/ carried a second, thinner BNO055 driver: no hard reset over the
    nRESET pin, no external-crystal select, no calibration profile, and no
    SYS_ERR check. Drop it and route the control loop through the driver in
    Modules/BNO055 instead.
    Modules/App/imu.c is a thin adapter. It owns the driver handle and keeps
    exporting the flat bno055_euler_t the control loop was written against,
    so control.c and the telemetry code need no changes beyond one include.
    It also maps the sensor's yaw onto the heading_deg the controller uses.
    Loading the shared calibration profile at init is the practical win: the
    buoy gets usable heading immediat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
    [bno055.c, bno055.h, control.h, imu.c, imu.h]
2026-09-18 stm32f4: read e-stop from PA2 with fail-safe polarity
    The e-stop moved off PA0, which is the Discovery user button and is
    wired active-high on the board with no way to change it. Use the
    generated ESTOP_Pin / ESTOP_GPIO_Port macros instead of the hardcoded
    GPIOA / GPIO_PIN_0 so the pin is defined in one place.
    Polarity inverts with the pin. PA2 has an internal pull-up and expects a
    normally-closed contact to GND: released reads low, pressed reads high,
    and an unplugged or cut e-stop cable also reads high and stops the
    motors. The previous active-low reading would have treated a broken
    cable as "not pressed" and kept the propellers running.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
    [control.c]
2026-09-18 stm32f4: wire the app main loop into the CubeMX skeleton
    Replaces the BNO055 bring-up demo in main.c with the control loop from
    STM/Core/Src/main.c, placed inside the USER CODE blocks so the next
    CubeMX generate keeps it. Compiles Modules/App and Modules/BNO055.
    SOS now goes through the generated SOS_GPIO_Port / SOS_Pin macros rather
    than a hardcoded GPIOD / GPIO_PIN_13.
    imu.c keeps bno055_euler, bno055_calib, bno055_init_status,
    bno055_read_status, bno055_calib_captured and bno055_calib_captured_valid
    as globals under those exact names, and keeps snapshotting the offsets at
    3/3/3/3. Tools/CubeMonitor/BNO055_Flow.json plots them and
    Tools/bno055_dump_calib.ps1 resolves the last two out of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
    [imu.c, main.c]
2026-09-18 repo: collapse the three STM32 trees into STM32F4/
    main carried the firmware in three places: STM/ (app logic, no CubeMX
    project, could not build), STM32F4/ (CubeMX project, no app logic) and
    bno055/ (a byte-identical copy of STM32F4/, left over from flattening a
    submodule). Only the merged STM32F4/ tree builds, so drop the other two.
    Nothing is lost: STM/'s modules moved into STM32F4/Modules/App earlier in
    this branch, and bno055/ was a copy of this same project. Both remain in
    git history.
    STM/README.md moves to STM32F4/README.md and is updated to match the
    hardware as configured: I2C1 on PB8/PB9, e-stop on PA2 wired
    normally-closed, PE3 holding the on-board accelerometer deselected, USB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
2026-09-18 stm32f4: split Modules/ by device and lift the app layer to App/
    Modules/App/ mixed two different kinds of code. Give each peripheral its
    own folder under Modules/ and move the application layer out:
    Modules/Actuators ESC and servo over TIM PWM
    Modules/BNO055 IMU driver, unchanged
    Modules/GPS NMEA parser
    Modules/IBUS FS-iA6B frame parser
    Modules/PiLink Raspberry Pi frame codec
    App/ control loop, IMU adapter, tuning constants
    The rule is now readable from the tree: main.c calls App/, App/ calls
    down into Modules/, and a module knows nothing about the layer above it.
    One arrow still points the wrong way: Modules/Actuators and Modules/PiL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
    [actuators.c, actuators.h, app_config.h, control.c, control.h]
2026-09-18 stm32f4: point the CubeMonitor flow at the current RAM addresses
    The flow reads globals by raw address, not by symbol, so every address
    in it went stale once the firmware grew the control loop and the RAM
    layout shifted. Deploying it as committed would have plotted whatever
    now sits at the old addresses, which looks like a working dashboard
    showing wrong numbers - worse than an obvious failure.
    Re-read all eleven addresses out of the current ELF with gdb and update
    them. Also drop the static on hbno055 so the dashboard can keep showing
    ext_crystal_active and sys_err, which is where a failed init explains
    itself.
    The tab note now says the addresses move on any change to the globals,
    and how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
    [imu.c]
2026-09-18 stm32f4: expand the README into a working guide
    The README documented the pinout but not how to work on the firmware, so
    the rules that matter were only in commit messages and review comments.
    Adds: the folder layout and the main -> App -> Modules layering rule, a
    pinout image, the workflow for changing a peripheral (edit the .ioc,
    never hand-edit Core/), where new code belongs, the USER CODE block map,
    build and flash, the CubeMonitor setup, a fault table, and a pre-PR
    checklist.
    Also writes down the traps that cost time in this branch: the closing
    brace of while(1) living inside USER CODE 3, the CubeMonitor flow holding
    raw RAM addresses that go stale silently, the globals in imu.c that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
2026-09-18 stm32f4: add the CubeMX pinout diagram
    Fills in the image README section 2 already pointed at.
    The render is soft on a few labels - PB5 comes out as BNO05S_RST where
    the .ioc says BNO055_RST, and PB6/PB7 read as TIM1 where they are TIM4,
    which PB6 cannot even do on this part. Note next to the image that the
    table and the .ioc are what to trust; worth replacing with a clean
    CubeMX export when someone has the tool open.
2026-09-18 stm32f4: correct how to re-export the pinout image
    The README told people to use Pinout > Export pinout image, which does
    not exist. That menu only offers "Export pinout with / without Alt.
    Functions" (Ctrl+U) and it writes a CSV pin list, not a picture.
    CubeMX has no command to save the chip diagram as an image at all. The
    sharp route is Project > Generate Reports, whose PDF carries the diagram
    as vector, then rasterise page 1 with pdftoppm. Documented with the
    command, plus the screenshot fallback and why it looks soft.
2026-09-18 stm32f4: replace the pinout image with a sharp one from the report
    The previous diagram was a rescaled screenshot, soft enough that PB5 read
    as BNO05S_RST and PB6/PB7 read as TIM1 - a timer PB6 cannot even reach on
    this part. Anyone trusting the picture over the table would have been
    misled.
    Regenerate it from Project > Generate Reports, whose PDF holds the
    diagram as vector: rasterise page 3 at 300 DPI, trim the page heading and
    margins, scale to 1800 px. Labels now read TIM4_CH1 / TIM4_CH2 and
    BNO055_RST, matching the .ioc. Drops the "image is blurry, trust the
    table" caveat.
    Commits STM32F4.pdf and STM32F4.txt alongside so the full configuration -
    pinout, clock tree, per-peripheral para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
2026-09-27 stm32f4: regenerate CubeMX for the Pinout (Hy) sheet
    Reconfigure STM32F4.ioc to match the team pinout and regenerate:
    - GPIO: LoRa RST/NSS, BNO055 RST, GPS switch/LED, two relays, EXTI for
    E-stop (PE4), BNO055 INT (PE2) and SX1278 DIO0-2 (PE11-13)
    - I2C1 PB8/PB9 at 400 kHz, SPI2 PB13-15 master mode 0
    - USART3 GPS with circular DMA RX, USART1/USART2 half-duplex iBus,
    UART4 PC10/PC11 for the Raspberry Pi via a USB-to-TTL adapter
    - TIM3 servos, TIM2 ESCs (TIM5 in the sheet is not on PA5), TIM8_CH3 buzzer
    - NVIC: E-stop 0, UART/DMA 5, sensor EXTI 6; UART register callbacks on
    - Drop ADC1, TIM4 and USART6
    The application code is not updated yet, so this commit alone does not build.
    Co-Autho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
    [STM32F4.ioc, main.c, main.h]
2026-09-27 stm32f4: build against the new peripheral map
    Point the app at the regenerated handles so the firmware builds and runs:
    - Pi link on UART4 instead of USART1, iBus RX on half-duplex USART2
    instead of USART6
    - Drive only TIM3 from the actuator module: it still assumes the old map,
    and handing it TIM2 would put 1500 us on two ESCs at boot
    - Drop the SOS output, which has no pin in the new sheet
    - Link with -u _printf_float so telemetry floats are not printed empty
2026-09-27 stm32f4: drive the beacon relays low from boot, move RELAY1 to PC3
    The beacon is wired through the relays' normally-closed contacts and the
    5 V relay module energises on a low input, so holding both inputs low at
    power-up is what keeps the beacon off. Both relay pins are now push-pull,
    no pull, reset state low.
    RELAY1 moves from PC0 to PC3: PC0 would not pull low (the pin read high
    with the output driven low), while PC3 behaves.
    [STM32F4.ioc, main.h]
2026-09-27 stm32f4: regenerate CubeMX for DShot on the rear ESCs and TIM5 for the front
    - TIM2 now clocks DShot300 for the rear ESCs (PA5 CH1, PA3 CH4): PSC 0,
    ARR 279, pulse 0, with its update request on DMA1 Stream7 (circular,
    word, high priority) for a burst into CCR1..CCR4
    - TIM2_CH2 is dropped; the front ESC on PA1 moves to TIM5_CH2 as plain
    50 Hz PWM with a 1500 us neutral, since it is bidirectional
    The rear ESCs ignored the PWM throttle range and have no calibration
    mode we could reach, but arm and run cleanly on DShot.
2026-09-27 stm32f4: add a DShot300 driver for the rear ESCs
    A circular DMA burst rewrites CCR1..CCR4 on every TIM2 update, so frames
    repeat in hardware at about 2 kHz and callers only change the value. Each
    frame is 16 bit slots followed by low slots that hold the line idle.
    A frame torn by a mid-update write fails its CRC and the ESC keeps the
    previous value, so no locking is needed.
2026-09-27 stm32f4: add a bench test for rudders, ESCs and buzzer
    With HW_TEST_ENABLED the control loop is replaced by App/hw_test.c, driven
    from the debugger through the hw_test block: per-group targets with run
    timers that fall back to safe values, a continuous rudder sweep, and a
    boot beep. Throttle is capped (1500 us rear, neutral +/-150 us front) and
    each run is time-limited, so a lost debugger still stops the motors.
    Rear ESCs take the microsecond scale converted to DShot; the front ESC
    stays on PWM with its own neutral. Also records the rudder centres found
    on the bench (front 1280, right 1460, left 1280 us).
    [app_config.h, hw_test.c, hw_test.h, main.c]
2026-09-27 stm32f4: rewrite Actuators for DShot rear, PWM front and rudder servos
    The module still drove the old map (TIM3 CH1-3 as ESCs), so a throttle
    command would have moved the camera and rudder servos. It now owns the
    Pinout (Hy) outputs: DShot300 rear ESCs on TIM2, the bidirectional front
    ESC on TIM5_CH2 and the four servos on TIM3.
    Commands are normalised (rear 0..1, front -1..1, steer -1..1). Speed-ups
    are ramped, cuts are immediate, and the front ESC rests at neutral before
    it reverses. The bench test now writes through the same pin tables.
    Control keeps its old manual and auto mixing for now.
    [actuators.c, actuators.h, app_config.h, control.c, control.h, hw_test.c, main.c]
2026-09-27 stm32f4: add a car-style manual mixer from iBUS channels
    The rear motors cannot reverse, so manual driving moves to the right
    stick: up drives the rear motors forward, down leaves them off and runs
    the front motor in reverse (also the brake), and sideways swings all
    three rudders. The left stick no longer drives the motors; it sets the
    power limit, so full right stick gives what the left stick allows.
    Letting go of the right stick stops the boat. CH4 is free now.
    [app_config.h, control.c, manual.c, manual.h]
2026-09-27 stm32f4: start the ESC ramp from one control period
    The first Actuators_Apply() after boot saw the whole uptime as elapsed
    and let the rear ESCs jump to 0.2 in one step. A gap longer than two
    control periods now counts as one.
2026-09-27 stm32f4: tighten arming and hold MANUAL until the speed stick is centred
    The arm check also required the power stick low, so raising it disarmed
    the boat. Arming is now an event: the switch must be seen off first, the
    power stick low, the speed stick centred and the mode on MANUAL. Once
    armed, only the switch and the safety checks (link, IMU, E-stop,
    overturn) disarm it, and a lost link or cleared E-stop never re-arms on
    its own.
    Coming back from AUTO, the motors stay stopped until the speed stick has
    been centred once.
    [control.c, control.h]
2026-09-27 stm32f4: document manual driving and the current ESC, servo, iBUS and E-stop pins
    The pin table still listed the old map: iBUS on USART6/PC7, E-stop on
    PA2, ESCs on TIM3 and servos on TIM4. It now follows Pinout (Hy), and a
    new section covers the FS-i6 setup, the channel layout and the arming
    rules. The clamp_us warning the build notes expected is gone.
2026-09-27 stm32f4: beep on boot, arming and disarming
    One beep when the firmware is up and when the boat arms, two when it
    disarms, so the driver hears the state without looking at a screen.
    The piezo on TIM8_CH3 gets a small non-blocking module ticked from the
    main loop.
2026-09-27 stm32f4: add a live RC and actuator monitor over ST-LINK
    Tools/rc_monitor.py reads ibus, control and actuator_debug from RAM
    through OpenOCD while the firmware runs, with addresses taken from the
    ELF, so a transmitter can be checked channel by channel without
    CubeMonitor or a halted core.
2026-09-27 stm32f4: run the control loop instead of the bench test
    ACTUATORS_ENABLED stays 0, so the ESCs hold stop and only the rudders
    follow the transmitter.
2026-09-27 stm32f4: let the boat arm without the IMU while it is not wired
    ARM_REQUIRES_IMU gates the fresh-IMU arming check so the motor chain can
    be tested on the bench before the BNO055 is connected. It is 0 for now
    and must go back to 1 before any water run; the overturn check only
    works with the IMU anyway.
2026-09-27 stm32f4: keep rc_monitor running past a few seconds
    OpenOCD's log went to a pipe that was never read; once it filled,
    OpenOCD blocked and the next read timed out after about five seconds.
    The log now goes to a temporary file, and a failed read reconnects
    instead of ending the run.
2026-09-27 stm32f4: read the tick right after the RC timestamp in rc_monitor
    The tick was read three probe reads after ibus, so read latency counted
    as RC age and a healthy link sometimes showed STALE. The frame age is
    now printed too.
2026-09-27 stm32f4: allow bench arming with the E-stop still on its NO contact
    The button is wired to its normally-open contact, which reads backwards.
    ESTOP_ENABLED at 0 keeps reading and reporting PE4 but lets the boat arm,
    so the transmitter and mixer can be tested on the bench with the ESCs
    held at stop. The build fails if ACTUATORS_ENABLED is 1 while the E-stop
    is ignored.
    [app_config.h, control.c]
2026-09-27 stm32f4: read the E-stop on its NO contact instead of ignoring it
    The button is wired to its normally-open contact. ESTOP_CONTACT_NC at 0
    inverts the reading so pressing it still stops the motors; only the
    cut-wire stop is lost, which a NO contact cannot give. This replaces
    the ESTOP_ENABLED bypass. Building with live ESCs on a NO contact or
    without the IMU check now warns that it is bench only.
    [app_config.h, control.c]
2026-09-27 stm32f4: keep rc_monitor logging through a probe dropout and flag resets
    Plugging in the ESC battery browned the board out and took the ST-LINK
    off USB; the reconnect then failed at once and ended the log. It now
    retries every second until the probe is back, and prints a line when
    the MCU uptime goes backwards.
2026-09-27 stm32f4: read whole words in rc_monitor
    Reads went byte by byte, so uwTick or last_rx_ms could be stitched from
    bytes of two values when the MCU bumped them mid-read. That gave the
    false STALE lines of about 257 ms and a false MCU RESET. Reads are now
    32-bit.
2026-09-29 stm32f4: set USART3 to 230400 baud for the GPS
2026-09-29 stm32f4: regenerate CubeMX for the USART3 baud
2026-09-29 stm32f4: add an SX127x LoRa driver for the RA-02
2026-09-29 stm32f4: send the GPS position to the shore station over LoRa
2026-09-29 stm32f4: add a LoRa and GPS monitor over ST-LINK
2026-09-29 stm32f4: document the LoRa wiring, frame and monitor
2026-09-29 esp32-lora-station: split the sx127x component into include and src
2026-09-29 esp32-lora-station: report LoRa packets and the station GPS to Cloudflare
2026-09-29 esp32-lora-station: add the Cloudflare Worker with Google admin login
2026-09-29 esp32-lora-station: add the responsive monitoring web UI
2026-09-29 esp32-lora-station: document the cloud setup and the dashboard
2026-09-29 esp32-lora-node: remove the node firmware, the boat now sends LoRa from the STM32
2026-09-30 stm32f4: add the CAM packet and drive the camera pan servo from it
    The Pi sends the camera angle over UART4 as $CAM,seq,deg; Camera_Tick turns it
    into a SERVO_CAMERA pulse (TIM3_CH1) whatever the arming state. Re-arm the UART4
    byte receive on error so one overrun no longer leaves the Pi link deaf.
    PI_LINK_TEST_ENABLED goes back to 0.
    [app_config.h, control.c, control.h, main.c, uart_protocol.c, uart_protocol.h]
2026-09-30 rasp_pi: track the nearest person with the camera servo
    Pick the person with the tallest box, feed uint8 SSD models raw pixels (the
    COCO SSD MobileNet quant never saw a person otherwise), estimate range from the
    box height while there is no LiDAR, and send the pan angle to the STM32 as CAM.
    Drain the whole TX queue each loop, and rename Stm32Uart._stop, which shadowed
    Thread._stop. lidar_required lets AUTO run without the LD14 (no obstacle
    avoidance, bench only).
    [ai_vision.py, perception.py, safety.py, settings.yaml, test_navigation.py, uart_comm.py]
2026-09-30 rasp_pi: add the UART4 link test and a live camera view
    cam_view serves an MJPEG stream with the detection overlay and can drive the
    camera servo over a USB-TTL adapter.
2026-09-30 stm32f4: point the contributing notes at the Claude skills
2026-10-01 stm32f4: read the gyro rate from the BNO055
2026-10-01 stm32f4: hold the heading with a gyro-damped PID, from the Pi or the RC
    - Heading = BNO055 yaw + mounting offset + magnetic declination; the
    IMU layer also tries the 0x28 address and exposes the turn rate.
    - PID in App/heading_controller.c: D on the gyro rate (low-passed), the
    integral held inside the deadband, anti-windup at the output limit.
    - Heading_Mix drives the rudders and splits the rear throttle, never
    below zero; speed 0 stops both motors instead of pivoting.
    - RC heading hold in MANUAL: forward throttle with the steering
    centred locks the heading once the turn settles.
    - Freshness checks compare signed: UART interrupts stamp data a tick
    newer than the loop's now, which w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
2026-10-01 stm32f4: send roll, pitch, yaw and the heading target in the LoRa beacon
    Frame: id=PHAO-01,lat,lon,r=,p=,y=,t=,m=,i=,c=,q= (NO_FIX keeps the
    attitude). Yaw and target are rounded to 0.1 deg before wrapping so they
    never print as 360.0, which the station would reject.
2026-10-01 stm32f4: add live BNO055 and heading-loop monitors over ST-LINK
2026-10-01 stm32f4: document the heading PID, the RC hold and the attitude beacon
2026-10-01 esp32-lora-station: parse the attitude fields of the LoRa frame
    lora_payload.c reads both the GPS-only frame and the attitude frame and
    forwards roll/pitch/yaw/target/mode/imu/calib/seq to the cloud. A bad
    attitude group drops only the attitude, the position is still sent.
2026-10-01 stm32f4: run the host unit tests for the heading PID and the LoRa parser
2026-10-01 esp32-lora-station: validate and keep the buoy attitude in the cloud
    sanitizeBuoy (cloud/src/telemetry.js) checks the attitude group's ranges;
    a bad group is dropped and flagged attitude_bad, the position is kept.
    Headings that round up to 360 wrap to 0. Tests: npm run test:telemetry.
2026-10-01 esp32-lora-station: show the buoy attitude and heading hold on the dashboard
2026-10-01 esp32-lora-station: document the attitude fields of the buoy telemetry
2026-10-03 sim: add the catamaran buoy, the wave model and the Ho Da lake world
    [model.sdf, vedc_lake.sdf]
2026-10-03 sim: add the ArduPilot Rover parameters of the buoy
    [vedc_buoy.parm]
2026-10-03 esp32-lora-station: accept MAVLink-sourced buoys and their nav group in the cloud
2026-10-03 esp32-lora-station: add the MAVLink to cloud bridge
2026-10-03 esp32-lora-station: show a Mission Planner style HUD for MAVLink buoys
2026-10-03 esp32-lora-station: document the MAVLink bridge, the nav group and the HUD
2026-10-04 rasp_pi: add the rescue logic: search, approach, hold, report, skip blocked waypoints
    [rescue.py, test_rescue.py]
2026-10-04 rasp_pi: feed LiDAR returns and keep-outs to the autopilot's avoidance
    [obstacle_feed.py, perception.py, test_obstacle_feed.py]
2026-10-04 rasp_pi: sweep the camera while searching, range people on roofs, add simulator inputs
2026-10-04 sim: build the buoy model from the team's CAD file
    [Thuyen.ETL.STL, camera.stl, hull.stl, model.sdf, pod_front.stl, pod_rear_left.stl, pod_rear_right.stl]
2026-10-04 sim: add avoidance parameters and launcher options for the Pi code and the flood scene
    [avoidance.parm, vedc_buoy.parm]
2026-10-04 sim: put a person in the lake scene and test the rescue end to end
    [model.sdf, vedc_lake.sdf]
2026-10-04 sim: add the flood scene: flooded street, obstacles, people in the water and on a roof
    [model.sdf, vedc_flood.sdf]
2026-10-04 sim: add a test measuring the camera's search swath
2026-10-04 sim: document the rescue scenario, the flood scene, the CAD model and the camera sweep
2026-10-04 rasp_pi: hold at a blocked last waypoint and skip far ones the boat makes no progress to
    [rescue.py, test_rescue.py]
2026-10-04 rasp_pi: add a smooth camera sweep as the default search pattern
2026-10-04 rasp_pi: add a live browser view of the camera, the detections and the LiDAR
2026-10-06 stm32f4: count the people the Pi reports, send the count in the LoRa frame, report armed and AUTO to the Pi
2026-10-06 esp32-lora-station: read the buoy's victim count and alert on the dashboard when it rises
2026-10-06 rasp_pi: add an LDS-008 LiDAR decoder and a raw capture tool
2026-10-06 rasp_pi: track several people in one frame, attend them one by one, tell a roof from a swimmer
2026-10-06 rasp_pi: add the paper's BAPF and velocity obstacle navigators and a Pi-steered test runner
2026-10-06 rasp_pi: wire the LiDAR choice and the AUTO sweep into the STM32 runtime, add run.sh and scene configs
2026-10-06 sim: add the two-person and village scenes, the two-person test and the avoidance comparison
    [vedc_two.sdf, vedc_village.sdf]
2026-10-06 stm32f4: add the FlySky FS-i6 and FS-iA6B manuals
2026-10-11 rasp_pi: add per-boat settings, the serial LiDAR and the STM32F103 helper board to the Pixhawk runtime
2026-10-11 stm32f103: add the CubeMX configuration of the helper board
2026-10-11 stm32f103: add the code generated by CubeMX
2026-10-11 stm32f103: add the build and flash scripts
2026-10-11 stm32f103: add the helper board firmware: Pi link, camera servo, alarm relays, E-stop, INA226, LoRa beacon, iBus sensor
2026-10-11 esp32-lora-station: forward the Pi's victim count from MAVLink to the cloud
2026-10-11 stm32f103: move the board's decisions out of the HAL glue, add a PC build of them for the simulator and a live monitor over ST-LINK
2026-10-11 rasp_pi: keep LiDAR revolutions coming over open water, reopen a lost LiDAR port, add an LDS-008 encoder for the simulator
2026-10-11 sim: reach the simulator the way the boat's hardware is reached: LDS-008 serial stand-in, STM32F103 stand-in, and a test of both paths
2026-10-11 sim: measure the boat with forward-only rear motors: fine on open water, not safe in the flooded street
2026-10-11 pixhawk: add the starting parameters of the real boat, with one-way rear motors and a low speed
2026-10-12 rasp_pi: turn the STM32 boat's bow to the person before going to them and keep it on them at the stand-off
2026-10-12 sim: add models of a roofless storm house, a wrecked fishing boat, a basket boat, bamboo and a broken power pole
2026-10-12 rasp_pi: add a decision map to the live view: the route, where the autopilot steers against where the waypoint is, the people and what the Pi is doing
2026-10-12 sim: measure a 30 degree camera sweep against the 60 degree one, add a sweep limit option
2026-10-14 rasp_pi: calibrate range and the standing test on the YOLOv8n boxes, take the int8 model's 0.34 scores
2026-10-14 rasp_pi: run the re-exported YOLOv8n at a 0.35 threshold measured on the simulated camera
2026-10-14 rasp_pi: take a LiDAR range for somebody standing only when it agrees with their box
2026-10-14 yolo_movenet: export the 320 px fine-tune to dynamic-range TFLite
    Same export as yolov8n_320_drq.tflite (tools/export_tflite.py): scores within
    0.011 of best_320.onnx on average over 226 frames. Not wired into the Pi yet;
    it is being checked in the simulator first.
2026-10-14 rasp_pi: run the 320 px fine-tuned YOLOv8n
    On the simulated camera it scores somebody on a roof 0.55 to 0.68 from 7 to
    12 m (0.25 to 0.35 before, often under the threshold) and somebody in a
    doorway 0.57 to 0.61 from 8 to 12 m (0.33 to 0.41). Its swimmer boxes are
    about 9 % taller, so person_height_m in sim.yaml goes 0.57 -> 0.62; standing
    boxes are unchanged.
2026-10-14 Revert "rasp_pi: run the 320 px fine-tuned YOLOv8n"
    This reverts commit 4145520.
    In vedc_central it went to 2 of 6 groups (run 8, the earlier model: 6 of 6).
    It took the wrecked boat for a person 1.7 m away; the people it attended
    there became no-go zones that closed the channel, and the boat returned
    home. Over 342 clean camera frames swept along the channel it puts 38 %
    more boxes on real people but 16 boxes on nothing (bamboo clumps mostly),
    against 1 for the earlier model, and still 4 at a 0.65 threshold.
2026-10-17 boat: deploy the detector's TFLite models with Rasp_Pi
    camera.model_path points at ../YOLO_Movenet/weights, which deploy never
    copied: on a fresh Pi the camera worker had no model. Copy the .tflite
    files next to PI_DIR; the .onnx and .pt stay on the PC.
2026-10-17 rasp_pi: add pymavlink and pin numpy below 2 for tflite-runtime
    rescue_main.py imports pymavlink, which the requirements left out.
    tflite-runtime 2.14 is built against numpy 1.x and fails with
    "_ARRAY_API not found" under numpy 2; opencv 4.12 and later need numpy 2,
    so cap it too. Checked on the Pi 4: both models load and run.
2026-10-17 rasp_pi: add a probe that names what is on each serial port
    With the helper board, LiDAR and TELEM2 all on CP2102 adapters without
    serial numbers, /dev/ttyUSBn swaps between boots. port_probe.py listens
    on every by-path port at the boat's bauds, wakes an LDS-008, tells the
    helper board's $AUX, MAVLink heartbeats and LiDAR packets apart, spots
    an adapter whose TX and RX are joined, and prints the config lines.
2026-10-17 docs: add Pi setup, flashing and USB adapter notes to the porting checklist
    What the first bench session on the Pi 4 needed: the config.txt UART
    lines, the venv, reading get_throttled for undervoltage, flashing the
    F103 from one power source only, and wiring all three links through
    USB-to-TTL with by-path port names.
2026-10-17 rasp_pi: open the camera and the MAVLink port by a stable /dev path
2026-10-17 rasp_pi: name the Pixhawk boat's adapters and camera by USB socket and serial
2026-10-18 stm32f4: accept NAV again after the Pi restarts
    The sequence check dropped every NAV whose number was not newer than
    the last one, so a restarted Pi counting from zero was ignored until it
    passed the old number. Only compare sequences while the stream is live
    (a NAV within NAV_TIMEOUT_MS); after a gap any sequence starts afresh.
2026-10-18 stm32f4: PWM ESCs on TIM2, smooth camera pan and a PE4 confirm button
    - All three ESCs on TIM2 PWM (CubeMX): front PA1 CH2, right PA3 CH4,
    left PA5 CH1. DShot and TIM5 are gone; PE3 stays a high output.
    - Rear ESCs (unbranded 30 A, no calibration) turn from 1500 us: any
    demand above zero maps onto 1500..2000 us. The front ESC pushes
    forward below 1500 us (ESC_FRONT_DIR -1).
    - Camera servo: 11 us/deg, 600..2400 us, and App/camera_pan.c glides
    it to the CAM angle like the simulator's joint controller.
    - PE4 is the victim's "supplies taken" button, not an E-stop:
    App/confirm_button.c debounces and counts presses, sent as the 8th
    field of $SYS.
    - USART2 is re-armed after a UART error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
2026-10-18 rasp_pi: 640 px detector, NEAR_CAMERA rule, 20 Hz pan and snapshots
    - The detector runs yolov8n_640_int8 (float32 I/O, 1x6x8400 out).
    - NEAR_CAMERA: a person whose box touches the frame edge is too close
    for the lower-body water call and is reported on land.
    - CameraReader reopens a camera that dropped off USB (camera_lost_s).
    - A pan thread sends CAM at pan_rate_hz (20) so the F407 glides the
    servo; tracking uses the pan read right after each frame.
    - snapshot_dir saves frames with skeletons and state labels when a
    person is seen; bench configs for the Rapoo camera and snapshots.
2026-10-18 rasp_pi: drop the boat's own LiDAR returns, LD14 encoder, F407 probe
    - drop_self_returns: returns nearer than vehicle.lidar_min_range_m and
    those inside a lidar_mask sector [from, to, max_m] (sensor angles,
    before the yaw offset) become "nothing seen". tools/lidar_near.py
    lists near returns and whether the filter drops them.
    - lidar_ld14 can encode packets and whole scans, for the simulator.
    - port_probe names an STM32F407 from its $IMU/$SYS lines.
2026-10-18 rasp_pi: pool mission on the STM32 boat: route, follow, geofence, voice
    - modules/waypoints.py: Route over config/mission_stm32.yaml or a QGC
    .waypoints file, with an optional geofence; tools/set_waypoints.py
    records points at the boat's position.
    - modules/follow.py: SEARCH the route, FOLLOW a person seen in
    confirm_frames passes, back to the route after lost_s. VICTIM_FOUND
    carries the person's reckoned position.
    - safety.py stops the boat outside the geofence.
    - $SYS confirm_presses: each new press plays "Da xac nhan lay do";
    modules/announcer.py plays sounds/ through aplay.
    - boat_stm32.yaml: pool speeds, ports by USB socket; settings.yaml:
    640 model, LD14, bow offset -8 deg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
2026-10-18 sim: emulate the LD14 on the hardware path
    sim/tools/ld14_emulator.py turns the Gazebo scan into LD14 packets on a
    PTY; hw_standins.sh picks it with VEDC_LIDAR_MODEL (ld14 by default)
    and the buoy's LiDAR runs at the LD14's 6 Hz and 384 samples.
2026-10-18 docs: specify how a route goes from the dashboard to the STM32 boat over LoRa
2026-10-18 esp32-lora-station: answer the buoy's beacons with the route sent from the dashboard
2026-10-18 stm32f4: take route frames over LoRa and hand the route to the Pi
2026-10-18 esp32-lora-station: add the send-to-buoy endpoint and button with delivery status
2026-10-18 rasp_pi: assemble the $RTE route the STM32 passes on
2026-10-18 sim: simulate the STM32F407 board and the LoRa shore station for main.py (--stm32)
2026-10-18 sim: follow the F407's confirm button, live-stream NAV check and LD14 in --stm32
2026-10-19 stm32f4: add stand-only flags to run AUTO without the IMU and arm from PE4
    BENCH_IGNORE_IMU lets AUTO drive on the last heading the BNO055 read, with the
    turn rate taken as 0, so the PID steers by the camera's bearing to the person.
    BENCH_PE4_ARM makes the PE4 button the arm switch when there is no RC: one press
    arms in AUTO, the next disarms. Both are 0 for the water and warn when set.
2026-10-19 stm32f4: clear a UART overrun before re-arming reception
    HAL only reads DR when RXNE is set, so an overrun caught with RXNE already clear
    left ORE set; re-arming RXNEIE on it fired the interrupt again for ever. Seen on
    the stand stuck in USART3 (GPS, SR 0xD8): the main loop stopped, no telemetry to
    the Pi, no PE4.
2026-10-19 stm32f4: add a HwTest build and motor_test.bat to run the three motors on the stand
    The HwTest preset builds App/hw_test.c in place of the control loop, with the
    rear cap at 1800 us and the front swing at +-300 us, without editing
    app_config.h. motor_test.bat (STM32F4/Tools/motor_test.ps1) builds and flashes
    it, sets the pulse of each ESC and the run time over the ST-LINK, and reads the
    pulses back from TIM2; the firmware stops the motors when the time runs out.
2026-10-19 rasp_pi: lay the viewer out in cards with a status header
    A header with mode, arming and phase chips and the heading, speed and nearest
    obstacle; the camera, the LiDAR and the decision map each in a titled card;
    text drawn with DejaVu through Pillow (OpenCV's font as the fallback). main.py
    now gives the map its phase and what the STM32 is told and why, instead of
    "no rescue logic here".
2026-10-19 rasp_pi: add the stand demo of the STM32 boat and run_normal.bat
    config/bench_demo.yaml: the camera servo follows and sweeps +-45 deg at
    15 deg/s, two sightings in 5 s start following (the Pi 4 looks about every
    1.2 s with the viewer on screen), the LiDAR no longer stops the boat on the
    stand, and vehicle.imu_required: false drives on the last heading.
    tools/bench_demo.sh restarts main.py with it and shows the viewer full screen on
    the HDMI screen; run_normal.bat flashes the F407 firmware and calls it.
2026-10-19 sim: run the STM32F407 boat in the central scene without ArduPilot
    sim/tools/f407_board_sim.py stands in for the F407 behind a pseudo-terminal:
    main.py's $NAV/$HBT/$CAM/$TXD in, $IMU/$GPS/$SYS/$ACK out from the buoy's
    odometry, and the thrusters, pods and camera joint driven with the firmware's
    own heading_controller.c and camera_pan.c built for the PC.
    stm32_central_test.sh runs main.py on it in vedc_central.sdf (the person in the
    doorway left out, two fixed cameras added) along a route past the person in the
    water; it passes when VICTIM_FOUND is sent and the boat rests 1.2-4 m from them
    (first runs: 1.74 and 1.76 m). record_media.py records the cameras and the Pi's
    viewer and composes capt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
2026-10-19 media: add stills and a 30 s video of the STM32F407 boat in the simulator
    Ten captioned stills and the video (Gazebo | the Pi's viewer) of
    sim/tools/stm32_central_test.sh: search, detection, approach and hold next to
    the person in the water, for the report.
2026-10-19 stm32f4: drop the RC transmitter: armed when safe, AUTO the only mode
    The FS-i6 / FS-iA6B and MANUAL mode are gone (App/manual.c, Modules/IBUS,
    the RC heading hold, the RC_* and MANUAL_* settings, BENCH_PE4_ARM). The boat
    is armed whenever the IMU is fresh (or BENCH_IGNORE_IMU) and it is not
    overturned; the motors turn only while the Pi drives with a fresh NAV AUTO and
    HBT. $SYS reports auto = 1. heading_debug loses the RC channels, and
    arm_block / block now say why it is not armed or not driving. USART2 is still
    set up by CubeMX but no longer read.
2026-10-19 stm32f4: follow the new heading_debug in the monitors, drop rc_monitor.py
    The OpenOCD Tcl probe lora_monitor.py borrowed from rc_monitor.py moves to
    Tools/openocd_probe.py.
2026-10-19 stm32f4: document the boat without a hand-held transmitter
    Section 13 now says how the boat arms and runs (a route from the dashboard,
    an empty route to stop, no hand-held stop) and how to check it on the stand
    with motor_test.bat; the pin table, PE4, the fault table and the protocol
    section drop the RC.
2026-10-19 rasp_pi: run only the dashboard's route on the STM32 boat, stand still without one
    mission.waypoints_from_file: false keeps only the mission file's geofence, so
    the route comes from the dashboard alone; follow.only_on_route: true stops the
    boat and follows nobody while there is no route (none sent, an empty one sent,
    or the last waypoint reached). boat_stm32.yaml sets both; the stand demo and
    the simulator test keep their old behaviour. The viewer shows WAITING.
2026-10-19 sim: the simulated F407 has no RC either
    stm32_board_sim.py drops --switch: armed when safe, AUTO the only mode, auto = 1
    in $SYS, as the firmware now does.
2026-10-19 esp32-lora-station: never resend a route the boat already took
    With no RC on the boat, a route resent after the F407 restarts (it reports
    rev 0) would set it off on the shore. The Hub marks a send delivered once the
    buoy reports the Pi has all of it, and GET /api/downlink then returns rev 0
    until the next send; the station sends nothing for rev 0. The dashboard says
    when a delivered route is no longer held by the boat, and that an empty route
    stops it. Hub tests run in Node without wrangler (npm test).
2026-10-20 stm32f4: add the battery, lights, front-motor brake and shore link; send victim, capsize and PE4 events
    INA226 battery percent, two relay lights switched from the dashboard, the front motor braking the coasting boat, the shore link (ACK with lights, stop and the station GPS, 60 s silence -> return home) and an event queue resent until the station acknowledges it. Host tests for the queue, shore link, front motor and GPS parser.
2026-10-20 rasp_pi: run the STM32 boat through a mission state machine and rank people by risk
    IDLE / PATROL / FOLLOW / RETURN / HOME_HOLD in modules/mission.py, risk levels from YOLOv8n + MoveNet, victim reports to the F407, announcer on confirm, $LNK shore status, and tools/stm32_lines.py to check the UART link.
2026-10-20 esp32-lora-station: answer every boat frame with an ACK and forward its events
    The ACK carries the light and stop commands and the station GPS; event frames (person, capsize, confirm) and the new beacon fields (battery, lights, course, speed, stop) go up to the Worker.
2026-10-20 esp32-lora-station/cloud: keep victims, alerts, light and stop commands
    GET /api/victims, POST /api/victims/clear, /api/lights and /api/hold; events deduplicated per buoy, nearby detections merged, commands handed to the station in /api/downlink.
2026-10-20 esp32-lora-station/web: show victims, capsize, battery, lights and the stop button
2026-10-20 sim: run the whole STM32 mission with the station, events and lights on the simulated radio
2026-10-20 scripts: add one script per STM32 boat function and run_all.bat
2026-10-20 docs: describe the whole STM32 boat system and the new LoRa frames
2026-10-20 esp32-lora-station/cloud: add address search through Nominatim
    GET /api/geocode?q= for guest and admin sessions returns up to five {name, lat, lon} in Vietnam. A single Geocoder in the Hub keeps Nominatim at one request per second overall and one uncached search per second per session, sends its own User-Agent (plus GEOCODE_CONTACT when set) and caches results for a day. Tests with a fake fetch and clock.
2026-10-20 esp32-lora-station/web: redesign the dashboard for judges and guests
    One big status word per buoy (waiting, patrolling, returning, stopped, signal lost, capsized), signal as four bars and a word, a battery bar, a people-to-rescue block, an event timeline instead of the technical log, route mode with waypoints only, and an address search that lists the buoys within 1/2/5 km. Drop the survey area, speed, file import/export, RSSI/SNR numbers and chart, attitude instruments, clocks, ruler and map style toggle; keep the Pixhawk HUD code hidden. The mock covers every status and answers address searches.
2026-10-20 esp32-lora-station/web: pop up when a buoy starts or stops running its route
    Patrolling now means the F407 reports mode A (the Pi is driving it), not just that the Pi took the route, so a stopped main.py no longer shows as patrolling. Starting, resuming and standing still again each show a popup and a timeline line.
2026-10-20 stm32f4: arm the rear ESCs at 1500 us and drive them from 1550 us
    Fixed on the stand: armed from 1000 us at power-up the rear right ESC never
    took a command. The rear stop is now 1500 us like the front neutral, the
    throttle 1550..2000 us, and every ESC is clamped at ESC_MIN_US so the front one
    still pushes forward below 1500 us. The bench test allows the full range and
    waits 6 s after a flash for the front ESC to arm.
2026-10-20 scripts: drive the motor test from scripts/stm32 and restart cleanly in run_all
    The motor test is now scripts/stm32/test_motor.bat. run_all.bat stops the
    station monitor and the main.py of an earlier run before it starts new ones,
    so the COM port and the F407's UART are free.
2026-10-20 stm32f4: add bench tests of the rudder servos and the camera sweep
    test_rudder.bat steers the three pods the way the heading controller does on
    the HwTest firmware; test_cam_servo.bat sweeps the camera servo through the
    normal firmware as the Pi does on a route.
2026-10-21 stm32f4: brake the front motor only off a throttle held for a second
    The Pi flickering between STOP and a creep (obstacle_too_close at a
    threshold) or between approach and stand-off reversed the front motor
    every 100 ms. The drop is now measured from the least throttle of a
    whole FRONT_BRAKE_HOLD_MS window: a blip between two stops brakes
    nothing, a run that ends still brakes as before. The simulated board
    follows the firmware.
2026-10-21 stm32f4: queue the Pi's events, report the IMU by freshness, recover I2C and a lost BNO055
    - $TXD from the Pi went through one slot: several back to back (people
    confirmed together) overwrote each other and only the last reached
    the shore. An 8-slot queue between the UART interrupt and the main
    loop (App/txd_queue.c) keeps them all.
    - $IMU's ok flag was imu.valid, cleared by a single failed I2C read: the
    Pi stopped the boat on it and the front motor braked. It now follows
    the same freshness rule as Control_Tick.
    - A slave holding SDA left I2C1 busy for good: every transfer waited
    25 ms and failed, and the INA226 search blocked the loop ~0.4 s.
    The bus is recovered (9 clocks, ST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
2026-10-21 rasp_pi: log every run to a file, say why the boat stops, reopen a lost UART
    - main.py logs to logs/main_<time>.log as well as the terminal, the
    newest logging.keep_runs kept; a thread that dies and the reason the
    program stops (signal, failure) go there too.
    - modules/drive_log.py: one line each time the boat stops or drives
    again, the F407 disarms, or it goes silent, with what the Pi knew.
    - uart_comm.py: a failing port (USB adapter dropping, a write timing
    out) is opened again every second instead of ending main.py; it also
    reads the GGA fix quality, and main.py sends headings through
    heading_tenths().
2026-10-21 sim: run the STM32 boat in the central scene with the dashboard
    scripts/stm32/sim_central.bat starts the Worker and the test sign-in,
    clears the local data of earlier runs, and runs sim/tools/stm32_web_sim.sh
    in WSL: Gazebo, the simulated F407, LD14 and shore station, main.py
    with its viewer, then prints the links. Three buoys on Ho Da 01: PHAO-01
    the boat, PHAO-02 and PHAO-03 only beaconing (tools/beacon_buoy_sim.py).
    The shore station stands on the bank and reports its position to the
    Worker every 10 s. A second simulation is refused while one runs.
2026-10-21 esp32-lora-station/cloud: sign the admin in through the test sign-in on wrangler dev
    Google refuses the made-up client id of .dev.vars (401 invalid_client).
    /api/config now says devSignIn when GOOGLE_JWKS_URL points at this
    machine (test/dev-idp.mjs), and never on the deployed Worker, whose
    tokens are checked against Google's keys anyway.
2026-10-21 esp32-lora-station/web: a page for relatives at /, the console at /admin, LoRa coverage
    - / (index.html, js/guest.js, css/guest.css): for relatives far away.
    They pick their home place, then read in plain words what the buoys
    within 5 km are doing and who was found there, the latest events and
    every buoy. No sign-in (a guest session is opened by itself), no
    commands, light and readable on a phone.
    - /admin (admin.html, was index.html): the console, for admins only; its
    sign-in links to the relatives' page. The test sign-in replaces
    Google's button on wrangler dev.
    - Both read buoy messages with state.js readBuoy() and share RISKS.
    - The shore station's LoRa coverage on the map: a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
2026-10-23 stm32f4: back off on the front motor at NAV BACK, read the Pi's mission and fps from $HBT
    NAV BACK turns the heading loop off and pulls the boat astern on the bidirectional front ESC alone, up to FRONT_BACK_MAX, so the Pi can free a bow wedged against an obstacle. $HBT now also carries the Pi's mission, its waypoint and its detector's frames a second x10, kept for the diagnostics frame.
2026-10-23 stm32f4: send the Pi's and the F407's diagnostics to the shore every 10 s
    A dg= LoRa frame of its own: the Pi's reason, mission and waypoint, why the F407 drives or not, the pack's volts and amps, the I2C and IMU recoveries, and the detector's fps when the Pi reports it. Host-tested by diag_frame_test.
2026-10-23 esp32-lora-station: post the boat's diagnostics frame to the Worker
    The station parses dg= frames (fps included), posts them beside the buoy's beacon and does not answer them.
2026-10-23 esp32-lora-station/cloud: keep and broadcast the boat's diagnostics
    sanitizeDiag checks every field, fps 0..100 included; the hub keeps the latest group per buoy and sends it to the dashboards.
2026-10-23 esp32-lora-station/web: a Pi and F407 card with the boat's diagnostics and the detector fps
    The console shows what the Pi does and why, why the motors run or not, the camera AI's frames a second, the pack and the recoveries, and warns of a low pack.
2026-10-23 rasp_pi: stop by the braking distance, swing the bow away or back off when boxed in
    The stop, slow and stand-off distances grow by what the boat still covers at the GPS speed (reaction_s, coast_s); the throttle goes off on overspeed. A bow blocked at rest turns away from the obstacle side in 15 deg steps, or backs off for 3 s on the front motor (NAV BACK) when the stern is clear. LiDAR clusters are capped at 0.5 m so a long wall no longer swells into a circle across the bow. Indoors without a fix (gps_required: false) the route runs along the bow.
    Found in the central scene: deadlocks behind the wreck, at walls and in dead ends.
2026-10-23 rasp_pi: leave a person after 3 min without a press, go home on a low pack held 30 s
    follow.max_hold_s ends a stay with somebody who cannot reach the button and ignores them for hold_ignore_s; return.battery_low_pct takes the boat home from any mission until battery_ok_pct, counting only a reading held battery_hold_s so a sag under the motors is not a low pack. The mission code and the waypoint go out for the dashboard.
2026-10-23 rasp_pi: run the detector on 4 threads, report its fps, draw the viewer only when watched
    YOLO and MoveNet get camera.num_threads (the runtime's default was one core). The detector's frames a second over the last 10 s go to the F407 in $HBT for the dashboard, and to the log every 30 s with the time per frame. The viewer no longer draws and encodes while no page is open. The STM32 boat's camera sweeps at 15 deg/s: at about 1 frame a second, 30 deg/s moved half the view between frames.
2026-10-23 scripts/stm32: run main.py as the vedc-boat service without the viewer, a stand demo for the judges
    install_service.sh makes main.py a systemd service that starts at boot and again after a crash; run_all restarts it on the code just deployed and no longer starts the viewer, which cost the detector fps. run_all stand (demo_stand.bat) adds config/stand_demo.yaml: the LiDAR avoids nothing round the stand. The test scripts stop the service before they take the UART.
2026-10-23 sim: the diagnostics frame, NAV BACK and the detector fps in the STM32 simulator
    The simulated F407 backs off on the front motor at NAV BACK and sends dg= frames with the Pi's fps; the simulated station posts them to the Worker. stm32_mission_test waits up to 120 s for the boat to head home instead of failing on its U-turn.
2026-11-02 esp32: four route slots by boat ID, RETURN and the formation role in the ACK
    The ACK takes cmd bit 3 for RETURN, the boat's own parking spot, and optional leader,right_m,back_m fields. Not compiled here: no ESP-IDF on this machine.
2026-11-02 stm32f4: pass RETURN and the formation role on to the Pi, add GPS-time LoRa slots
    shore_link takes the 6- or 9-field ACK, adds ret to $LNK and a follow line; lora_slot gives 4 slots of 2 s on GPS time, used by the simulator for now (the real boat keeps its free-running beacon).
2026-11-02 sim: several boats on one LoRa channel with collisions, and a comparison of fleet plans
    fleet_sim.sh starts up to 4 full boats (Gazebo model, board sim, Pi) against the station sim; the shared air drops overlapping frames and frames heard while sending. fleet_compare.py runs a plan headless and reports people found, area seen, distance, energy, repeats and the LoRa losses. vedc_wide.sdf: open flood water, 60 x 36 m, eight people.
2026-11-02 esp32: one person, one boat: the station gives each person to the first boat that reports them
    victim_claims.c (plain C, host-tested) keeps who looks after each person within 6 m; the ACK of a second boat's report names the person to leave alone (RouteDownlink_AckSkip, eleven fields), and other ACKs name owned or rescued people near the boat in turn. The owner's confirm button rescues them; the cloud's claims and a RETURN let them go. Not compiled here: no ESP-IDF on this machine.
2026-11-02 stm32f4: take the eleven-field ACK and pass the person to leave alone to the Pi as $SKP
2026-11-02 cloud: merge every boat's reports of a person, keep their owner and status, let the admin rescue, release or assign
    The first reporter owns the person (task victim); the owner's confirm button rescues them; a lost boat or one called home lets go. POST /api/victims/:vid {rescued|release|assign}; GET /api/downlink carries claims for the station.
2026-11-02 sim: victim claims in the station and board simulators, --no-claims, and the duplicate-stop metric
2026-11-03 scripts/stm32: sim_fleet.bat, a fleet of simulated boats to drive by hand from the dashboard
    Starts the Worker and the test sign-in, clears what earlier runs left on the boats (STOP, RETURN, routes, formation, people), then fleet_sim.sh in WSL. Options: 1-4 boats, world, headless, viewer, noclaims, holdNN.
2026-11-03 cloud: /api/weather and /api/gauges, the forecast, rain radar frames and river gauges for the map
    weather.js fetches and caches Open-Meteo (24 h at a point), RainViewer's radar frames and the VNDMS gauge levels (parsed from its map's popups; not an official API, sent with its Referer), and gives the last good answer marked stale while a source is down. The admin picks the flood depth layer's water level (POST /api/flood-level: a gauge, a typed level, or the nearest gauge).
2026-11-03 web: weather and flooding layers on the map (issue 4)
    A panel on both pages: the 24 h forecast at the station, the rain radar of the past 2 hours, NASA's satellite flood map, the river gauges by alarm level (numbered, not by colour alone) and an estimated flood depth (a water level minus the ground's height, labelled as an estimate). An error says why and offers a retry. The mock serves the new endpoints.
2026-11-03 web: console UI pass: light theme, tabs, event log kept, clearer area drawing, stacked toasts
    - the side panel under the people to rescue: Detail / Fleet / Events tabs (arrow keys), picking a boat opens its card
    - the event log survives a reload and keeps people apart from boats and commands
    - a high-contrast light theme for use out in the sun (css/light.css), remembered
    - toasts stack (3), red alerts stay 12 s with a close button
    - the search area: bold outline, numbered draggable corners, a line to the pointer, its size; bolder plan preview
    - map controls no longer overlap on phones; frosted panels; named map markers; 24-44 px targets; decimal commas
2026-11-03 web: the relatives' page: the weather and river at home, rescue status, sharing, the day's trend
    Home card: rain to come and the nearest gauge's level in plain words, gauges in alarm within 30 km; each person near home shows who looks after them or that they were rescued; 'Gửi cho người nhà' shares a link that opens on the same place; a chart of people found and rescued per hour. Keyboard focus ring and reduced motion as on the console.
2026-11-11 web: base map that holds up on a weak link: Worker tiles, a service-worker cache, a coarse backdrop
    Tiles come through /tiles/ and stay on the device (sw.js, /tiles/ only). A zoom-13 layer under the detail
    keeps the map blurry instead of grey while it loads, a tile the Worker cannot give is asked of OSM
    directly, and the tiles round the shore station are fetched once in the background.
2026-11-11 web: console as a helm: full-screen map, instrument row, rail and drawer, dock with the stop button
    Numbers and pictures instead of sentences, and only what the boats really send: rain, roll, pitch, the bow
    against the Pi's heading (in compass words), battery with INA226 volts and amps, LoRa. The panels of the old
    side column open from a rail, the weather panel and the legend move into it, and the modes and DỪNG PHAO sit
    in a dock. One motion vocabulary; a bottom sheet on phones.
2026-11-11 web: boats drawn as hulls with the bow and the Pi's heading, formation leader in its own colour
    The pin turns to the bow (IMU yaw, else the GPS course while moving): a solid line ahead of the bow and the
    heading the Pi asks for (target_yaw) dashed in cyan, as on the heading gauge; a dot when no heading is known.
    In a formation the leader's hull is magenta and every follower blue, read from the formation the Worker sends,
    so a new leader recolours at once; the ring keeps the status colour.
2026-11-13 Update: Raspberry Pi 5 program.
2026-11-14 Rasp_Pi5: keep split STM32 UART packets and add the buoy test service
    pyserial.readline() returns a partial line when its timeout expires, so a
    packet split across two reads was dropped. Buffer bytes until the newline,
    keep the NMEA frame after any binary preamble, and bound the buffer.
    Add the systemd unit that runs run_buoy_test.py, and name the USB ports by
    path in the config comments.
2026-11-14 esp32-lora-station: 4G Cat.1 fallback uplink over the Ca-01 module
    The station reaches the Worker over WiFi first and falls back to 4G when WiFi
    drops. The Ai-Thinker Ca-01 sits on UART2 (GPIO4 TX, GPIO5 RX) and runs PPP
    through esp_modem 1.4.x, so it is a normal esp_netif and the HTTPS code is
    unchanged. WiFi has the higher route priority; DNS is 8.8.8.8/1.1.1.1 on both.
    Tested on hardware (VinaPhone, CSQ 31): IP about 6 s after dialing from a clean
    module. When the ESP32 resets mid-session the module keeps the old PPP session
    and ATH, AT+CGACT=0,1 and AT+CFUN=0/1 do not clear it, so the station reboots
    the module with AT+CFUN=1,1 and has an IP again after about 24 s.
    The route poll now k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
