vophucthinh2006/VEDC2026-Edge-AI-Autonomous-Rescue-Buoy-System/(notices)

Notices in the files:
STM32F4/Core/Src/main.c:
Copyright (c) 2026 STMicroelectronics.
All rights reserved.
This software is licensed under terms that can be found in the LICENSE file
